AL-255/ventium/docs/FPGA_DOOM_2026-10-17.md

# FPGA Doom timedemo — 2026-10-17

**PASS: original DOS Doom shareware 1.9 completes DEMO3 at 20.50 FPS** on the
physical RK-XCZU15EG-F, measured **39.999830 MHz**, with **U/V + fast-pipe**.
This was a cold FreeDOS boot on the existing `2886d24c` image: no rebuild,
reprogramming, clock change, snapshot, guest patch, STEP or breakpoint.
It supersedes the [old image's startup failure](https://github.com/AL-255/ventium/blob/a4456e81/docs/FPGA_DOOM_2026-10-13.md), not
by substituting a slow/U-only control.

The fresh, closed `DOOM/DEMO3.LOG` reports:

```text
timed 2134 gametics in 3644 realtics
```

The original WAD's embedded DEMO3 independently contains exactly **2,134
single-player tics**. At 35 realtics/second, this is **104.114286 seconds** and
`35 × 2134 / 3644 = 20.496707 FPS`. This is rendered timedemo throughput,
not capture cadence or a higher-clock projection. See id Software's
[timedemo result path](https://github.com/id-Software/DOOM/blob/master/linuxdoom-1.10/g_game.c)
and [35 Hz tick definition](https://github.com/id-Software/DOOM/blob/master/linuxdoom-1.10/doomdef.h).
The normal timedemo result is intentionally emitted through Doom's `I_Error`
exit path; that result line is not a processor failure. The log's missing
external `DEMO3.lmp` notice is followed by playback of the embedded WAD demo.

## Workload and execution evidence

```text
DOOM -CONFIG BENCH.CFG -NOSOUND -TIMEDEMO DEMO3 > DEMO3.LOG
```

- **320×200, high detail**, `screenblocks 10` (full-width view with status bar),
  `usegamma 0`; sound disabled. Original executable/WAD hashes match before
  and after execution. Benchmark configuration and AUTOEXEC are unchanged.
- Passive captures show gameplay at 40, 80 and 120 seconds, followed by
  `DOOM_DEMO3_RETURNED` and the DOS prompt at 180 seconds. No visible error.
  Sixteen CRC-checked screenshots are retained, with original RGB332 colors;
  this run did **not** record a continuous movie.
- Both the owned native daemon and controller exit **0**, naturally, with no
  timeout, forced stop, debugger freeze or cleanup error. The disk is graded
  only after daemon exit; the original input contains **no DEMO3.LOG**.
- All **200 frozen source pins** match. The retained **159 defines** include
  `VEN_SYS_FASTPATH`, `VEN_SYS_FASTPATH_RELOC`, `VEN_SYS_FASTLOAD_FLAT`,
  `VEN_SYS_FASTLOAD_BOUNDED`, `VEN_SYS_FASTSTORE_FLAT` and `VEN_FE_PIPE`;
  the frozen shim connects `.cycle_mode(1'b1)`.
- Fresh run-wide counters prove at least **541,529,155 V retirements**:
  5,119,730,384 total U+V events minus at most 4,578,201,229 primary/U events.
  Each counter is baselined separately because primary/U survives guest reset
  while U+V does not. Both possible V-valid assertions in the pinned source
  reside in `core_fastpath.svh`'s S_PIPE path, proving actual fast pairing.
  These counts include boot and the idle DOS prompt, and count REP elements;
  **they are not a Doom gameplay IPC measurement**.

Current verified **Quake** gameplay IPC remains **0.496499864 total U+V** on
this same image, cycles **625,021,130,428–629,480,208,865**; primary/U alone is
0.383002768. See the [completed Quake run](FPGA_QUAKE_TIMEDEMO_2026-10-17.md).
Doom gameplay IPC is unmeasured, not substituted with that Quake number.

## Identity and retained artifacts

- Board: `riguke@rk-xczu15eg-f.local`; boot ID
  `2861e4e8-cd4c-48cd-9f44-7f7d8a991ebb`.
- Installed firmware: `ventium_programmable_clock_40_oct17_power_r5.bit.bin`;
  SHA256 `2886d24c5f9c84219f54e23a4766cfb7106f2999d28e794a0fd00256fd60cc52`.
  This is the frozen processor plus clock-only repair, not the dirty checkout;
  see [clock image provenance](../fpga/PROGRAMMABLE_CLOCK.md).
- Original DOOM.EXE:
  `b8020523561a5ad9706e009a52d61c578f37faafd85ac471962308406292ce27`.
- Original DOOM1.WAD:
  `1d7d43be501e67d927e415e0b8f3e29c3bf33075e859721816f652a526cac771`.
- Private input VHD:
  `81d08c99c66ad08cf9578811381001c7c156b7b33a17ea34012c77a6018dd576`;
  closed output:
  `aba703b7fea4928a3f08a7c2887c6bdd1dc67c3375909ab710191adc90f03f67`.
- Posted-write-safe daemon:
  `085c629bf84039f0dfd1983b9909026f0e18a811cf43730b68fb9d74357ee4d3`.
  Invocation `6053b418abab4a54a745686a365203c3`, controller/child PIDs
  64122/64127, verified exited before retrieval.

[Gameplay screenshot](/home/yukidama/external/tmp/ventium-doom-pll40-oct17.JU2dgKpE/frames/frame-005-t120.png),
[return to DOS](/home/yukidama/external/tmp/ventium-doom-pll40-oct17.JU2dgKpE/frames/frame-006-t180.png),
[complete guest log](/home/yukidama/external/tmp/ventium-doom-pll40-oct17.JU2dgKpE/DEMO3.LOG).

```text
/home/yukidama/external/tmp/ventium-doom-pll40-oct17.JU2dgKpE/
  package/                 11 pinned controller/helper scripts
  prepared.json            image, board-root and helper pins
  board-closed/            closed VHD, RAM/state/ring, logs, clock and samples
  board-closed.tar.gz       retrieved evidence archive
  frames/                  passive raw captures, metadata and PNG previews
  retrieve_closed.py       native ownership/closure and retrieval checker
  retrieval-verified.json  all 73 board-file hashes verified
  audit_closed.py          independent result/media/mode/source audit
  acceptance.json          PASS_COLD_FPGA_DOOM_DEMO3 and measured values
  DEMO3.LOG
```

Archive SHA256:
`1474a6112c329bd242550c34275ce4ddc682bdb4545fbd4644d35b1ee1d63b13`.
Log SHA256:
`805cecbb50f39d84a7c75161d732ffcd86dd1bf7b2b69662027d5568a6f9217f`.
The board evidence directory `/dev/shm/ventium-doom-pll40.Y2jSMDxl` is sealed
read-only after verified retrieval. Do not relaunch it or reuse its output disk
as pristine input. DDR reservation, PLL readiness and held-reset clock were
checked before guest initialization; all 11 helper hashes were verified.

Final board state: **guest held reset, posted DDR drained (`50440003`),
divide25/40 MHz PLL locked and enabled, no errors, no guest workers**.
This qualifies one cold, silent Doom timedemo. It does not qualify interactive
input, sound, the full standard suite/Win95, higher clocks or 40 MHz STA.
