AL-255/ventium/docs/fpga-synthesis.md

# FPGA synthesis & APR (KV260 / ZU15EG)

Real Vivado out-of-context synth → place → route results for the Ventium `core`,
with device views, the congestion analysis, and the config matrix. Summarized in
the [README](../README.md#fpga-synthesis-kv260); full detail here.

The core + FPU are fully synthesizable. Below is the **real Vivado placement** of
the `core` (out-of-context) on the KV260's **XCK26** (Zynq UltraScale+ ZU5EV,
`xck26-sfvc784-2LV-c`), every placed leaf cell colored by its RTL module — the
physical clusters (I-cache + the folded byte-window decode spine, FP datapath,
branch predictor, the iterative FP engines, the core spine, …):

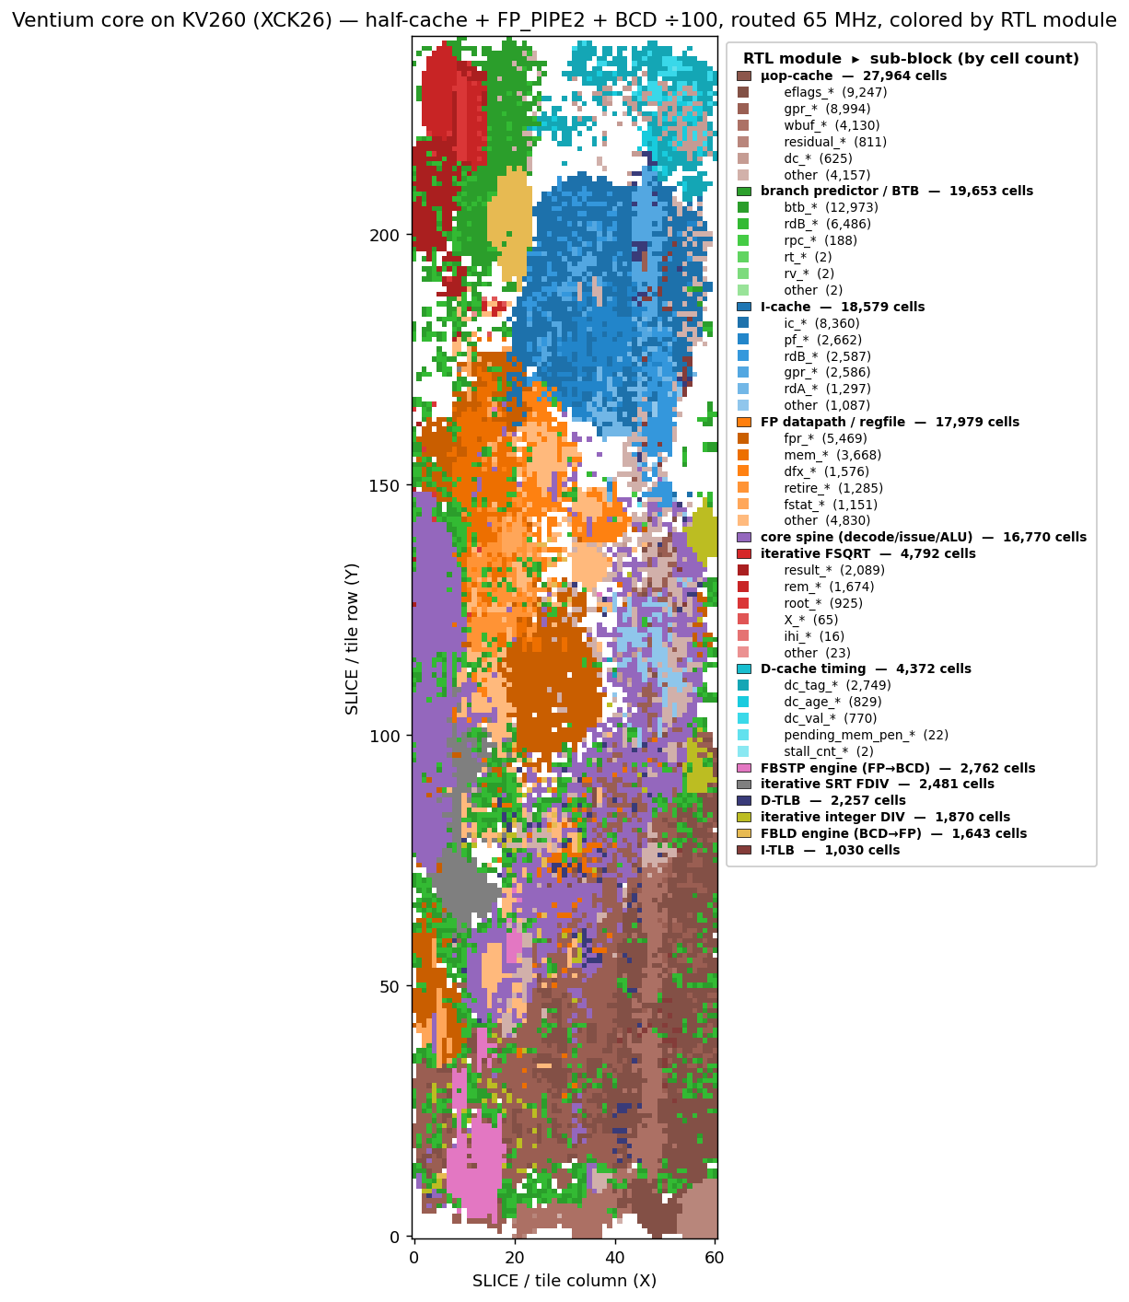
[picture p3: docs/fpga-device-view.png]
Ventium core placed on the KV260, colored by RTL module


The byte-window decode muxes (`u_icache`, the `-flatten_hierarchy rebuilt` instance
that absorbs the spine's 12×32:1 alignment fabric) are the **level-5 routing-congestion
hotspot** — the bright band in the placement-density map (peak ≈ 340 cells / 4×4-tile bin):

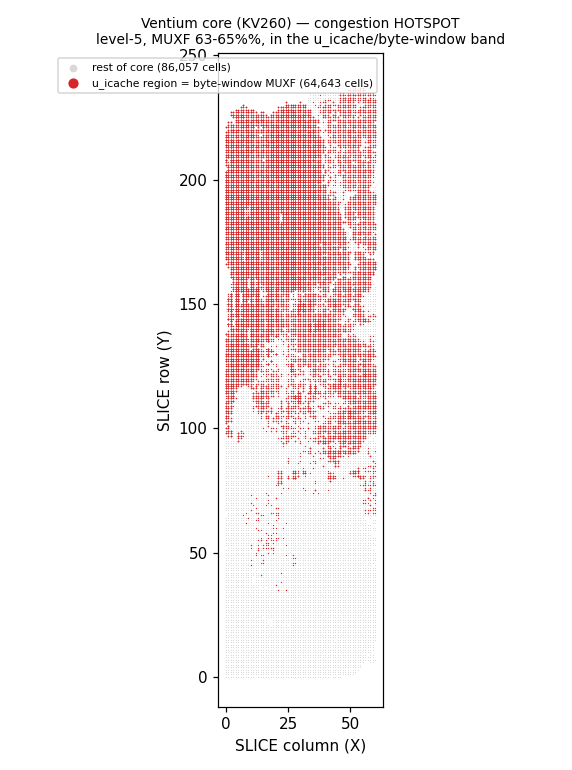
[picture p4: docs/fpga-congestion-hotspot.png]
placement density — the byte-window MUXF congestion band


**Best numbers** — OOC `core`, `+VTM_NO_DPI`, 15 ns target. Two configs: the
**verified production** config (narrowb, **bit-exact vs QEMU 75/75 + cycle bands**)
and the **experimental predecoded µop-cache** (`+VEN_UOPCACHE`, synth/APR-valid;
not yet verify-hardened) which deletes the byte-window decoder for a slot read:

| Resource | narrowb (production) | `+VEN_UOPCACHE` | Available |
|---|---:|---:|---:|
| **CLB LUTs (synth)** | 93,883 (80.2 %) | **79,442 (67.8 %)** | 117,120 |
| MUXF7 / MUXF8 | 14,311 / 6,216 | **11,101 / 4,181** | 58,560 / 29,280 |
| CARRY8 | 2,119 | 1,861 | 14,640 |
| DSP48E2 | 31 | 31 | 1,248 |
| Block RAM | 0 | 40 | 144 |
| **Fmax — logic only** | ~147 MHz (6.8 ns FP cone) | ~145 MHz | — |
| **Fmax — placed** (WNS@15 ns) | 46.0 MHz | 52.4 MHz | — |
| **Full route @ 15 ns** | ✗ does **not** route (42,392 overlaps) | ✅ **0 failed nets** | — |
| **Fmax — routed** (real OOC) | — (congestion wall) | **51.7 MHz** | — |

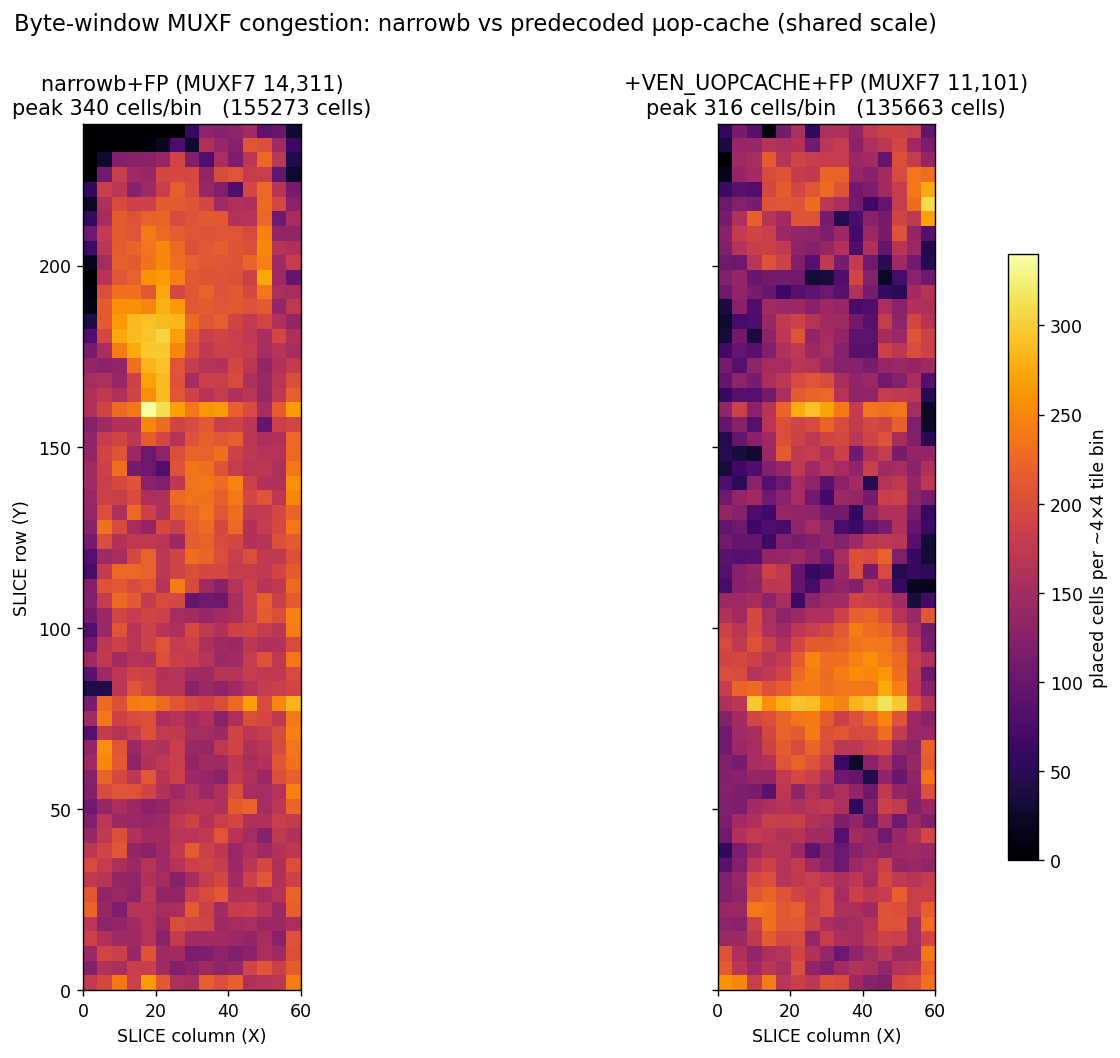
[picture p5: docs/fpga-rebalance-compare.png]
byte-window MUXF density: narrowb vs predecoded µop-cache, shared scale


**The headline APR result:** at a 15 ns target the **predecoded µop-cache routes cleanly to a
real 51.7 MHz** (0 failed nets, routed WNS −4.35 ns) — while the production byte-window config
**cannot route at all** (the router gives up with 42,392 congestion overlaps). The µop-cache is
the **first config to route the design legally at a tight clock**, vs the prior ~35–42 MHz
*estimate*. Caveat: `+VEN_UOPCACHE` is an Fmax/APR demonstrator — it is **synth/route-valid and
its FP/area changes are bit-exact, but the slot-read front-end is not yet functionally
verify-hardened** (the `uop_ready` stall + branch-into-middle re-predecode are unbuilt); the
**narrowb config is the verified-bit-exact 75/75 production build**.

- **Area — the FP datapath shrink ([`TIMING_PROBLEMS.md`](../fpga/TIMING_PROBLEMS.md) P0-13):
  −9,635 LUT (−10.7 %), bit-exact.** `fx_to_int_ex` (the FP→int conversion under FIST +
  FBSTP) carried a 128-bit barrel shifter where only 64 bits are ever non-zero — narrowing
  it bit-exactly (verified `make verify` 75/75) halved it across all five FIST/FBSTP
  instances (−8,636), plus a shared-round `f_eval` split (−999). The mantissa multiply was
  already in DSP (16 of 31 DSP48s), so it was never the LUT cost. Earlier wins: iterative
  FDIV/FSQRT/integer-DIV/FBSTP/FBLD engines + LUTRAM/BRAM caches brought the as-is 518 %
  single-cycle datapath under the device.
- **The predecoded µop-cache (P0-11) is the first lever to *reduce* the byte-window MUXF**
  (−22 % F7 / −33 % F8) instead of relocating it — by running the decoder on the multi-cycle
  fill walk and reading fixed-width µops by slot (the textbook P6/Sandy-Bridge fix; the user's
  "predecode prefixes 1 byte/cycle, pipeline the SIB length" insight). The *placer's* congestion
  level still reads level-5 (its density estimate is diffuse across the coupled front-end —
  BTB 23 %, icache 18 %, slow-path decoder 13 %, …), but that metric is misleading: the **actual
  router converges (0 overlaps) for the µop-cache and not for narrowb (42,392)** — the lower MUXF
  gives the router the channels it lacked. The route is the judge ([P0-14](../fpga/TIMING_PROBLEMS.md)).
- **Fmax: the design is routing-congestion-bound, not logic-bound.** The worst path is the FP
  deferred-commit cone `fpp_reg → fpr` at ~6.8 ns *logic* (≈147 MHz) but **65 % routing** — the
  byte-window/front-end MUXF cluster has no spare channels. Placed: **46.0 MHz (narrowb) /
  52.4 MHz (µop-cache)**. A full Vivado strategy sweep (P0-9: `-muxf_remap`, AltSpreadLogic,
  AlternateRoutability, the congestion strategies) closes **none** of it — an architectural
  property of the single-cycle x86 byte-window decode, not a tooling choice.
- **The honest path to 66 MHz** (P0-12): the OOC placer has no PS8 anchor / floorplan, so it
  smears the whole `eip`-coupled front-end into one clock region. The cure for *diffuse-coupled*
  congestion is **in-context place + floorplan** (spread the cluster across regions near the
  PS8) — the real-chip number we must measure to ship — or a lower-utilization / higher-grade
  device. A **2-stage FP execute pipeline** (`+VEN_FP_PIPE`) and a **BTB-update pipeline**
  (`+VEN_BTB_PIPE`) keep FP + branch-predict off the critical path with **both FP and
  branch-mispredict cycle bands bit-identical**.

### On a larger device (ZU15EG): the verified production config routes

The **same verified `narrowb` production RTL**, OOC on a **Zynq UltraScale+ ZU15EG**
(`xczu15eg-ffvb1156-2LV-e`, same `-2LV` speed grade as the KV260, but ~3× the fabric:
341,280 LUTs), placed by module:

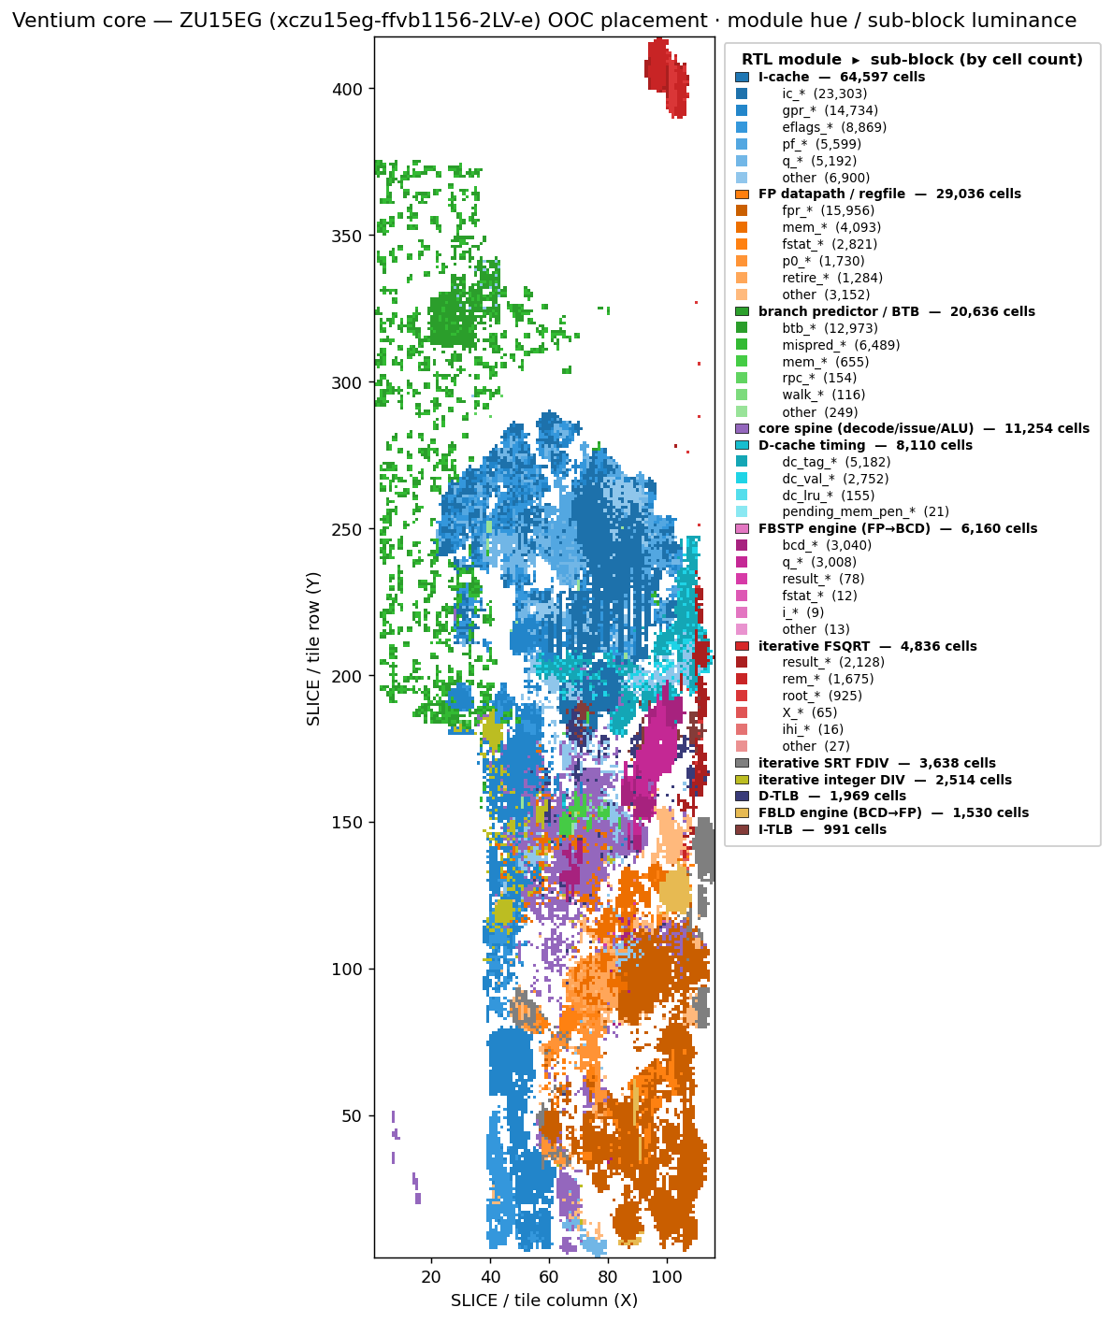
[picture p6: docs/fpga-device-view-zu15eg.png]
Ventium core placed on the ZU15EG, colored by RTL module


**The headline:** at the *same* 15 ns target, the production `narrowb` config — which is
**bit-exact-verified but cannot route on the KV260** (42,392 congestion overlaps, router
gives up) — **routes cleanly on the ZU15EG** (router converges: **0 overlaps, 0 unrouted
nets**). The 3× routing fabric gives the byte-window front-end the escape channels it lacks
on the small part. This is the first clean route of the *verified* build at a tight clock.

| Resource | KV260 `narrowb` (XCK26 / ZU5EV) | **ZU15EG `narrowb`** (`xczu15eg-…-2LV`) |
|---|---:|---:|
| CLB LUTs | 93,883 (**80.2 %** of 117,120) | 93,961 (**27.5 %** of 341,280) |
| CLB Registers | 28,675 | 29,394 (4.3 %) |
| MUXF7 / MUXF8 | 14,311 / 6,216 | 14,312 / 6,216 |
| CARRY8 / DSP48E2 / BRAM | 2,119 / 31 / 0 | 2,119 / 31 / 0 |
| Placer congestion | level 6 (wall) | level 5 (local, `u_icache` byte-window) |
| **Full route @ 15 ns** | ✗ **does not route** (42,392 overlaps) | ✅ **routes — 0 overlaps / 0 unrouted** |
| Fmax — placed (WNS@15 ns) | 46.0 MHz | 51.1 MHz (WNS −4.56 ns) |
| **Fmax — routed (real OOC)** | — (never routed) | **40.6 MHz** (WNS −9.60 ns) |

The routed **40.6 MHz** is the honest critical-path number — lower than the placer's 51 MHz
*estimate* because actually wiring the congested byte-window region costs real routing delay,
and lower than the ~148 MHz logic-only ceiling (the FP cone is **6.74 ns**). The placer still
flags **level-5 congestion local to `u_icache`** even on the big device — confirming the wall
is the **single-cycle x86 byte-window decode itself**, an architectural property, not a device
or tooling limit. The bigger part buys *routability* (and a clean, shippable bitstream path),
not a dramatically higher clock; closing toward 66 MHz still needs the µop-cache front-end
([P0-11](../fpga/TIMING_PROBLEMS.md)) and in-context floorplanning ([P0-12](../fpga/TIMING_PROBLEMS.md)).

Reproduce — KV260: `CONFIG=narrowb MODE=full vivado -mode batch -source fpga/scripts/apr_run.tcl`;
ZU15EG: prepend `PART=xczu15eg-ffvb1156-2LV-e OUTTAG=_zu15eg`. Then
`python3 fpga/scripts/render_device_view.py …` / `render_congestion.py` / `render_compare.py`.
Full timing backlog + methodology in [`fpga/TIMING_PROBLEMS.md`](../fpga/TIMING_PROBLEMS.md).

### Half-cache variant (`+VEN_CACHE_HALF`): congestion relief ≠ higher Fmax

A clean experiment to test whether the `u_icache` congestion is the Fmax wall: halve
both L1s to **4 KB** (64 sets / 21-bit tag instead of 128 / 20), gated behind
`+VEN_CACHE_HALF` so the default build stays byte/cycle-identical (`addr[5 +: 7]` is
literally `addr[11:5]`). The cache is a hit/miss + data store, so smaller just means
more fills, same bytes — **functionally bit-exact**: both the default *and* the
`+VEN_CACHE_HALF` builds pass `make verify` **77/77** vs QEMU (the 64-set geometry is
confirmed in the elaborated netlist). It is **not** a cycle-fidelity config — the
fixed-128-set cycle oracle no longer matches the miss sequence — so the M4/M5 bands are
only claimed for the default build. Run on the **µop-cache** base (`+VEN_UOPCACHE`, the
config that routes), same KV260 part / 15 ns target:

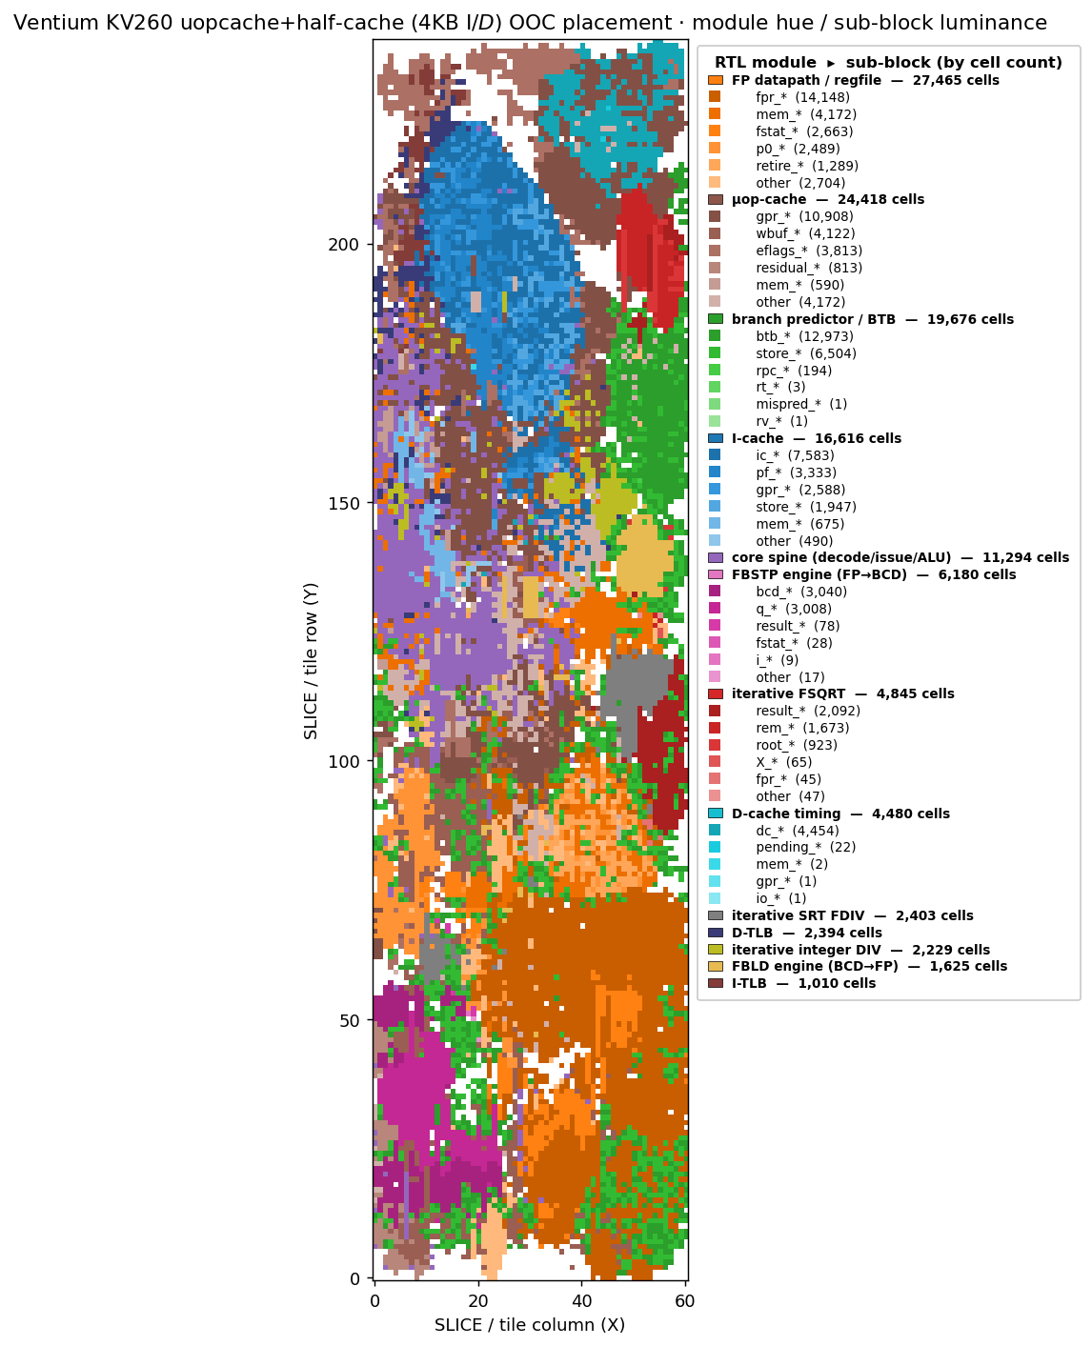
[picture p7: docs/fpga-device-view-kv260-halfcache.png]
Ventium KV260 µop-cache + half-cache, placed by module


| Metric (routed OOC, KV260, 15 ns) | µop-cache **full** (8 KB) | µop-cache **half** (4 KB) | Δ |
|---|---:|---:|---:|
| `u_icache` placed cells | 30,413 | 16,616 | **−45 %** |
| F7 / F8 muxes | 11,101 / 4,181 | 7,906 / 3,192 | **−29 % / −24 %** |
| CLB LUTs | 79,722 | 77,547 | −2.7 % |
| BRAM tiles | 40 | 40 | 0 |
| Placer congestion | **level 6** (`u_icache` 86–96 %) | **level 5** (`u_icache` 87 %, now sharing with FP/BTB) | ↓ one level |
| Failing endpoints / TNS | 21,095 / −51,509 ns | **16,221 / −32,019 ns** | **−23 % / −38 %** |
| **Fmax — routed** | **51.7 MHz** (WNS −4.35 ns) | **50.1 MHz** (WNS −4.94 ns) | ≈ flat |

**The finding is the point:** halving the cache does exactly what it should to *congestion*
— `u_icache` cells −45 %, the F7/F8 read-mux trees −25–29 %, placer level 6 → 5, and the
**bulk** of timing improves sharply (failing endpoints −23 %, TNS −38 %). But routed
**Fmax barely moves** (51.7 → 50.1 MHz, within placement noise), because the **worst path is
not the cache** — it is the FP deferred-commit cone `fpp_b_reg[66] → u_fpu_state/fpr_reg`,
which the smaller cache doesn't touch. So the icache congestion gates *routability and the
endpoint tail*, while the *single critical path* is FP-datapath-bound. Closing toward 66 MHz
needs the FP cone pipelined, not less cache — and shrinking the cache is a real area/tail win
that's free to keep (functionally verified), just not the Fmax lever. Reproduce:
`HALF=1 CONFIG=uopcache MODE=full OUTTAG=_half vivado -mode batch -source fpga/scripts/apr_run.tcl`.

### Half-cache to 60 MHz: the 2-stage FP commit (`+VEN_FP_PIPE2`)

The half-cache section above ends on the diagnosis that the Fmax wall is the FP
deferred-commit cone, not the cache. This closes it. Every leaf cell of the **63 MHz**
build, colored by RTL module (luminance = sub-block):

Ventium core on the KV260, half-cache + FP_PIPE2, routed 63 MHz

**The lever — measured, not guessed.** A timing-driven P&R sweep over the half-cache
checkpoint (one synth, many place/route directives, all over-constrained @ 15 ns) lifts
the routed Fmax from the production congestion directives' **50.1 → 52.6 MHz**
(`ExtraNetDelay_high` place + `Explore` route) — but no directive, Pblock, or retiming
clears the wall, because the binder is **logic depth, not routing**: the deferred FADD
commit runs the *entire* `f_eval` (`f_eval_s1` front → `f_eval_s2` round-pack) in one
clock — a **latency-1, ~80-level / ~43-CARRY8** cone `fpp → fx_round_pack → fpr`. P&R can
only redistribute route delay on it; retiming can't split a latency-1 path (one register
layer, nothing to balance); synthesis itself caps at 59.4 MHz.

`+VEN_FP_PIPE2` splits the cone. It inserts **one register** (the `fx_pipe_t` carrier) at
the `f_eval_s1`/`f_eval_s2` boundary, so the fast-arm commit becomes two clocks — `s1` at
N+1, the round-pack + `fpr` write at N+2. The key enabler is that the **FP scoreboard
already publishes the result at issue+latency (FADD = 3)** independent of when the deferred
commit physically writes `fpr` (`core.sv`): the commit moves N+1 → N+2, still ≤ issue+3, so
every dependent reads the value in time. That makes it **cycle-safe by construction** — not
a cycle-model change:

| Check | Result |
|---|---|
| `make verify` (default build, no `VEN_FP_PIPE2`) | **GREEN** — default byte/cycle-identical |
| A/B cycle trace, `mb_faddchain` (`make verify-fppipe2`) | **byte-identical** to the validated 1-stage |
| A/B `mb_fpindep` | **identical final arch state**; +0.09 % cyc (in M5 band) |
| M5 FP cycle bands (faddchain CPI ~3, fpindep < that) | **held** |
| 1M-vector `f_eval_s2∘f_eval_s1 == f_eval` | **bit-exact** |

The result (same 15 ns target, half-cache µop-cache base):

| Metric (routed OOC, KV260) | half (1-stage `VEN_FP_PIPE`) | half **`+VEN_FP_PIPE2`** | Δ |
|---|---:|---:|---:|
| CLB LUTs (synth) | 77,975 (66.6 %) | 76,700 (65.5 %) | −1.6 % |
| CLB Registers | 25,565 | 25,838 | +273 FF (the pipe reg) |
| CARRY8 / DSP / BRAM | 1,862 / 31 / 40 | 1,866 / 31 / 40 | ≈ 0 |
| **Fmax — synth** (WNS@15 ns) | 59.4 MHz | **78.4 MHz** | **+32 %** |
| **Fmax — routed** | 52.6 MHz (best directive) | **63.0 MHz** | **+20 %** |
| Worst path | `fpp → fx_round_pack → fpr` | `u_bcd` (BCD/FBSTP engine) | cone gone |

So the FADD cone leaves the critical path entirely (synth 59→78 MHz), and the routed build
clears **60 MHz at 63.0** — the worst path is now the rare iterative **BCD engine** (`u_bcd`,
FBLD/FBSTP), with the µop-cache `store_bmap → eip` fill path just below it. Cost: ~**+273
flip-flops** (one `fx_pipe_t` stage register), LUT-neutral. The default build is untouched —
all new logic is under `ifdef VEN_FP_PIPE2`. Reproduce: `STAGE=synth FP_PIPE2=1` then
`STAGE=pnr FP_PIPE2=1 STRAT=fp2_timingopt PLACE_DIR=ExtraTimingOpt ROUTE_DIR=Explore vivado
-mode batch -source fpga/scripts/apr_hc_pnr.tcl`; cycle-safety via `make verify-fppipe2`.

#### Next worst path: the BCD step (÷100, not two ÷10) → 65.3 MHz

With the FADD cone gone, the `u_bcd` engine (FBSTP, FP→packed-BCD) becomes the worst path:
its per-clock step ran **two chained divide-by-10** (`q/10` then `q1/10`), ~54 levels / ~41
CARRY8 in series. Computing **one divide-by-100** instead and taking the two low digits from
`q%100` (a 0..99 value → a 7-bit extract) halves that cone — **bit-exact and cycle-neutral**
(same 2-digits/clock cadence, `make verify-bcd` 40 k vectors). Synth rises **78.4 → 80.6 MHz**
and the binder moves to the FP_PIPE2 stage-1 front (`fpp → fpp2_s1`). Routed, with
`ExtraNetDelay_high` placement (the right placer once the wall is route-bound), the half-cache
build reaches **65.3 MHz** — the worst path now the **µop-cache fill → front-end cluster**
(`store_bmap → eip`/`ic_age`/`store_slots`, 64–73 % routing). That cluster is route-bound and
**placement-variable** (45–65 MHz across directives; `ExtraTimingOpt` and forced fanout
replication both place it worse) — the diffuse front-end congestion that P0-12 (in-context
floorplan) targets, not a single combinational cone. Reproduce: `STAGE=pnr FP_PIPE2=1
STRAT=fp2b_netdelay PLACE_DIR=ExtraNetDelay_high ROUTE_DIR=Explore`; `make verify-bcd`.

> The ÷100 step is now **opt-in (`+VEN_BCD_DIV100`)**: it only helps when `u_bcd` is the worst
> path (this OOC half-cache config), and in the full SoC below the front-end cluster binds long
> before `u_bcd` does — so the default leaves it off (back to two chained ÷10), keeping `u_bcd`
> smaller where it isn't critical. Both forms are bit-exact (`make verify-bcd` either way).

## Full SoC, in-context: the front-end pipeline (`+VEN_FE_PIPE`) → the deployable image

Everything above is **out-of-context** (the `core` alone, virtual I/O). The deployable image is
the **full KV260 block design**: the core + FPU wrapped with the **L1/AXI memory subsystem**
(`ventium_l1_axi`: `ven_l1d` → `ven_axi_master` → AXI4 to PS-DDR), the **`ven_soc_axil`** PS↔PL
control / port-I/O bridge, and the SmartConnect interconnect — all placed *in context* against the
PS8 hard block and routed to a **bitstream + `.xsa`** at a 60 MHz `pl_clk0` target
(`fpga/scripts/impl_kv260_soc.tcl`). The in-context routing demand is much higher than OOC, and a
new module (the front-end translate path) binds.

**The dcache-timing removal (prerequisite).** Under `VEN_L1_AXI` the old `dcache_timing` block
(~4.4 k cells) only fed the cycle-mode D-miss penalty, which `real_bus` suppresses — it never
touches data. Gating it out (`ifndef VEN_L1_AXI`) is inert (default build identical) and drops the
post-place LUT congestion **79 % → 76 %**. Necessary, not sufficient: it does not, by itself,
route.

**The wall, and the cut.** With dcache-timing gone the full SoC still would **not legally route**
at 60 MHz — Vivado abandons routing with *"Design is not legally routed. There are 8766 node
overlaps."* The binder is the `eip` fetch cone: every fetch re-runs the 16-entry I-TLB
carry-chain compare (`itlb hit_of → xlate_miss → eip`) combinationally, and in context that cone's
fanout congests the front-end region past what the router can resolve. **`+VEN_FE_PIPE`** breaks
it with a **page-keyed micro-TLB**: a 1-entry register (`fe_itlb_q`/`fe_dtlb_q`) keyed on
`cur_lin[31:12]` holds the resolved translation for the current 4 KiB page, so steady-state fetch
reads a registered phys page instead of re-walking the TLB compare. A page crossing asserts
`fe_xlate_pend` for exactly **one clock** while the register re-samples (the only added latency;
zero within a page, zero in real mode). It is `ifdef`-gated — default build byte/cycle-identical,
`make verify` GREEN — and an **Fmax-only demonstrator** (cycle bands not claimed with it on, since
the page-crossing stall perturbs cycle counts by < ~1 %; architecturally bit-exact throughout).

The same SoC, same 60 MHz target, the cut on vs off:

| Full-SoC impl (in-context, KV260, `pl_clk0` 60 MHz) | dcache-removal only | **`+VEN_FE_PIPE`** |
|---|---|---|
| Route result | **FAILED** — 8766 node overlaps (illegal) | **Router Completed Successfully** |
| WNS @ 60 MHz | — (never closed) | **−3.195 ns** |
| **Routed Fmax** | — (~41 MHz wall, no legal route) | **~50.4 MHz** |
| CLB LUTs | — | 83,117 (71.0 %) |
| CLB Registers / BRAM / DSP | — | 31,178 (13.3 %) / 40 / 31 |
| Bitstream + `.xsa` | not produced | **produced** (deployable) |

So `+VEN_FE_PIPE` takes the full SoC from *no legal route at all* to a clean **~50 MHz** image —
the `eip`/TLB translate cone leaves the critical path exactly as designed. The **new** worst path
is `u_uopcache/store_bmap → eip_reg[26]` (19.81 ns, **62 % routing** / 38 % logic, 47 levels) — the
*same* µop-cache fill→front-end cluster the OOC 65.3 MHz build hit. The remaining wall is therefore
**route-bound, not logic-bound** — diffuse fill→`eip` routing congestion at ~68–71 % LUT, not a cone
P&R or floorplanning can shorten.

**Decision history: 60 MHz dropped as infeasible; 50 MHz closed; the F3 boot-ISA growth then
moved the deployable to 40 MHz.** The OOC core ceiling is 65.3 MHz, but the full SoC's extra
L1/AXI + BD interconnect spends the margin, and the residual congestion is diffuse (not a single
cone), so no realistic in-context floorplan closes 60 on this small ZU5EV die. The `+VEN_FE_PIPE`
build first closed **50 MHz** (WNS +0.19 ns — razor thin). The F3 real-mode decode work (16-bit
ModR/M EA, FF-group far transfers, SS-defaults, a16 string semantics) then grew the decoder
enough that the same high-fanout `u_uopcache/store_bmap` net routes ~3.5 ns slower and 50 MHz
stopped closing (WNS −3.2 ns). `pl_clk0` is now **40 MHz** (`PL0_MHZ`, `impl_kv260_soc.tcl`),
which routes with margin. A larger part (the ZU15EG, which clears the OOC build comfortably)
would hold 60+; on the K26, **40 MHz is the deployable we keep** — with `sw/ps/ven_soc_app/
venclk.sh` as the PS-side silicon-margin probe (steps the PL0 divider 40→50 MHz with a
gate-proven firmware smoke test per step).

**The current deployable** (`fpga/build/kv260_soc_impl_linux_40/`, the image the SD cards carry —
uop-cache + IC-BRAM + half-cache + FP_PIPE2 + FE_PIPE + L1_AXI + the PS→core IRQ seam, with
`REMAP_BASE=0x4000_0000`): routed at the 40 MHz target with **WNS +0.104 ns / WHS +0.008 ns, 0
failing endpoints** — CLB LUTs **94,712 / 117,120 (80.9 %)**, registers 31,208 (13.3 %), BRAM 40
(27.8 %), DSP 31 (2.5 %), CLB occupancy 98.3 %. The device views below are rendered from this
routed checkpoint.

Every leaf cell of the routed full SoC, colored by RTL module (core blocks + the L1/AXI + PS-bridge
+ BD interconnect that OOC views omit):

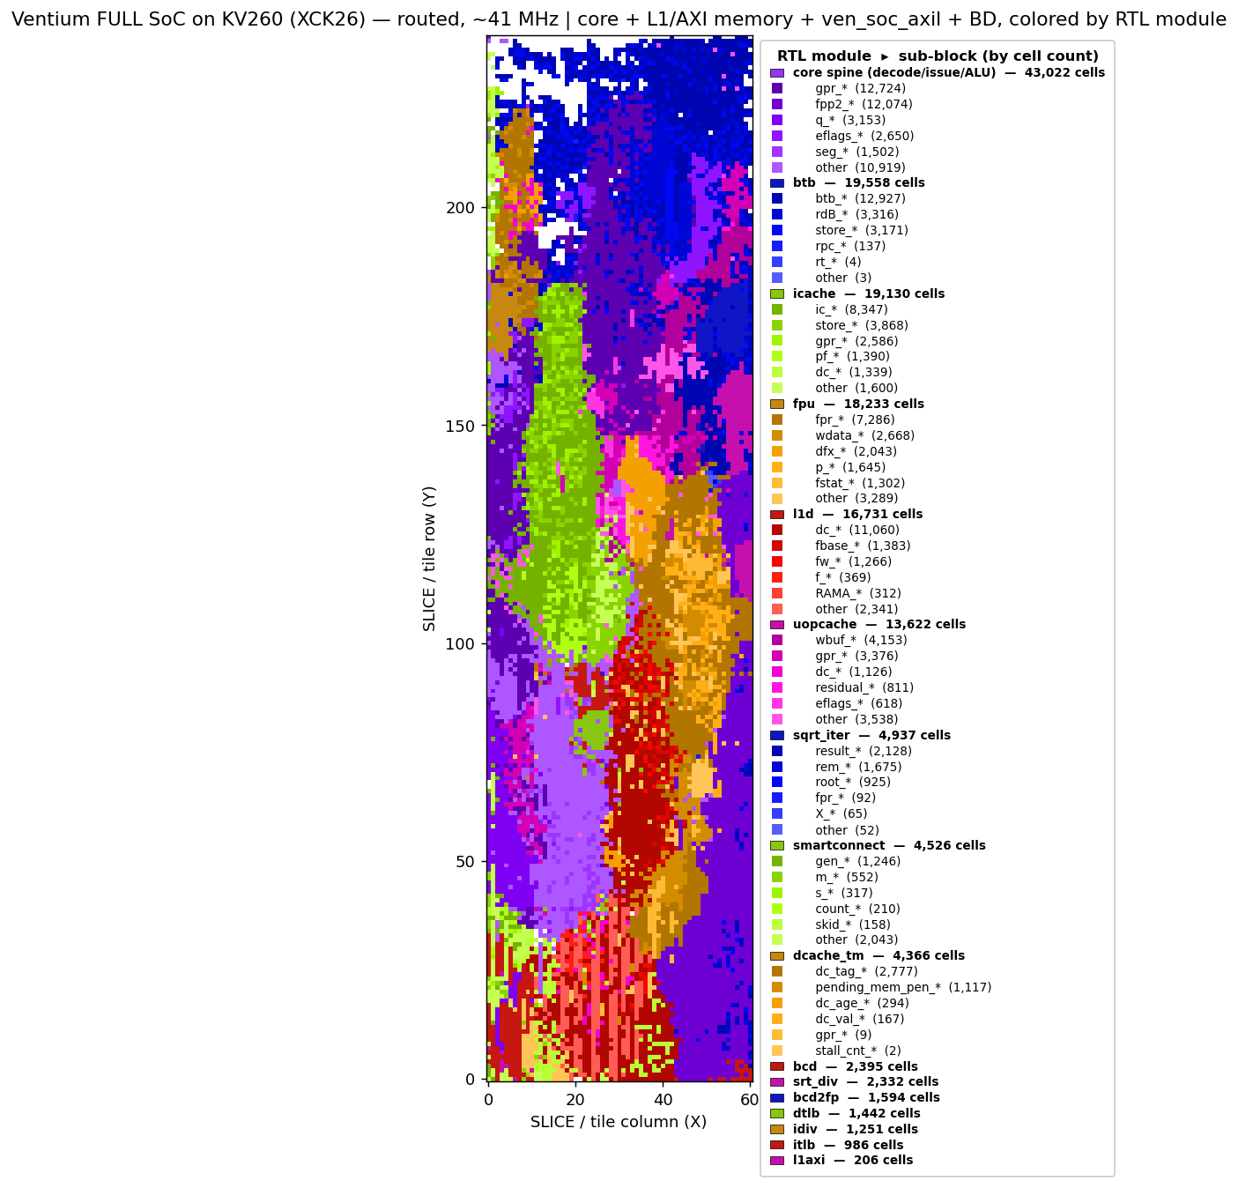
[picture p8: docs/fpga-device-view-soc.png]
Ventium full SoC on the KV260, routed @ 40 MHz, colored by module


The two halves separated — the CPU core + FPU (memory/BD grayed), and the memory/PS/BD outside it
(core grayed):

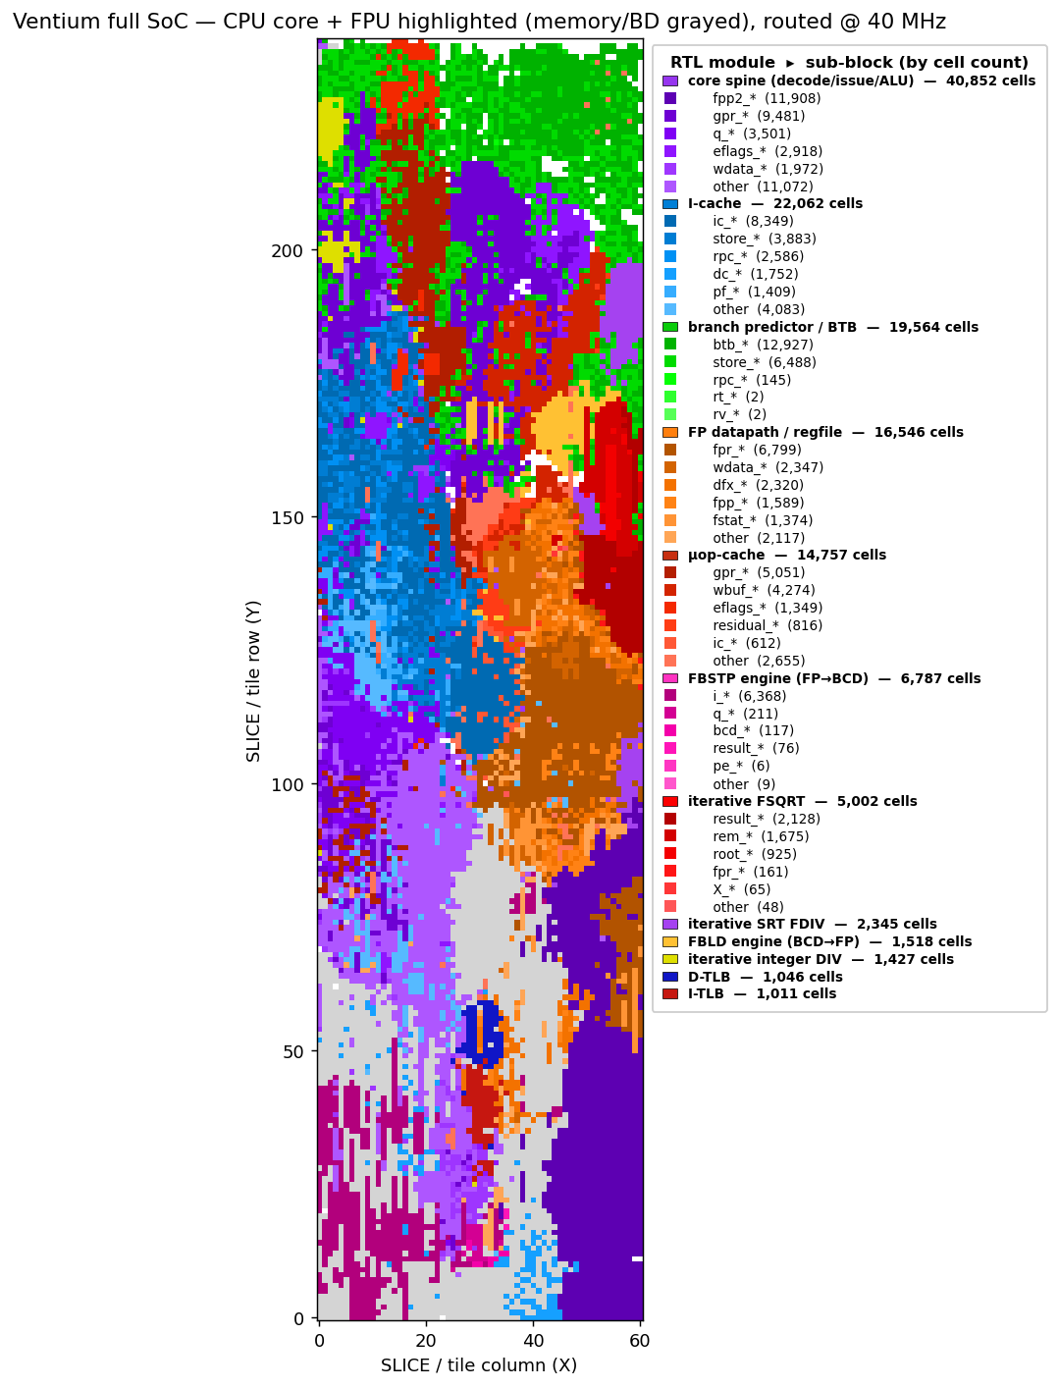
[picture p9: docs/fpga-device-view-soc-core.png]
Full SoC — CPU core + FPU highlighted

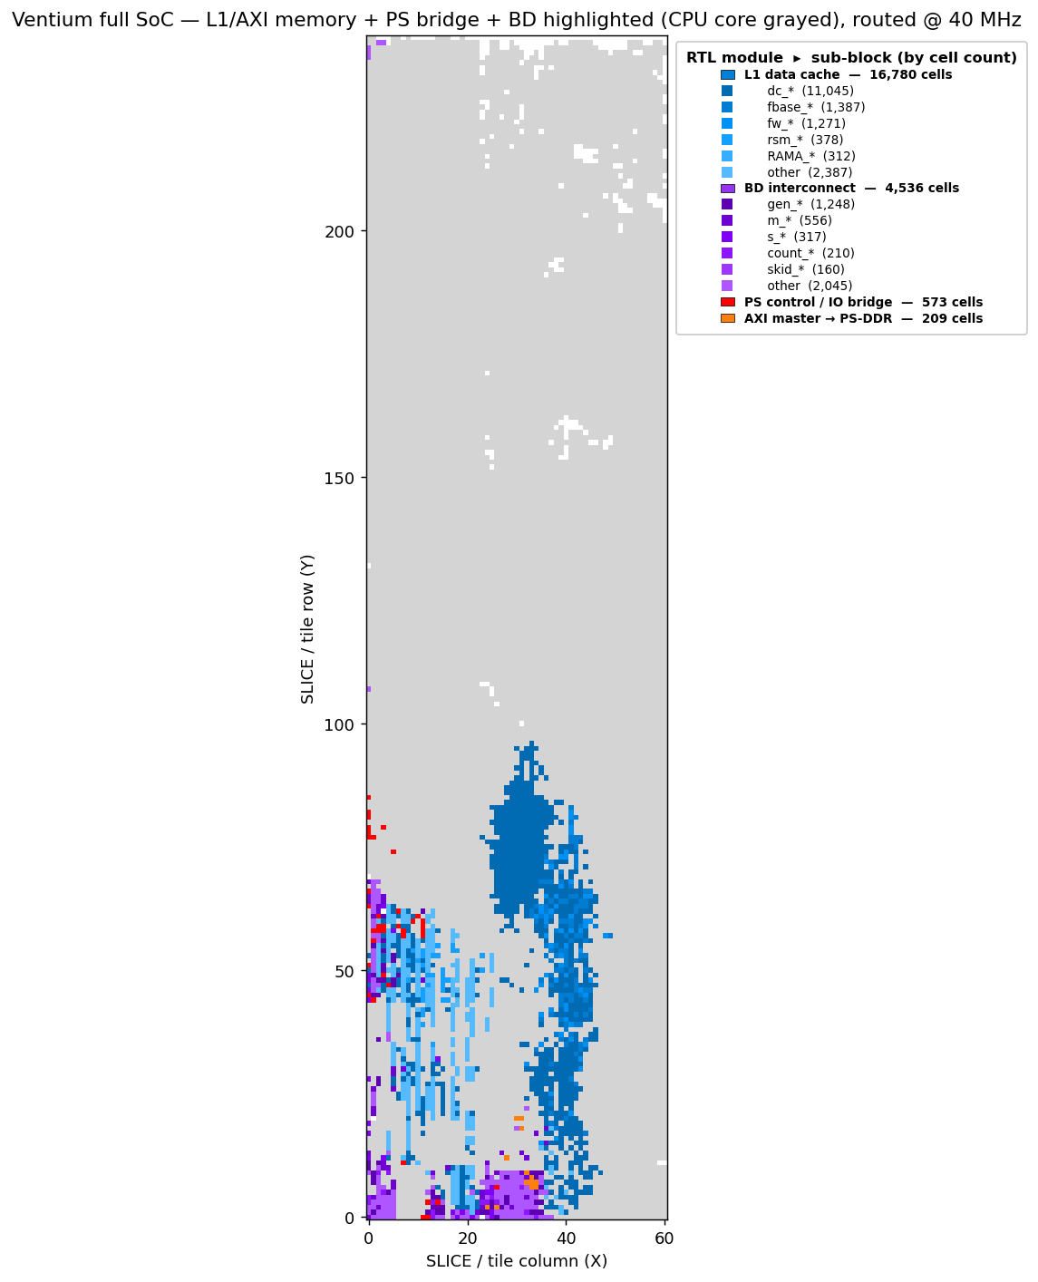
[picture p10: docs/fpga-device-view-soc-outside.png]
Full SoC — L1/AXI memory + PS bridge + BD highlighted


Placement density and router-congestion concentration of the routed image — the bright band is the
µop-cache fill→`eip` front-end cluster that now binds:

Full SoC — placement density
Full SoC — router congestion concentration

Reproduce: `FE_PIPE=1 OUTTAG=_fe /tools/Xilinx/2025.2/Vivado/bin/vivado -mode batch -source
fpga/scripts/impl_kv260_soc.tcl` (bitstream + `.xsa`); device views + congestion from the routed
checkpoint via `DCP=<...>_routed.dcp OUT=<...> vivado -mode batch -source fpga/scripts/soc_views.tcl`
then the `render_device_view.py` / `render_congestion*.py` scripts.
