AL-255/ventium/docs/isa-coverage.md

# Ventium ISA Coverage Matrix

Status of the integer (one-byte + `0F` two-byte) and x87 ISA as actually decoded
in `rtl/core/core.sv`. This replaces the unqualified "full integer ISA" claim
flagged in `REVIEW_Jun5.md` §1 with a machine-checkable family-by-family table.

**Scope line:** Ventium implements a broad IA-32 / P54C integer subset plus a
normal-operand x87 datapath. **Instructions not listed as IMPLEMENTED HALT
loudly (no silent misexecution):** any decode path that does not match an
implemented arm falls to a `default` (or guarded `else`) that sets
`d_unknown=1'b1`, which routes the FSM to `S_HALT` (`core.sv:19`,
`core.sv:2029`, `core.sv:1281`). A HALT is never a wrong retire — it is a hard
stop, so the differential gate cannot mistake an unimplemented opcode for a
clean run.

## How the HALT set is derived

Status is read directly from decode in `rtl/core/core.sv`. An instruction is:

- **IMPLEMENTED** — its opcode has a decode arm that sets a real `d_kind` /
  `d_sysop` / `d_fxop` / branch fields and never reaches `d_unknown` on that
  path.
- **PARTIAL** — implemented for the forms the corpus needs, but specific
  sub-forms (a `mod`/`reg` subcase, a non-default operand class, or a
  mode/feature gate) fall to `d_unknown` and HALT, OR an architectural detail
  (e.g. `#DE` on divide-by-zero) is not raised.
- **HALT (deferred)** — every decode path for that opcode sets `d_unknown=1'b1`
  (or it has no arm and hits the one-byte `default` at `core.sv:2029`). These
  are the real coverage gaps.

The HALT gaps below were confirmed by grepping every `d_unknown=1'b1`
occurrence in `core.sv` and reading the guarding opcode/comment.

---

## Integer — one-byte opcodes

| Family | Opcodes | Status | Evidence (core.sv) |
| --- | --- | --- | --- |
| ALU r/m,r,imm (ADD/OR/ADC/SBB/AND/SUB/XOR/CMP, group-1 `80/81/83`) | 00–3D, 80–83 | IMPLEMENTED | fast path `S_PIPE` + slow `K_ALU`; flags QEMU-matched |
| INC/DEC/PUSH/POP r (single-byte) | 40–5F | IMPLEMENTED | `K_*`/`K_STKMISC` arms |
| PUSHA / POPA | 60 / 61 | IMPLEMENTED (modeled by effect) | `K_STKMISC` SM_PUSHA/SM_POPA, micro-sequenced in `S_USEQ` (`core.sv:1311-1312`; exec `core_exec.svh:479`) |
| PUSH imm / IMUL r,r/m,imm | 68/6A, 69/6B | IMPLEMENTED | `K_IMUL2` 3-op (`core.sv:1322,1336`) |
| INS / OUTS (string port I/O) | 6C/6D | IMPLEMENTED (cosim/co-sim gated) | `K_STR` ST_INS (`core.sv:1586`) |
| Jcc rel8 | 70–7F | IMPLEMENTED | branch decode |
| MOV / TEST / XCHG / LEA r/m | 88–8D, 84–87 | IMPLEMENTED | `K_MOV`/`K_ALU`/`K_LEA` |
| NOP / XCHG eAX,r | 90–97 | IMPLEMENTED | `core.sv:1494` |
| CWDE/CDQ, PUSHF/POPF, SAHF/LAHF | 98/99, 9C/9D, 9E/9F | IMPLEMENTED (PUSHF/POPF modeled by effect via `S_USEQ`) | `K_STKMISC` SM_PUSHF/SM_POPF (`core.sv:1500-1501`) |
| MOV moffs, string MOVS/STOS/LODS/SCAS/CMPS | A0–A3, A4–A7, AA–AF | IMPLEMENTED (string = modeled by effect, REP via `S_USEQ`) | `K_STR` arms (`core.sv:1561-1570`) |
| MOV r,imm | B0–BF | IMPLEMENTED | `core.sv:1285,1290` |
| Shift/rotate group-2 imm8 | C0/C1 | IMPLEMENTED | shift decode |
| RET near (+imm16) | C2 / C3 | IMPLEMENTED (modeled by effect) | `K_CTRL` CT_RETN/CT_RETN_IMM (`core_exec.svh:548-555`) |
| LEAVE / ENTER, MOV r/m,imm | C8/C9, C6/C7 | IMPLEMENTED | `K_*` arms; `t_leave16` |
| INT3 / INT n / INTO / IRET | CC / CD / CE / CF | PARTIAL — IMPLEMENTED in **system mode** (IDT delivery); HALT in user mode (no IDT) | `core.sv:1763,1769,1780,1786` — user path sets `d_unknown` (except `INT 0x80` proxy) |
| Shift/rotate group-2 by 1 / CL | D0–D3 | IMPLEMENTED | `core.sv:1620` |
| **BCD / ASCII adjust: DAA / DAS / AAA / AAS / AAM / AAD** | **27 / 2F / 37 / 3F / D4 / D5** | **IMPLEMENTED (review response, QEMU-exact)** | `K_ALU` `ALU_DAA..ALU_AAD` decode (`core.sv:1509-1520`); exec (`bcd_ax`/`bcd_flags` block) matches QEMU `helper_aaa/aas/daa/das/aam/aad` exactly (`core.sv:2356-2439`). Undefined flags masked via `tracefmt.eflags_undefined_mask`. `AAM` base-0 `#DE` is deferred (quotient/remainder guarded to 0, like native DIV-by-zero — `core.sv:2422-2423`) |
| x87 escapes | D8–DF | PARTIAL (see x87 table) | `core.sv:1853` |
| LOOP/LOOPE/LOOPNE/JCXZ | E0–E3 | IMPLEMENTED | `K_CTRL` CT_LOOP* (`core_exec.svh:556`) |
| IN/OUT imm8 / DX | E4–E7, EC–EF | IMPLEMENTED (out-of-cosim non-`out 0xf4` HALTs) | `core.sv:1824-1842` |
| CALL rel / near JMP rel / far JMP | E8 / E9/EB / EA | IMPLEMENTED (CALL = modeled by effect) | `K_CTRL` CT_CALLREL (`core.sv:1737`); far JMP `SYS_LJMP` (`core.sv:1794`) |
| HLT | F4 | IMPLEMENTED (stops retiring) | `d_halt` (`core.sv:1810`) |
| CLC/STC/CLI/STI/CLD/STD, group-3 (TEST/NOT/NEG/MUL/IMUL/DIV/IDIV), group-4/5 (INC/DEC/CALL/JMP/PUSH) | F5–FF | IMPLEMENTED (MUL/DIV native — see PARTIAL note) | `K_MULDIV` (`core.sv:1684`); CALL-ind `core.sv:1702` |
| **MUL/IMUL/DIV/IDIV (group-3)** | F6/F7 /4–/7 | **PARTIAL — architecturally correct result, but DIV/IDIV do NOT raise `#DE` on divide-by-zero or quotient-overflow** | native `* / %` in single `S_EXEC` arm, no `srcv==0` guard (`core_exec.svh:214-284`) |

### Integer one-byte HALT (deferred) gaps

There are **no whole-opcode one-byte integer HALT gaps** in the current decode.
The BCD/ASCII adjusts (`0x27/0x2F/0x37/0x3F/0xD4/0xD5`) flagged in the review
have been implemented as the review response (see the integer table) — they now
decode to `K_ALU` `ALU_DAA..ALU_AAD` (`core.sv:1509-1520`) and no longer fall to
the one-byte `default` at `core.sv:2029`.

The remaining one-byte boundaries are **mode/feature conditional**, not whole
opcodes (already listed PARTIAL in the integer table):

| Mnemonic | Opcode | Conditional HALT |
| --- | --- | --- |
| INT3 / INT n / INTO / IRET | CC / CD / CE / CF | HALT in **user mode** (no IDT); `INT 0x80` user routes to the proxy (`core.sv:1763,1769,1780,1786`) |
| Other IN/OUT outside co-sim | E4–E7, EC–EF | only `out 0xf4` (isa-debug-exit) is allowed outside co-sim; any other IN/OUT HALTs (`core.sv:1818-1842`) |
| AAM base 0 (`#DE`) | D4 00 | architectural `#DE` is deferred (quotient/remainder guarded to 0; corpus never executes it) (`core.sv:2422-2423`) |

---
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
