AL-255/ventium/docs/review-response-plan.md

# REVIEW_Jun5.md response plan — one-page index

Maps EACH finding in `REVIEW_Jun5.md` to its status (**DONE** this change set /
**SPEC'd-deferred**) and the doc or test that addresses it. "DONE" means an
artifact in the tree now closes or machine-checks the finding; "SPEC'd-deferred"
means a design spec exists and the work is tracked but intentionally not landed
(it perturbs calibrated cycle bands and needs new microbenchmarks).

This index is a doc; it touches no `rtl/` and no Makefile.

---

## Fidelity Limits (REVIEW §"Fidelity Limits")
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
