AL-255/ventium/docs/fpga-physical-2886d24c/clb-hierarchy-compact.png

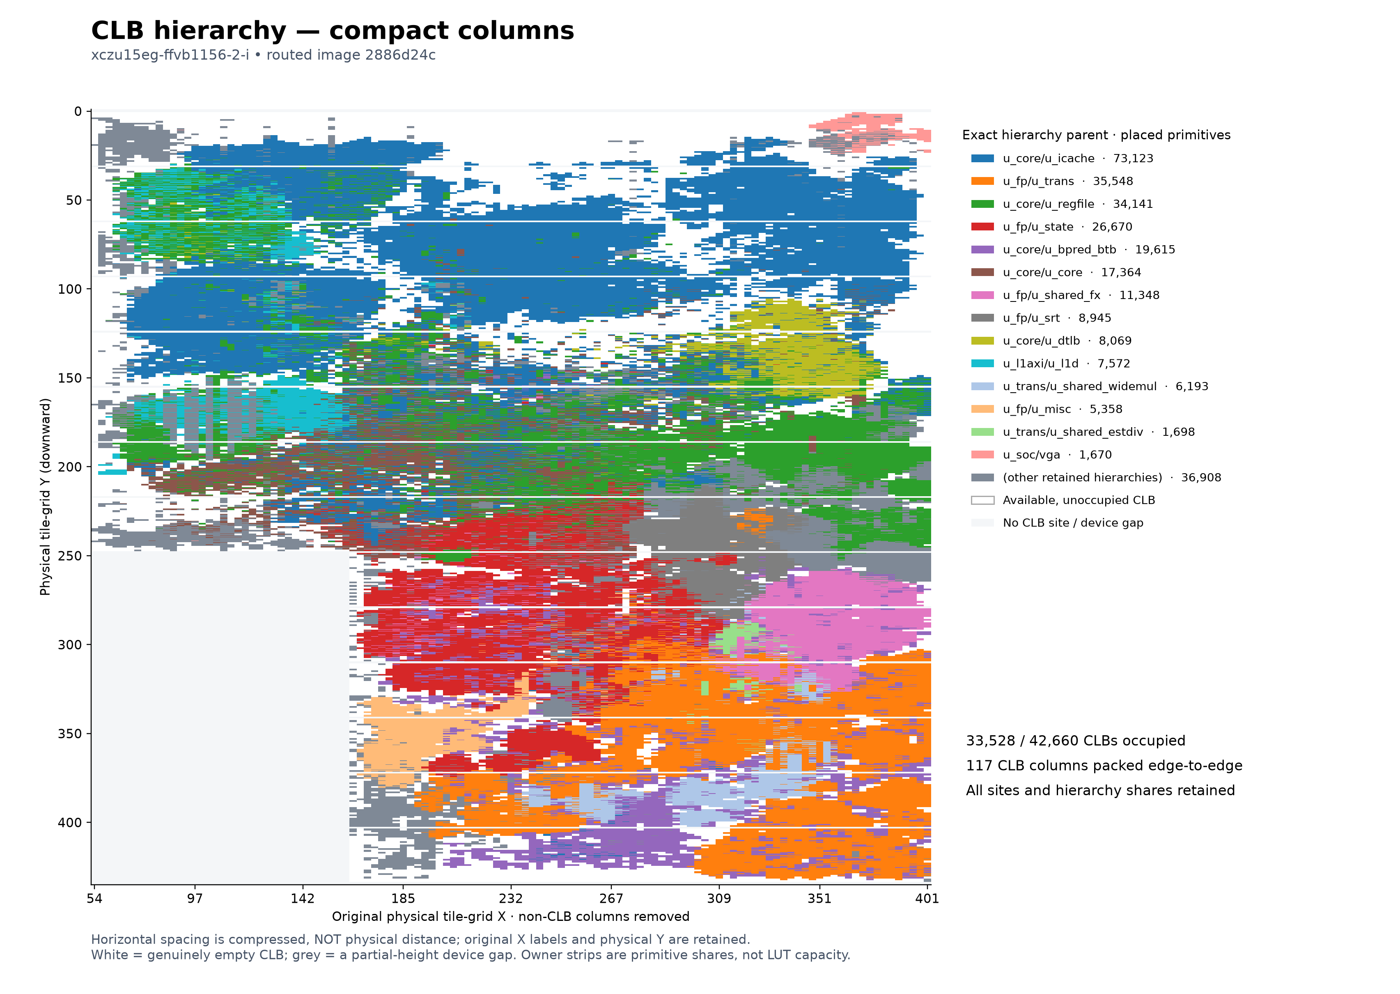
docs/fpga-physical-2886d24c/clb-hierarchy-compact.png
