AL-255/ventium/docs/fpga-physical-2886d24c/clb-lut-density.png

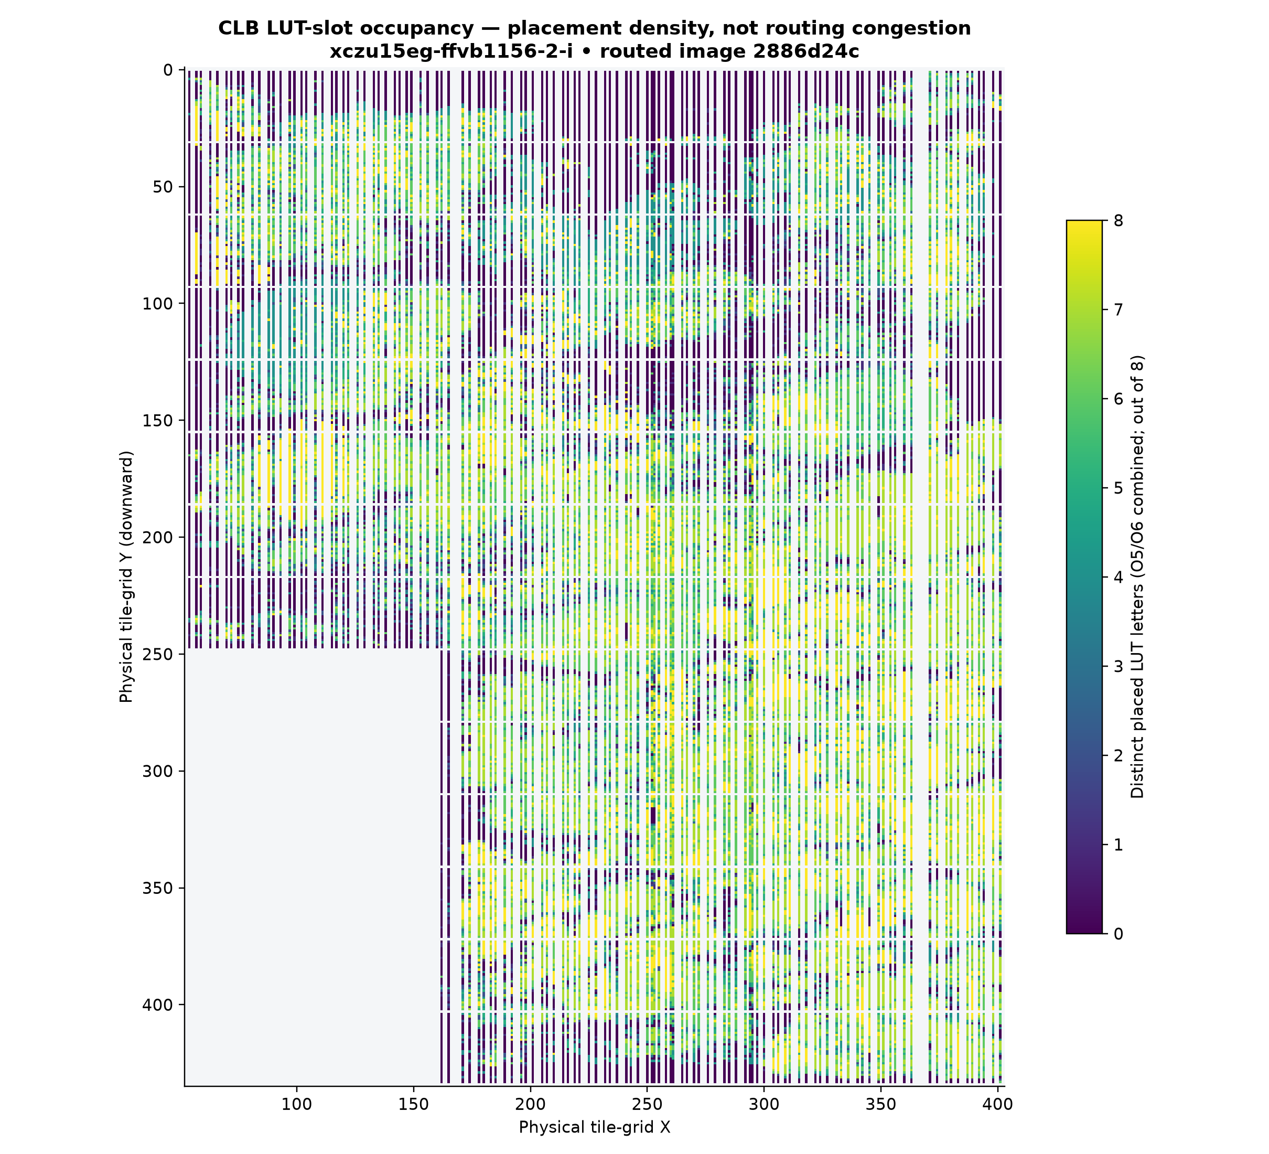
docs/fpga-physical-2886d24c/clb-lut-density.png
