AL-255/ventium/docs/fpga-physical-2886d24c/optimization-focus.png

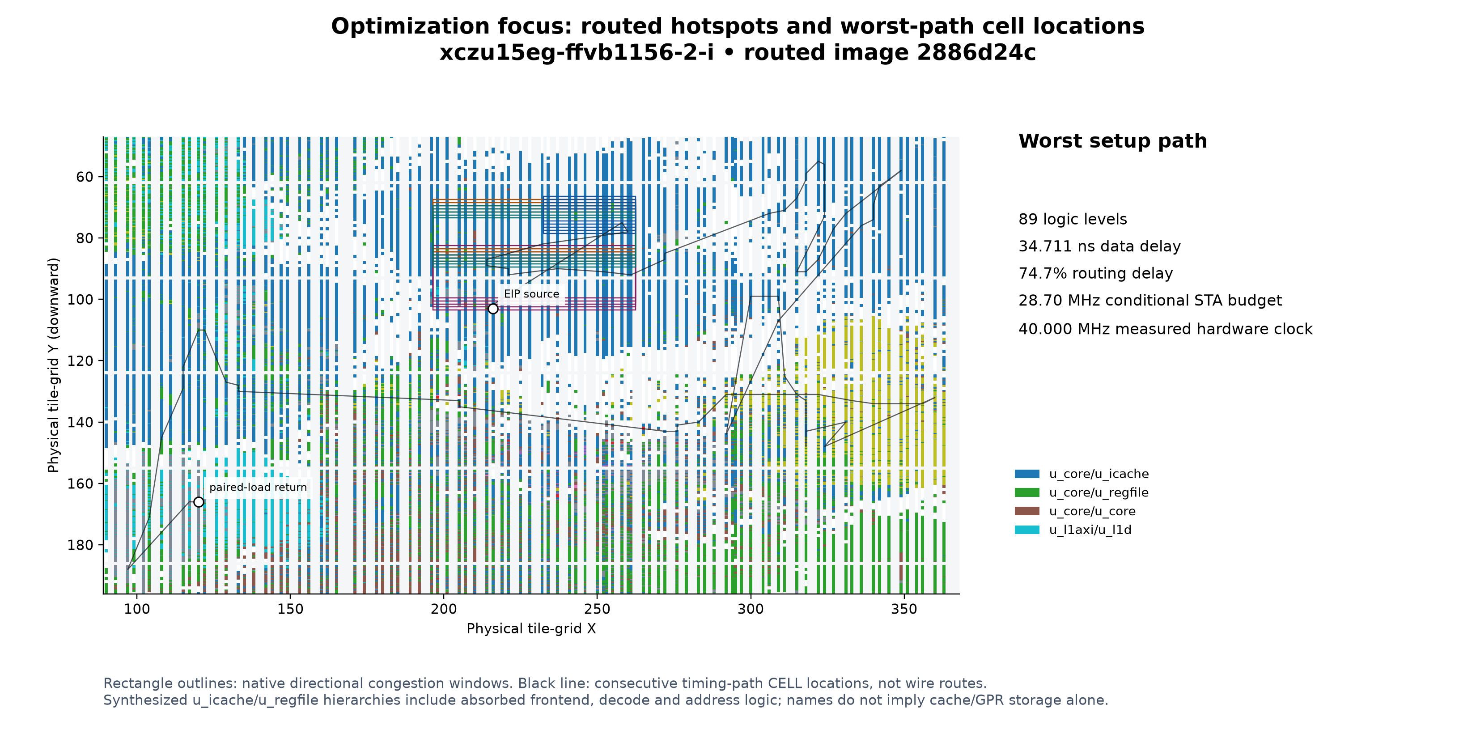
docs/fpga-physical-2886d24c/optimization-focus.png
