AL-255/ventium/docs/fpga-physical-2886d24c/routing-congestion.png

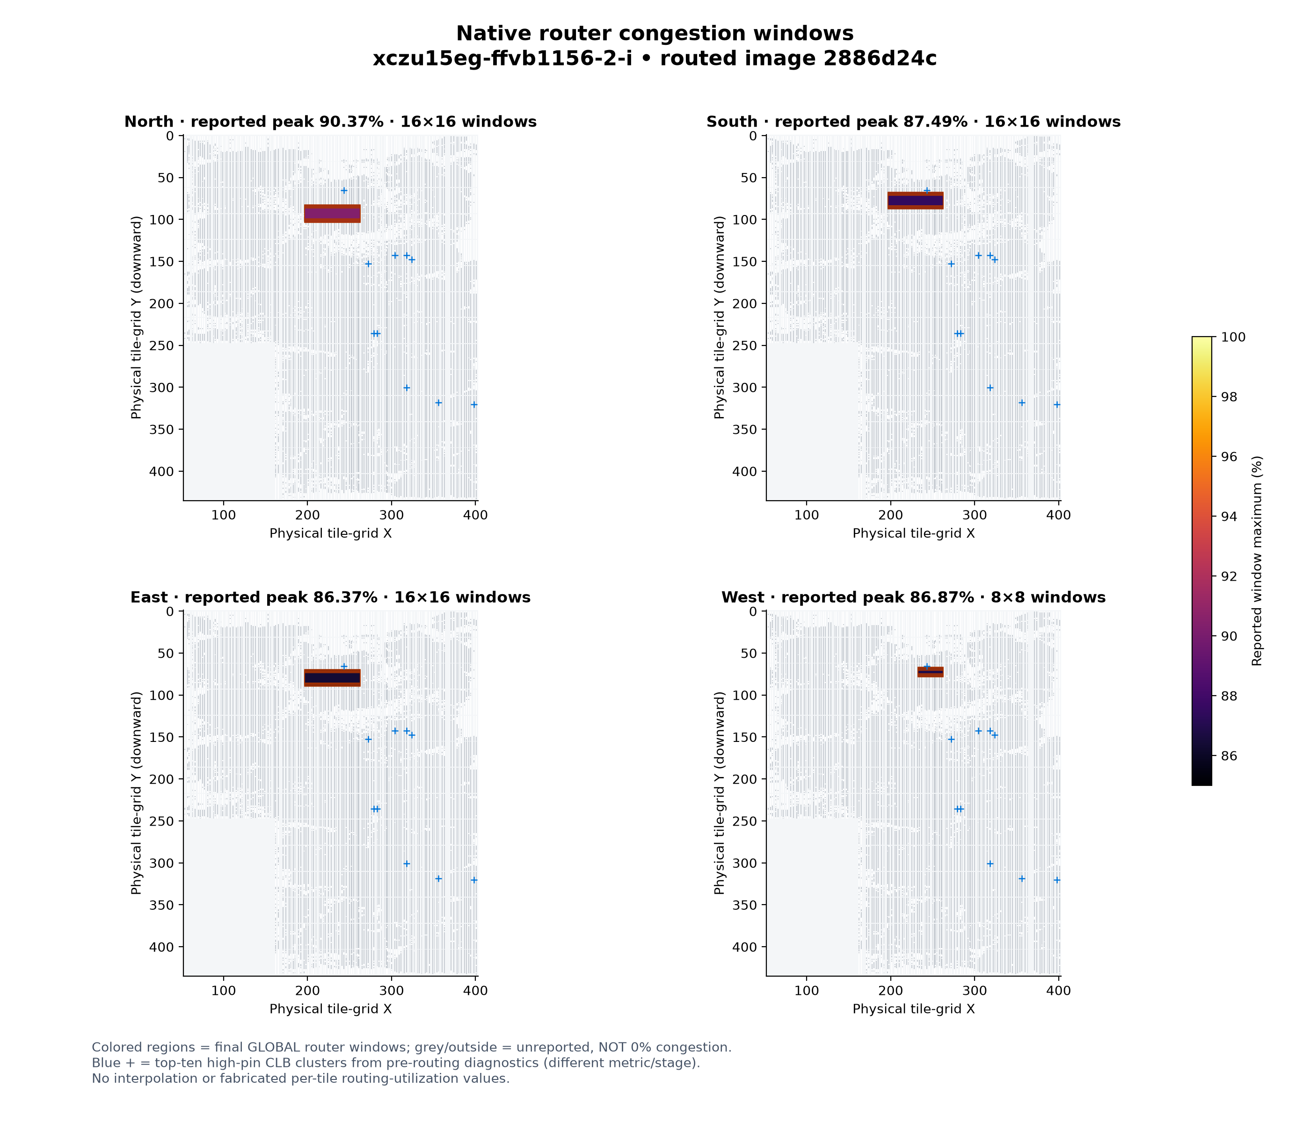
docs/fpga-physical-2886d24c/routing-congestion.png
