AL-255/ventium/rtl/core/intcore.sv

// core/intcore.sv — M2 single-issue, in-order, multi-cycle functional integer
// core (PLAN.md §7, docs/m2-isa-spec.md). Extends the M1 core to user-mode
// integer ISA completeness, diff-clean vs QEMU user-mode.
//
// FSM skeleton (one instruction at a time, multi-cycle):
//   S_RESET  -> latch init_eip/init_esp/reset arch state
//   S_FETCH  -> read a 16-byte window at EIP (4 word reads)
//   S_DECODE -> combinational prefix+length+operand decode
//   S_LOAD   -> read a memory source / RMW dst / [ESI] or [EDI]
//   S_LOAD2  -> CMPS second memory operand ([EDI])
//   S_EXEC   -> compute result + EFLAGS; commit or hand off to a store/micro op
//   S_STORE  -> write a memory destination / push word
//   S_USEQ   -> micro-sequenced ops (PUSHA/POPA/POPF/string REP iterations)
//   S_HALT   -> int $0x80 or out-of-scope opcode: stop retiring
//
// Out-of-scope opcodes raise d_unknown and HALT loudly (no mis-execution).

module intcore
  import ventium_pkg::*;
  import fpu_x87_pkg::*;
#(
    parameter logic [31:0] EFLAGS_RESET = 32'h0000_0202, // bit1 reserved-1 + IF
    parameter logic [15:0] SEG_CS = 16'h0023,
    parameter logic [15:0] SEG_SS = 16'h002b,
    parameter logic [15:0] SEG_DS = 16'h002b,
    parameter logic [15:0] SEG_ES = 16'h002b,
    parameter logic [15:0] SEG_FS = 16'h0000,
    parameter logic [15:0] SEG_GS = 16'h002b
) (
    input  logic        clk,
    input  logic        rst_n,

    input  logic [31:0] init_eip,
    input  logic [31:0] init_esp,

    output logic        mem_req,
    output logic        mem_we,
    output logic [31:0] mem_addr,
    output logic [31:0] mem_wdata,
    output logic [3:0]  mem_wstrb,
    input  logic [31:0] mem_rdata,
    input  logic        mem_ack,

    output logic        retire_valid,
    output logic [31:0] retire_pc,
    output arch_state_t retire_state,

    // x87 post-commit architectural state (M3). Valid in the same cycle as
    // retire_valid. `retire_x87_touched` is 1 iff the retired instruction was an
    // x87 op (so ventium_top calls vtm_retire_x87 only then). st0..st7 are in
    // TOP-relative order (st0 = register at TOP), each canonical floatx80[79:0].
    // fstat already has TOP overlaid in bits[13:11]; ftag follows QEMU's
    // user-mode gdbstub convention (constant 0x0000).
    output logic        retire_x87_touched,
    output logic [15:0] retire_fctrl,
    output logic [15:0] retire_fstat,
    output logic [15:0] retire_ftag,
    output logic [79:0] retire_st0, retire_st1, retire_st2, retire_st3,
    output logic [79:0] retire_st4, retire_st5, retire_st6, retire_st7
);

  // ===========================================================================
  // Architectural state
  // ===========================================================================
  logic [31:0] eip;
  logic [31:0] eflags;
  logic [31:0] gpr [NUM_GPR];   // eax ecx edx ebx esp ebp esi edi

  // ===========================================================================
  // x87 FPU architectural state (M3)
  // ===========================================================================
  // Physical register file (8 x 80-bit) + TOP. st(i) = fpr[(ftop+i)&7]. Push
  // decrements TOP then writes; pop increments TOP (leaving the stale value, so
  // the trace's "empty" st-slots keep their last contents — matches QEMU).
  logic [79:0] fpr [8];
  logic [2:0]  ftop;
  logic [15:0] fctrl;            // control word; reset 0x037f
  // fstat holds the condition codes (C0/C1/C2/C3) + exception flags, with the
  // TOP field (bits[13:11]) kept ZERO internally; it is overlaid from `ftop` on
  // read (mirrors QEMU helper_fnstsw). fstat[15:11] are never written here.
  logic [15:0] fstat;
  // Architectural tag: 1=empty, 0=valid (drives FXAM's empty-detect + the FXAM
  // C1 sign bit). NOT reported in the trace (QEMU's gdbstub abridges ftag to 0).
  logic [7:0]  fptag;           // bit i = tag for fpr[i] (1=empty)
  logic        x87_touched_r;   // retired insn touched the FPU (drives DPI call)

  // ===========================================================================
  // FSM
  // ===========================================================================
  typedef enum logic [3:0] {
    S_RESET, S_FETCH, S_DECODE, S_LOAD, S_LOAD2, S_EXEC, S_STORE, S_USEQ, S_HALT,
    S_FLOAD, S_FEXEC, S_FSTORE
  } state_e;
  state_e state;

  localparam int IWORDS = 4;
  logic [7:0]  ibuf [16];
  logic [2:0]  fetch_word;

  // ALU op encoding (low 3 bits mirror the x86 ALU group order 0..7).
  localparam logic [4:0] ALU_ADD = 5'd0;
  localparam logic [4:0] ALU_OR  = 5'd1;
  localparam logic [4:0] ALU_ADC = 5'd2;
  localparam logic [4:0] ALU_SBB = 5'd3;
  localparam logic [4:0] ALU_AND = 5'd4;
  localparam logic [4:0] ALU_SUB = 5'd5;
  localparam logic [4:0] ALU_XOR = 5'd6;
  localparam logic [4:0] ALU_CMP = 5'd7;
  localparam logic [4:0] ALU_INC = 5'd8;
  localparam logic [4:0] ALU_DEC = 5'd9;
  localparam logic [4:0] ALU_TEST= 5'd10;
  localparam logic [4:0] ALU_MOV = 5'd11;
  localparam logic [4:0] ALU_NEG = 5'd12;
  localparam logic [4:0] ALU_NOT = 5'd13;

  // op classes
  typedef enum logic [4:0] {
    K_ALU, K_SHIFT, K_SHLDRD, K_MULDIV, K_IMUL2, K_EXT, K_SETCC,
    K_BITTEST, K_BITSCAN, K_XCHG, K_BSWAP, K_CONV, K_STKMISC, K_STR, K_CTRL
  } kind_e;

  typedef enum logic [2:0] { SM_PUSHA, SM_POPA, SM_PUSHF, SM_POPF, SM_LAHF, SM_SAHF, SM_LEAVE } smk_e;
  typedef enum logic [2:0] { ST_MOVS, ST_STOS, ST_LODS, ST_SCAS, ST_CMPS } st_e;
  typedef enum logic [3:0] {
    CT_CALLREL, CT_RETN, CT_RETN_IMM, CT_CALLIND, CT_JMPIND,
    CT_LOOP, CT_LOOPE, CT_LOOPNE, CT_JECXZ
  } ctk_e;

  // ===========================================================================
  // Decoder outputs (combinational)
  // ===========================================================================
  logic [3:0]  d_len;
  logic        d_halt;
  logic        d_unknown;
  logic        d_is_branch;
  logic        d_branch_taken;
  logic [31:0] d_rel;
  logic [4:0]  d_alu_op;
  logic        d_writes_reg;
  logic        d_writes_flags;
  logic        d_mem_read;
  logic        d_mem_write;
  logic        d_mem_dst;
  logic [2:0]  d_dst_reg;
  logic [2:0]  d_src_reg;
  logic [31:0] d_imm;
  logic        d_use_imm;
  logic        d_is_push;
  logic        d_is_pop;
  logic        d_is_lea;
  logic        d_is_mov;
  logic        d_is_nop;
  logic [31:0] d_ea;
  logic [2:0]  d_w;
  logic        d_dst_high8;
  logic        d_src_high8;
  kind_e       d_kind;
  logic [2:0]  d_shrot;
  logic        d_shift_cl;
  logic        d_shift_one;
  logic [4:0]  d_shift_imm;
  logic        d_shrd;
  logic [2:0]  d_md;
  logic        d_imul_3op;
  logic [31:0] d_imul_imm;
  logic        d_ext_signed;
  logic [2:0]  d_ext_srcw;
  logic [3:0]  d_cc;
  logic        d_bit_imm;
  logic [2:0]  d_bit_op;
  logic        d_conv_cdq;
  smk_e        d_sm;
  st_e         d_st;
  logic        d_str_loadsi;   // reads [ESI]
  logic        d_str_storedi;  // writes [EDI]
  logic        d_str_scandi;   // reads [EDI] for compare
  ctk_e        d_ct;
  logic [15:0] d_ret_imm;
  logic        d_cld;
  logic        d_std;
  logic        d_clc;          // CLC (F8): CF<-0
  logic        d_stc;          // STC (F9): CF<-1
  logic        d_cmc;          // CMC (F5): CF<-~CF
  logic        d_cnt16;        // 0x67 address-size: LOOP/JCXZ use CX (low 16)

  // ---- x87 decode (M3) ------------------------------------------------------
  // x87 sub-op encoding for the FPU execution path. The decoder classifies each
  // escape (D8..DF + ModR/M) into one of these and supplies the addressing
  // (d_f_mem_read/write + d_f_msize) and operand index (d_f_sti) it needs.
  typedef enum logic [5:0] {
    FX_NONE,
    // loads / pushes
    FX_FLD_M32, FX_FLD_M64, FX_FLD_M80, FX_FLD_STI,
    FX_FILD_M16, FX_FILD_M32, FX_FILD_M64,
    FX_FLDCONST,             // d_f_const selects which ROM constant
    // stores
    FX_FST_M32, FX_FST_M64, FX_FST_M80, FX_FST_STI,    // pop variants via d_f_pop
    FX_FIST_M16, FX_FIST_M32, FX_FIST_M64,
    FX_FNSTCW, FX_FNSTSW_M, FX_FNSTSW_AX, FX_FLDCW,
    // stack management
    FX_FXCH, FX_FFREE, FX_FINCSTP, FX_FDECSTP, FX_FNOP, FX_FNINIT, FX_FNCLEX, FX_FWAIT,
    // sign / abs
    FX_FABS, FX_FCHS,
    // compares / classify
    FX_FCOM_M32, FX_FCOM_M64, FX_FCOM_STI, FX_FUCOM_STI,
    FX_FCOMPP, FX_FUCOMPP, FX_FTST, FX_FXAM,
    FX_FICOM_M16, FX_FICOM_M32,
    // arithmetic (d_f_aluop selects add/sub/subr/mul/div/divr; flavor via fields)
    FX_AR_ST0_STI,           // ST0 op= ST(i)
    FX_AR_STI_ST0,           // ST(i) op= ST0
    FX_AR_M32, FX_AR_M64,    // ST0 op= mem float
    FX_AR_I16, FX_AR_I32,    // ST0 op= mem int (FIADD..)
    FX_FSQRT
  } fxop_e;

  fxop_e       d_fxop;
  logic        d_is_x87;
  logic        d_f_mem_read;     // x87 op reads a memory operand
  logic        d_f_mem_write;    // x87 op writes a memory operand
  logic [2:0]  d_f_msize;        // memory operand bytes: 2/4/8/10 (encoded as 2,4,8,10 won't fit 3b)
  logic [3:0]  d_f_mbytes;       // memory operand size in bytes (2,4,8,10)
  logic        d_f_pop;          // pop the stack after the op (1 pop)
  logic        d_f_pop2;         // pop twice (FCOMPP/FUCOMPP)
  logic [2:0]  d_f_sti;          // st(i) index operand
  logic [2:0]  d_f_aluop;        // 0=add 1=mul 4=sub 5=subr 6=div 7=divr (x87 group)
  logic [2:0]  d_f_const;        // ROM-constant selector for FLDCONST

  // ===========================================================================
  // ModR/M + SIB helpers
  // ===========================================================================
  logic [3:0]  m_idx;
  logic [1:0]  modrm_mod;
  logic [2:0]  modrm_reg;
  logic [2:0]  modrm_rm;
  logic        has_sib;
  logic [1:0]  sib_scale;
  logic [2:0]  sib_index;
  logic [2:0]  sib_base;
  logic [7:0]  mrm, sibb;

  function automatic logic [3:0] mfl(input logic [1:0] mod, input logic [2:0] rm,
                                     input logic sib, input logic [2:0] base);
    logic [3:0] disp;
    begin
      if (mod==2'b01)                          disp=4'd1;
      else if (mod==2'b10)                     disp=4'd4;
      else if (mod==2'b00 && rm==3'b101)       disp=4'd4;
      else if (mod==2'b00 && sib && base==3'b101) disp=4'd4;
      else                                     disp=4'd0;
      return 4'd1 + (sib?4'd1:4'd0) + disp;
    end
  endfunction

  // ===========================================================================
  // Prefix machine
  // ===========================================================================
  logic [3:0] pfx_len;
  logic       pfx_opsize, pfx_addr, pfx_seg, pfx_lock;
  logic [1:0] pfx_rep;          // 0 none, 2 F2, 3 F3
  logic [7:0] op0, op1;
  logic       two_byte;

  function automatic logic is_prefix(input logic [7:0] b);
    is_prefix = (b==8'h66)||(b==8'h67)||(b==8'h2E)||(b==8'h36)||(b==8'h3E)||
                (b==8'h26)||(b==8'h64)||(b==8'h65)||(b==8'hF0)||(b==8'hF2)||(b==8'hF3);
  endfunction

  always_comb begin
    pfx_len=4'd0; pfx_opsize=1'b0; pfx_addr=1'b0; pfx_seg=1'b0; pfx_lock=1'b0; pfx_rep=2'd0;
    for (int i=0;i<4;i++) begin
      if (is_prefix(ibuf[pfx_len])) begin
        unique case (ibuf[pfx_len])
          8'h66: pfx_opsize=1'b1;
          8'h67: pfx_addr=1'b1;
          8'hF3: pfx_rep=2'd3;
          8'hF2: pfx_rep=2'd2;
          8'hF0: pfx_lock=1'b1;
          default: pfx_seg=1'b1;
        endcase
        pfx_len = pfx_len + 4'd1;
      end
    end
    op0=ibuf[pfx_len];
    two_byte=(op0==8'h0F);
    op1=ibuf[pfx_len+4'd1];
  end

  // ===========================================================================
  // Condition codes
  // ===========================================================================
  function automatic logic cond_true(input logic [3:0] tttn, input logic [31:0] fl);
    logic cf,pf,zf,sf,of,res;
    begin
      cf=fl[0]; pf=fl[2]; zf=fl[6]; sf=fl[7]; of=fl[11];
      unique case (tttn[3:1])
        3'b000: res=of; 3'b001: res=cf; 3'b010: res=zf; 3'b011: res=cf|zf;
        3'b100: res=sf; 3'b101: res=pf; 3'b110: res=(sf^of); 3'b111: res=(zf|(sf^of));
        default: res=1'b0;
      endcase
      return tttn[0] ? ~res : res;
    end
  endfunction

  // ===========================================================================
  // Width helpers
  // ===========================================================================
  function automatic logic [31:0] wmask(input logic [31:0] v, input logic [2:0] w);
    if (w==3'd1) return {24'd0, v[7:0]};
    else if (w==3'd2) return {16'd0, v[15:0]};
    else return v;
  endfunction
  function automatic logic sbit(input logic [31:0] v, input logic [2:0] w);
    if (w==3'd1) return v[7]; else if (w==3'd2) return v[15]; else return v[31];
  endfunction
  // second-highest bit (MSB-1) of width w
  function automatic logic sbit2(input logic [31:0] v, input logic [2:0] w);
    if (w==3'd1) return v[6]; else if (w==3'd2) return v[14]; else return v[30];
  endfunction
  function automatic logic parity8(input logic [7:0] v); return ~^v; endfunction

  // ===========================================================================
  // Combinational decoder
  // ===========================================================================
  always_comb begin
    d_len=4'd1; d_halt=1'b0; d_unknown=1'b0; d_is_branch=1'b0; d_branch_taken=1'b0;
    d_rel=32'd0; d_alu_op=ALU_ADD; d_writes_reg=1'b0; d_writes_flags=1'b0;
    d_mem_read=1'b0; d_mem_write=1'b0; d_mem_dst=1'b0; d_dst_reg=3'd0; d_src_reg=3'd0;
    d_imm=32'd0; d_use_imm=1'b0; d_is_push=1'b0; d_is_pop=1'b0; d_is_lea=1'b0;
    d_is_mov=1'b0; d_is_nop=1'b0; d_ea=32'd0; d_w=3'd4; d_dst_high8=1'b0; d_src_high8=1'b0;
    d_kind=K_ALU; d_shrot=3'd0; d_shift_cl=1'b0; d_shift_one=1'b0; d_shift_imm=5'd0;
    d_shrd=1'b0; d_md=3'd0; d_imul_3op=1'b0; d_imul_imm=32'd0; d_ext_signed=1'b0;
    d_ext_srcw=3'd1; d_cc=4'd0; d_bit_imm=1'b0; d_bit_op=3'd4; d_conv_cdq=1'b0;
    d_sm=SM_PUSHA; d_st=ST_MOVS; d_str_loadsi=1'b0; d_str_storedi=1'b0; d_str_scandi=1'b0;
    d_ct=CT_CALLREL; d_ret_imm=16'd0; d_cld=1'b0; d_std=1'b0;
    d_clc=1'b0; d_stc=1'b0; d_cmc=1'b0; d_cnt16=pfx_addr;
    d_fxop=FX_NONE; d_is_x87=1'b0; d_f_mem_read=1'b0; d_f_mem_write=1'b0;
    d_f_msize=3'd0; d_f_mbytes=4'd0; d_f_pop=1'b0; d_f_pop2=1'b0; d_f_sti=3'd0;
    d_f_aluop=3'd0; d_f_const=3'd0;

    m_idx     = pfx_len + (two_byte ? 4'd2 : 4'd1);
    mrm       = ibuf[m_idx];
    sibb      = ibuf[m_idx+4'd1];
    modrm_mod = mrm[7:6];
    modrm_reg = mrm[5:3];
    modrm_rm  = mrm[2:0];
    has_sib   = (modrm_mod!=2'b11) && (modrm_rm==3'b100);
    sib_scale = sibb[7:6];
    sib_index = sibb[5:3];
    sib_base  = sibb[2:0];

    begin
      logic [31:0] base_val, index_val, disp_val;
      logic [3:0]  disp_idx;
      logic        no_base, no_index;
      no_base=1'b0; no_index=1'b0; base_val=32'd0; index_val=32'd0; disp_val=32'd0;
      disp_idx=m_idx+4'd1;
      if (has_sib) begin
        disp_idx=m_idx+4'd2;
        if (sib_base==3'b101 && modrm_mod==2'b00) no_base=1'b1;
        else base_val=gpr[sib_base];
        if (sib_index==3'b100) no_index=1'b1;
        else index_val=gpr[sib_index]<<sib_scale;
      end else begin
        if (modrm_mod==2'b00 && modrm_rm==3'b101) no_base=1'b1;
        else base_val=gpr[modrm_rm];
      end
      if (modrm_mod==2'b01) disp_val={{24{ibuf[disp_idx][7]}}, ibuf[disp_idx]};
      else if (modrm_mod==2'b10 ||
               (modrm_mod==2'b00 && !has_sib && modrm_rm==3'b101) ||
               (modrm_mod==2'b00 && has_sib && sib_base==3'b101))
        disp_val={ibuf[disp_idx+3],ibuf[disp_idx+2],ibuf[disp_idx+1],ibuf[disp_idx]};
      d_ea=(no_base?32'd0:base_val)+(no_index?32'd0:index_val)+disp_val;
    end

    d_w = pfx_opsize ? 3'd2 : 3'd4;
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
