AL-255/ventium/rtl/core/decode.sv

`default_nettype wire  // Vivado project-flow: reset nettype (files compile as one unit; prevents `none` leak)
// Copyright 2026 Anhang Li (AL-255, thelithcore@gmail.com)
// SPDX-License-Identifier: Apache-2.0 WITH SHL-2.1

// core/decode.sv — M4/M5 fast-path variable-length x86 decoder.
//
// Extracted VERBATIM from intcore.sv (R1 modularization phase 3,
// docs/rtl-refactor-plan.md). This is the fast-path decoder the dual-issue
// pipeline uses: it recognises the simple/pairable instruction subset directly
// (MOV/ALU/INC-DEC/LEA/load/shift/Jcc + a cycle-mode x87 reg-form whitelist) and
// emits the decoded-uop struct (fpd_t) consumed by the U/V issue logic. Anything
// it does not recognise leaves d.simple=0 and the core falls back to the slow
// multi-cycle FSM. Pure combinational: bytes (+ EFLAGS, + cycle_mode) -> fpd_t.
//
// IF (docs/rtl-refactor-plan.md §6 decode.sv): instruction bytes in -> decoded
// uop struct + length out. b0..b6 are the fixed fast-path decode bytes; flags_in is
// the current EFLAGS (for the architectural Jcc taken decision); cycle_mode
// gates the x87 reg-form whitelist exactly as the in-line version did (func runs
// keep FP on the slow FSM). The fpd_t carries .len (decoded length).
//
// fp_decode / _onehot below are moved BIT-FOR-BIT from intcore.sv; the only
// change is that they now live in this module's scope (cycle_mode is this
// module's input port, read by the function exactly as it read intcore's port).

module decode
  import ventium_pkg::*;
  import ventium_alu_pkg::*;
  import ventium_decode_pkg::*;
(
    input  logic [7:0]  ib0,
    input  logic [7:0]  ib1,
    input  logic [7:0]  ib2,
    input  logic [7:0]  ib3,
    input  logic [7:0]  ib4,
    input  logic [7:0]  ib5,
    input  logic [7:0]  ib6,
    input  logic [31:0] iflags,
    // task #56 step C: the 16-bit-default flag (core.sv:770, def16 = sys_mode && !cs_d).
    // decode.sv was written for 32-bit flat code and had NO operand-size concept at all,
    // which is precisely what core_fastpath.svh:288's sys_mode bail-out exists to avoid.
    input  logic        def16,
    input  logic        cycle_mode,
    output fpd_t        uop
);

  // ---- fast-path decoder (moved verbatim from intcore.sv) -------------------
  function automatic fpd_t fp_decode(input logic [7:0] b0, input logic [7:0] b1,
                                     input logic [7:0] b2, input logic [7:0] b3,
                                     input logic [7:0] b4, input logic [7:0] b5,
                                     input logic [7:0] b6,
                                     input logic [31:0] flags_in);
    fpd_t d;
    logic [1:0] mod; logic [2:0] reg_f, rm;
    logic checked_add_opcode;
    logic fp_mem_load, fp_mem_integer, fp_mem_wide;
    begin
      d = '{default:'0};
      d.alu_op = ALU_ADD; d.len = 4'd1;
      // task #56 step F: for UNPREFIXED instructions eff_opsize == def16, so w16 follows it
      // directly. decode.sv still does not recognise prefixes (an unrecognised prefix byte lands
      // as b0 and yields d.simple=0), so every instruction that reaches an arm below is
      // unprefixed by construction -- which makes this exact, not an approximation.
      d.w16 = def16;
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
