AL-255/ventium/rtl/fpu/fpu_x87_pkg.sv

// Copyright 2026 Anhang Li (AL-255, thelithcore@gmail.com)
// SPDX-License-Identifier: Apache-2.0 WITH SHL-2.1

// fpu/fpu_x87_pkg.sv — x87 floatx80 datapath helpers (M3).
//
// A self-contained, bit-exact-vs-QEMU floatx80 engine for the x87 FPU, covering
// NORMAL finite values, signed zero, infinities, NaNs, AND (as of the denormal
// work) DENORMAL operands + gradual UNDERFLOW / OVERFLOW results, at the default
// control word 0x037f (RNE, PC=11) with all four rounding modes honored.
//
// Reference: QEMU softfloat floatx80 (fpu/softfloat.c) + the i386 fpu_helper.c
// semantics (compare ccval table, FXAM classify, FCHS/FABS, conversions). The
// algorithms here were validated bit-exact against QEMU goldens for every
// add/sub/mul/div/sqrt and float32/64<->floatx80, int<->floatx80 case in the
// tx_* corpus (incl. tx_fp_special, tx_fp_denorm) before being transcribed to RTL.
//
// floatx80 canonical layout (matches gen_trace.py / the trace hex strings):
//   bit79     = sign
//   bits78:64 = biased exponent (bias 16383)
//   bits63:0  = mantissa (explicit integer bit at 63 for normals; 0 for denormals)
// A packed 80-bit logic vector [79:0] carries this directly.
//
// SPECIAL-VALUE SUPPORT:
//   * Inf / NaN arithmetic + propagation: ventium_x87_pkg::f_special / f_eval.
//   * DENORMAL operands: fx_uexp_eff gives the IEEE-emin (1-bias) bit63 weight, so
//     fx_add/fx_mul/fx_div/fx_sqrt handle denormals via the normal datapath; the
//     SRT engine (which assumes a normalized 1.f) is bypassed for them (fx_div ->
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
