AL-255/ventium/(commit log)

2026-06-03 Bootstrap Ventium P5 replica: M0 skeleton + M1 integer core
    Initial commit of Ventium — a high-fidelity SystemVerilog reconstruction of the
    Intel Pentium (P5/P54C) microarchitecture, verified differentially against QEMU
    with Verilator. M0 and M1 both predate the first commit, so they land together;
    from M2 onward each milestone is its own commit+push.
    M0 (infrastructure): trace-format + RTL<->TB DPI contracts + shared tracefmt.py;
    Producer A (QEMU gdbstub golden arch-state trace), Producer B (TCG cycle-trace
    plugin), Producer C (Verilator TB + sparse memory BFM); comparator; smoke corpus
    + ELF->flat loader; RTL skeleton (ventium_top + PLAN §6 block stubs). 'make m0-smoke'.
    M1 (single-is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
2026-06-03 M2: user-mode integer ISA completeness (func-equiv vs QEMU)
    Extend the single-issue integer core (rtl/core/intcore.sv, 979->1690 lines) to
    the complete user-visible integer ISA per docs/m2-isa-spec.md. All 28 corpus
    programs are func-diff-clean vs QEMU user-mode (compare.py --mode func exit 0).
    Gate: 'make m2'. 'make m1' and 'make m0-smoke' still green; RTL lint-clean.
    Added: prefix machine (66/67/seg/LOCK/F2/F3, stacked) + 8/16/32-bit operand sizes
    with correct partial-register semantics; shifts/rotates (count&0x1f, count==0 no-op)
    + SHLD/SHRD; MUL/IMUL/DIV/IDIV + 2/3-op IMUL; MOVZX/MOVSX; NEG/NOT/INC/DEC r-m;
    XCHG; SETcc; BT/BTS/BTR/BTC; BSF/BSR; CDQ/CWDE/CBW; BSWAP; PUSH/POP/PUSHA/POPA/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
2026-06-03 M3: x87 FPU functional core (bit-exact vs QEMU)
    Add the x87 FPU to the single-issue core: 8x80-bit register stack with TOP,
    status/control/tag words, and a self-contained floatx80 datapath
    (rtl/fpu/fpu_x87_pkg.sv) — add/sub/mul/div/sqrt + float32/64<->80 and int<->80
    conversions, rounding-control honored. Data movement + normal-operand arithmetic
    are bit-exact vs QEMU's softfloat floatx80. All 42 corpus programs (28 integer +
    14 x87) are func-diff-clean vs QEMU; gate 'make m3' exit 0. make m2/m1/m0-smoke
    still green; lint clean.
    Trace infra: the vtm_retire_x87 DPI hook (ventium_pkg.sv + dpi_retire.cpp/
    tb_main.cpp --x87) emits the post-commit x87 state (st0..st7 canonical floatx80,
    fctrl/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
2026-06-03 M4: dual-issue U/V pipeline + branch prediction (first cycle milestone)
    Reorganize the integer core into a real in-order 5-stage (PF/D1/D2/EX/WB) dual-issue
    U/V pipeline whose EMERGENT cycle behavior matches the p5model oracle on the canonical
    integer microbenchmarks, while the M1/M2/M3 functional gates stay green (hard safety
    rule). The M1-M3 execute/flag/FPU datapath is reused unchanged; only the control is
    pipelined. Fast path: simple/pairable insns issue up to 2/clk via a combinational
    pairing checker (classes per AP-500 / docs/ap500-pairing-table.md: UV, PU=U-only,
    V-only), full bypass, 1-cycle AGI interlock, 64x4 BTB + 2-bit predictor (mispredict
    3/4). Complex/microcoded insns serializ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
2026-06-03 M5B: standalone pin-level 64-bit P5 bus interface unit (SVA-verified)
    Built in parallel with M5, fully isolated under verif/bus/ (self-contained biu_p5
    module, no ventium_pkg import, own standalone Verilator harness — never touches the
    rtl/ tree M5 is editing). The P5 external bus FSM: single read/write, 4-beat burst
    line fill (Table 6-12 order), locked RMW (SCYC on split only), NA#-pipelined (T12/T2P,
    2 outstanding), inquire/snoop (AHOLD+EADS#/INV -> HIT#/HITM#), hit-modified writeback,
    BOFF# backoff/restart, HOLD/HLDA. Verified by 19 mutation-validated SVA protocol
    invariants + a directed self-consistency testbench: 76/76 checks PASS, lint clean
    (verif/bus/run.sh exit 0).
    Adversarial re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
2026-06-04 verif: add parallel golden-trace generator (gate speedup infra)
    verif/lib/gen_goldens.sh fans the gate's dominant cost — QEMU gdbstub golden
    regeneration — across cores (xargs -P, unique gdbstub port per job, p5trace for
    cycle goldens), replacing the sequential per-program loop in run-mN.sh. On this
    32-core box that turns a ~3h gate (sequential + redundant make m1/m2/m3) into
    minutes. Tested: 4 programs (3 func + 1 cycle) generated in parallel in ~10s,
    all valid (smoke 21 / t_branch 42 / t_loop 77 / mb_depadd 3252 records).
    To be wired into the M6 gate from the start and retrofitted into run-m1..m5 in the
    R1 refactor (together with: drop the redundant 3x func regression — m3 is the
    su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
2026-06-04 M5: L1 cache-miss timing + x87/FP cycle accuracy (cycle gate tightened)
    Extend the M4 dual-issue cycle model with the two pieces the p5model oracle can
    differentially verify: (1) L1 I$/D$ miss-cycle timing (8KB/2-way/32B/128-set/LRU,
    imiss=dmiss=8, misalign +3 — same geometry/penalty as the oracle) and (2) x87/FP
    latency+throughput+occupancy (replacing M4's FP serialize-stall with a result-ready
    scoreboard). Both EMERGENT from real RTL state machines, not formulas copied from
    p5model. Pin-level 64-bit bus stays deferred to M5B (no oracle).
    Verified independently after killing the workflow (its close-out had converged —
    logged M5 GATE: PASS — but then thrashed for hours retrying the sl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
2026-06-04 R1a: fast parallel+cached differential gate (make verify)
    verif/verify.sh = the full m1-m5 func+cycle verification, parallelized (gen_goldens.sh
    across 30 workers), golden-CACHED (key = sha1 of the test .s + mode/x87/max_insn; a program's
    golden depends only on its source, not the RTL), and de-duplicated (no redundant 3x make
    m1/m2/m3 — m3 is the superset). Cold run ~17 min (one-time parallel golden gen); WARM /
    refactor-time run (goldens cached, RTL re-traced + re-compared in parallel) ~seconds.
    Adversarially validated as a refactor safety net: verdict-EQUIVALENT to the slow gate
    (every program func-diffed incl. x87; all 5 M4 + 4 M5 cycle bands at the same thresholds;
    no check weakened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
2026-06-04 R1b: modularize intcore.sv into packages + decode/issue_uv modules (behavior-preserving)
    Gate-protected refactor (make verify GREEN after every extraction; goldens unchanged so the
    fast gate is fully authoritative — func+cycle bit-exact vs the pre-refactor monolith). Carved the
    3648-line rtl/core/intcore.sv into: ventium_alu_pkg.sv (ALU/flags/shift/width pure functions),
    ventium_decode_pkg.sv (op/uop/micro/x87 enums + fpd_t struct + mfl/is_prefix/cond_true), decode.sv
    (variable-length decoder, instantiated x2), issue_uv.sv (AP-500 U/V pairing checker), and the
    spine intcore.sv -> core.sv (3146 lines: wiring + pipeline FSM). Added rtl/ventium.f filelist
    (packages before modules); verif/tb b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
2026-06-04 M6: reproduce 4 documented P5 errata behind a stepping flag (default-off clean)
    Layer-5 stretch. Errata are gated by errata_en (default 0 = clean core); with errata OFF
    make verify stays fully GREEN (56/56 func + all M4/M5 cycle bands, RTL bit-identical to pre-M6).
    With a buggy-P54C stepping ON, make m6 self-checks (11/11) assert the documented defects. There is
    NO differential oracle (QEMU computes correctly) — each erratum is verified against the spec-update
    DOCUMENTED behavior, and every self-check is mutation-proven non-vacuous.
    Reproduced: (23) FDIV/SRT flaw — canonical 4195835/3145727 -> documented flawed 1.3337390689
    (floatx80 0x3fffaab7f6392a768800), OFF -> correct (QEMU-exact);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
2026-06-04 docs: M2S system-mode scoping plan (de-risk survey; not started)
    Bounded survey of the one substantial remaining REF.md §9 piece — system mode
    (protected-mode segmentation, paging/TLB/MMU, interrupts/exceptions, TSS, SMM,
    debug regs). Findings: the differential oracle is FEASIBLE (build qemu-system-i386
    from the present source via --target-list=i386-softmmu; system-state golden trace
    through the gdbstub — the i386-32bit.xml target already advertises CRx/seg-bases and
    gen_trace's tail-anchor layout handles them; bare-metal harness via -device
    isa-debug-exit). But the RTL effort is LARGE — comparable to M1–M5 combined, since
    the core is currently user-mode/flat with no system layer. S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
2026-06-04 M2S.0: system-mode differential oracle + bare-metal harness (no RTL)
    Bounded de-risk step before the M2S RTL stages — proves the system-mode differential loop.
    Built qemu-system-i386 (out-of-tree build-sys/, --target-list=i386-softmmu; the user-mode qemu-i386
    all M0-M6 gates use is UNTOUCHED; build-qemu-system.sh makes it reproducible). gen_trace.py gains a
    --system mode: single-steps qemu-system-i386 -S -gdb, capturing per-instruction system state
    (cr0/cr2/cr3/cr4 + selectors + fault vector) via the existing RSP client. trace-format.md +
    tracefmt.py gain a sys:true header flag + the CRx/segment-hidden fields. A bare-metal pmode test
    (verif/sys/tests/pmode: GDT + real->protected far-jump +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
2026-06-04 M2S.1: real-mode cold boot + real->protected + protected-mode segmentation (dual boot_mode)
    First system-mode RTL stage. Adds a dual boot_mode: boot_mode=user (default) keeps the exact
    flat linux-user entry so make verify (M0-M6) stays bit-identical GREEN (56/56); boot_mode=system
    cold-resets at CS:EIP=F000:FFF0 real mode (cr0=0x60000010, EDX=0x00000663, eflags=0x2) matching
    qemu-system-i386. Implements 16-bit real mode (linear=(seg<<4)+offset), LGDT/LIDT, MOV CR0, the
    66 ljmp ptr16:32 real->PM transition (two single-step-atomic retires), and protected-mode
    segmentation: GDT descriptor loads, hidden base/limit/attr, PM linear=base+offset, descriptor
    present/type/DPL + limit + CPL=CS.RPL prot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
2026-06-04 M2S.3: IDT-delivered interrupts/exceptions + IRET (fault decisions now vector)
    Turns the M2S.1 segment-fault (#GP/#NP/#SS) and M2S.2 #PF (+CR2/errcode) DECISIONS, plus software
    INT n/INT3/INTO and #UD, into real IDT delivery: read the IDT gate (idt_base+v*8) + the gate CS
    descriptor, push the exception frame (EFLAGS/CS/EIP[/errcode]) on SS:ESP, clear IF/TF/NT/RF/VM per
    gate type (IA-32 6.12.1), load CS:EIP -> handler; IRET pops EIP/CS/EFLAGS + reloads CS. FAULT pushes
    faulting EIP (restartable, e.g. #PF retry after the handler maps the page); TRAP (INT/INT3/INTO)
    pushes next EIP. Error code only for #DF/#TS/#NP/#SS/#GP/#PF/#AC. All gated behind sys_mode (user
    int 0x80 still halts).
    Verified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
2026-06-04 M2S.4: TSS + cross-privilege delivery + inter-privilege IRET
    Adds the privilege machinery on top of M2S.3's same-priv IDT delivery: TR/TSS (LTR/STR); cross-
    privilege interrupt/fault delivery loads SS:ESP from TSS.ssN:espN (N=target DPL) and pushes the
    5-word inter-priv frame (old SS, old ESP, EFLAGS, CS, EIP[,errcode]) on the new stack; gate
    Present/DPL + target-CS present/type/DPL protection checks (deferred from M2S.3) now live with
    correct #NP/#GP error codes; inter-priv IRET pops EIP/CS/EFLAGS + (returning to higher CPL) ESP/SS,
    nulling data segs not accessible at the new CPL. All gated behind sys_mode.
    Verified (real RTL --system diff vs qemu-system-i386): pcpl 304 records EQUIVALENT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
2026-06-04 M2S.5: SMM / RSM (structural — differential golden honestly infeasible)
    Implements SMM: SMI# (recognized at the instruction boundary, qemu APIC_DM_SMI-style) saves the
    CPU state to the SMRAM P5 save-map @ SMBASE+0xFE00 (offsets cross-checked vs Dev-Manual Table 20-1),
    enters SMM (CR0 PE/PG/EM/TS cleared, CS sel=SMBASE>>4 base=SMBASE 4GiB, EIP=0x8000, CPL0, 16-bit);
    RSM (0F AA) restores the whole map in one clock honoring a writeable SMBASE/resume-EIP. SMM_REV_ID
    0x00020000 (P5-correct per Dev Manual Vol.3 + qemu). Gated behind sys_mode (user 0F AA still #UD).
    PARTIAL-ORACLE, verification_mode=STRUCTURAL (honest): the per-instruction differential golden is
    INFEASIBLE — qemu's gdbstub sin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
2026-06-05 M2S.6: debug registers (DR0-DR7) + #DB delivery (last system-mode stage)
    DR0-DR7 register file + MOV r32,DRn (0F 21) / MOV DRn,r32 (0F 23) +
    #DB (vector 1) delivery through the M2S.3 IDT path, all gated behind
    sys_mode so boot_mode=user is byte-identical. PARTIAL-oracle but mostly
    DIFFERENTIAL: #DB is a SYNCHRONOUS exception (raise_exception(EXCP01_DB),
    not interrupt_request), so SSTEP_NOIRQ does NOT mask it -- qemu's gdbstub
    single-step delivers it through the guest IDT, making it diffable (unlike
    SMI in psmm).
    New corpus pdebug (real->protected, NO paging, #DB TRAP gate at vec 1):
    MOV DRn<->GPR round-trips (DR values observed THROUGH GPRs -- the M2S.1
    hidden-base trick, since DR is HMP-on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
2026-06-05 docs: Sphinx instruction catalog + GitHub Pages deploy (Actions)
    A Sphinx reference doc (docs/sphinx/) whose first page is the full Ventium
    instruction catalog: 176 instructions across 9 categories (integer ALU,
    data-mov, stack, shift/bit, mul/div/BCD, control-flow, string, system, x87),
    each with its encoding, U/V pairing class (UV/PU/PV/NP) + the datapath WHY,
    a description, how it drives the 5-stage dual-issue datapath (fast path vs
    slow microsequenced FSM, AGU/ALU/shifter/FPU usage, AGI/forwarding), and an
    honest implementation status. Grounded in the actual RTL (decode.sv,
    ventium_decode_pkg, ventium_alu_pkg, issue_uv.sv = the AP-500 pairing checker)
    + the m4 pipeline spec, not generic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
2026-06-05 docs: R2 leaf-extraction record + M7 macro-workload lock-step plan
    PROGRESS_Jun04.md (dated progress record, per request): the roadmap-complete
    snapshot, the R2 outcome (4 single-write-port leaves extracted bit-exact:
    dcache_timing/bpred_btb/tlb x2/icache; regfile + fpu-state proven spine-bound
    and left inline — honest), and the opening of M7. PROGRESS.md R2 row updated
    to point at the extraction.
    docs/m7-lockstep-spec.md: the M7 macro-workload lock-step architecture
    (Quake + Win95) -- input-replay lock-step: QEMU is the golden + environment,
    the RTL is the checked CPU, the trace carries arch state + the environment
    inputs each instruction consumed (syscall effects for Quake; device-read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
2026-06-05 M7.0: lock-step oracle de-risk + TCP_NODELAY enabler (~300-600x faster gdbstub)
    De-risked the input-replay lock-step oracle for both macro-workloads (full
    findings in PROGRESS_Jun04.md):
    - Quake: GO. int 0x80 runs in QEMU's host cpu_loop, so one RSP single-step
    over a syscall site applies the whole kernel effect -- post-step g-packet
    carries eax=ret + every kernel memory write. Capturable over pure RSP (no
    qemu hook): 38 syscalls proven in -strace order, all 3 write classes
    (zero-fill mmap2 / struct-fill clock_gettime64 / read-buffer readv->PACK).
    Deterministic via -seed + static no-PIE EXEC.
    - Win95: PARTIAL-GO. Device-read values + interrupt vectors/boundaries
    capturable over t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
2026-06-05 M7.1: Quake user-mode lock-step — bit-exact over a 30k-insn prefix
    Input-replay lock-step (docs/m7-lockstep-spec.md): qemu-i386 linux-user is the
    golden + environment, the Ventium RTL is the checked CPU, the int-0x80 proxy
    replays the kernel syscall effects (eax + kernel memory writes + the %gs TLS
    base) so the RTL never executes the kernel, and compare.py grades ONLY the CPU
    architectural delta. A divergence = a real CPU bug.
    Producer (gen_trace.py --syscall-proxy + tracefmt.py sys_call field): single-
    steps tyr-quake-p5 under -seed 1234, detects cd80 at EIP (catches the musl/vDSO
    __kernel_vsyscall stub), captures nr+args pre-step, steps (QEMU runs the whole
    kernel in its host cpu_loop),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
2026-06-05 M7.1 longest-run: Quake bit-exact to 1.1M insns + streaming comparator
    verif/diff/compare_stream.py: an O(1)-memory streaming functional comparator
    for large lock-step traces (compare.py loads both fully -> a multi-M-record
    trace exceeds RAM). Reuses compare.py's exact grading (tracefmt.func_compare_keys
    + _eflags_equal with EFLAGS_DEFAULT_MASK + per-insn undefined-flag masking);
    24 MB RSS for 9.6M records. Sanity: agrees with compare.py on the 1M traces
    (EQUIVALENT) and flags a corrupted record DIVERGENT.
    Ran the RTL lock-step against a ~9.6M-record background golden. Result:
    1,106,162 instructions EQUIVALENT (the RTL matches QEMU bit-for-bit over 1.1M
    instructions of real Quake code), the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
2026-06-05 M7.3a: Win95 record/replay producer — a deterministic 300k boot-prefix golden
    The producer half of the Win95 system co-sim (docs/m7-lockstep-spec.md M7.3).
    QEMU is the golden + environment; the trace carries arch state + the
    environment inputs the RTL can't compute (device reads, DMA writes, interrupts).
    Record artifact (verif/m7/win95/record.sh + replay-verify.sh): rr=record over
    a COW OVERLAY of the read-only win95.qcow2 (base untouched), -rtc base=utc,
    -net none, bounded -> replay.bin (deterministic event log). rr=replay is
    bit-reproducible: two replays byte-identical (23 IRQ0 / 126,573 device reads /
    40,186 writes, per-class identical). Landmines fixed: -boot order=c is
    non-replayable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
2026-06-05 M7.3b: Win95 co-sim consumer — boots bit-exact on the RTL to 213,859 insns
    The consumer half of the Win95 system co-sim (docs/m7-lockstep-spec.md M7.3).
    The RTL is the checked CPU; qemu's recorded environment (device-read values)
    is replayed via a new co-sim bus; compare_stream grades ONLY CPU arch state.
    RTL (all gated on the new cosim_en / 32-bit-inert, so every prior gate is
    byte-identical):
    - IN/OUT decode (E4-E7, EC-EF: imm8 + DX, b/w/d) as a new S_IO bus-handshake
    state -- IN takes its value from the co-sim io_* bus (the recorded dev_in),
    OUT drives io_wdata (the existing out 0xf4 isa-debug-exit preserved).
    - CPUID (0F A2, deterministic -cpu pentium leaf table) + INS/rep insb (6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
2026-06-05 M2S.4b: full hardware task switch (far JMP to TSS) — closes the M2S.4 deferral
    Implements the IA-32 SDM Vol.3 §7.3 hardware task switch, gated sys_mode. On a
    far JMP to a 32-bit available/busy TSS descriptor (type 9/B), the S_LJMP
    system-descriptor halt now dispatches a 4-state micro-sequence:
    - S_TSW_SAVE: write the OUTGOING task state into the current TSS (tr_base):
    EIP@0x20 (next_eip), EFLAGS@0x24, 8 GPRs@0x28..0x44, 6 selectors
    ES/CS/SS/DS/FS/GS@0x48..0x5C, LDTR@0x60.
    - S_TSW_READ: load the INCOMING state from the new TSS into holding regs
    (CR3@0x1C, EIP, EFLAGS, GPRs, selectors, LDTR).
    - S_TSW_SEG: reload each of the 6 incoming segment descriptors' hidden
    base/limit/attr from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
2026-06-05 M6B: reproduce Erratum 79 (V86 POPF/IRET erroneous debug exception)
    Now that system mode + V86 (M7.2) + debug registers/#DB (M2S.6) + the IDT
    delivery path (M2S.3) all exist, the deferred-at-M6 debug erratum becomes
    reachable. Reproduces Intel Erratum 79 (242480-041 printed p.50, NoFix)
    behind a new errata_en[4] bit (mask 0x10), DEFAULT OFF.
    Documented behavior (verbatim, no fabrication): in virtual-8086 mode at
    IOPL<3, POPF/IRET are IOPL-sensitive and #GP(0)-trap to the monitor WITHOUT
    accessing the stack. If a data breakpoint is armed on the SS:ESP linear
    address it must NOT fire (the stack was never touched), but the P5 erroneously
    delivers a #DB (vector 1, DR6.Bn set, saved CS:EIP == th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
2026-06-05 deps: add opl3_fpga submodule (OPL3/YMF262 FM synth) for a SoundBlaster card
    3rd-party/opl3_fpga = gtaylormb/opl3_fpga, a synthesizable Verilog Yamaha
    OPL3 (YMF262) FM-synthesis core — the FM engine of an AdLib / SoundBlaster
    Pro/16 card. Slated for an M8 SoC peripheral stage: wrap the OPL3 core with
    the SB I/O front end (FM ports 0x388/0x389 + the SB base 0x220-0x22F: mixer,
    DSP command/data, the reset port), plus the SB DSP digital-audio path (8-bit
    PCM/ADPCM via the 8237 DMA channel 1 + IRQ5). FM register behavior is
    differentially checkable (write OPL regs, the core's CPU-observable state);
    the synthesized audio output is structural/behavioral (no bit-exact oracle).
    Submodule only here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
2026-06-05 M5B-int: wire biu_p5 into rtl/ behind a default-off bus_mode (honest scope)
    Integrates the standalone pin-level 64-bit P5 bus (biu_p5) into the core's
    memory path, GATED behind a new bus_mode input (default 0). Closes the M5B-int
    deferral honestly, within the constraint that deferred it (no pin-level cycle
    oracle + the icache line-fill assumes a same-cycle combinational ack, so a
    genuinely multi-cycle bus ack corrupts the fill with nothing to re-verify
    the new timing against).
    biu_p5.sv moved to rtl/bus/biu_p5.sv (+ ventium.f); rtl/bus/biu.sv (was the M0
    stub) is the bus subsystem = a 32b FRONT adapter + the biu_p5 instance (real
    ADS#/A/BE#/W-R#/D63-0/BRDY# pins) + a loopback pin-level resp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
2026-06-05 rtl: remove the ucode_rom stub — the P5 has no P6-style uop ROM
    The P5/P54C executes x86 instructions directly; its complex / serializing
    ops (mul, div, string, far transfers, task switch, IRET, RSM, ...) are
    microcode-SEQUENCED by the slow FSM in core.sv, NOT decoded into P6-style
    micro-ops fetched from a uop ROM. The ucode_rom.sv block was an inaccurate
    M0-skeleton placeholder (an empty stub wired in as a no-op). Removed:
    rtl/ucode/ucode_rom.sv (deleted), its instantiation in ventium_top.sv, and
    its rtl/ventium.f entry; updated the block-map comment to record why there is
    no microcode-ROM block. make verify 57/57 GREEN (bit-identical — it was inert);
    lint clean.
2026-06-05 M8: PC peripheral device modules (PIC/PIT/RTC/port92/i8042/ACPI-timer/VGA-regs)
    Standalone, synthesizable SystemVerilog models of the PC platform devices, the
    first step toward a self-contained Ventium SoC. Each is a self-contained
    rtl/soc/ven_*.sv (NOT yet in ventium.f / wired into a top — integration is M8.1)
    with a directed unit self-check (verif/soc/) bit-matched to the QEMU 8.2.2
    device semantics:
    - ven_pic (576L) 8259A master+slave+ELCR: ICW/OCW, IRR/ISR/IMR, get_priority,
    pic_read_irq INTA-vector + cascade(IR2)/spurious(IR7)/poll/auto-EOI,
    edge+level(ELCR). 42/42 checks. Common iface + irq_in[15:0]/int_out/
    inta/inta_vector[7:0].
    - ven_pit (3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
2026-06-05 docs: refresh README to the current state (M7 lock-step + M8 SoC)
    The README was M0-era (it still said 'current milestone M0', referenced the
    removed ucode/ block, and a 'M0 skeleton smoke test'). Rewrote it to reflect
    reality: the implemented integer core / x87 / memory + paging / full system
    mode (segmentation, paging, IDT, TSS + HW task switch, SMM, debug regs, V86) /
    the pin-level bus / errata; the M7 macro-workload lock-step (Quake bit-exact
    ~1.1M insns, Win95 boot 213,859 insns, 6 ISA gaps found+fixed); the in-progress
    M8 self-contained SoC (PC peripheral device models); the live instruction-
    catalog site; the actual rtl/ + verif/ layout; and the real build/verify
    commands (make verify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
2026-06-05 fpu_top: extract the x87 architectural state file (bit-exact) — R2's 5th leaf
    Re-attacks the leaf R1/R2 deemed spine-bound (the FPU). fpu_top.sv (was an
    empty M0 stub) is now the real x87 STATE FILE, instantiated as u_fpu_state
    INSIDE core.sv: the architectural regs fpr[8]/ftop/fctrl/fstat/fptag, the
    synchronous FNINIT power-on reset, the TOP-relative st(i) read addressing
    (st0..st7 + raw ftop_o/fstat_o/fctrl_o/fptag_o + indexed read), and a
    write-port set covering every observed pattern — push (ftop--/fpr[ftop-1]/
    tag-clear), top-write+fstat, write-sti (FST_STI clears the tag, AR_STI_ST0
    does not), the FXCH 2-slot swap (the 2-write-port case), pop, pop2
    (FCOMPP/FUCOMPP), ffree, incstp/d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
2026-06-05 M8.1: core INTR/NMI/INTA pin + ventium_soc + 8259 PIC + 8254 PIT
    Closes the M7.3a external-interrupt gap and stands up the first SoC integration.
    Core delta (rtl/core/core.sv), minimal + additive, gated behind a new default-0
    soc_en: new ports intr (level, 8259 master INT) / nmi (edge) / inta (1-clk ack
    strobe) / inta_vector[7:0] / inta_valid; latches intr_pending / nmi_pending /
    irq_shadow (STI one-instruction inhibit) / nmi_in_progress. The S_DECODE
    priority chain gains two else-if arms RIGHT AFTER the smi block (SMI > NMI >
    INTR): NMI -> start_fault(2,...)+set nmi_in_progress; a maskable INTR (when
    soc_en && intr && IF && !irq_shadow && no higher pending) pulses inta, latches
    the PIC-sup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
2026-06-05 rtl: remove the 4 dead M0-skeleton stub modules (spine-bound leaves)
    Cleanup of the remaining empty no-op placeholder modules whose real logic lives
    in the core spine (like the ucode_rom removal). Deleted + de-instantiated from
    ventium_top + removed from ventium.f / ventium_soc.f:
    - core/fetch.sv — the fetch FSM (S_FETCH/S_PF/S_PIPE) IS the pipeline; its
    one separable piece, the I-cache, is already icache.sv.
    - core/exec_int.sv — the execute FSM (S_EXEC) IS the pipeline; its datapath,
    the ALU, is already the ventium_alu_pkg package.
    - sys/sys_state.sv — CRx / seg-hidden / GDTR/IDTR/TR/DR: many-write-port state
    writ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
2026-06-05 refactor(core): decompose core.sv 7509->4267 lines (-43%), bit-exact
    Navigability pass (R2). The core.sv spine is split with ZERO behavior change
    via two mechanisms, both verbatim text relocation (netlist no-op by construction):
    1. Pure-function extraction to 2 NEW packages (31 helpers moved verbatim):
    - core/ventium_sys_pkg.sv (15 seg/descriptor/fault/TSS-offset fns; imports
    ventium_decode_pkg for mfl)
    - core/ventium_x87_pkg.sv (16 x87 instruction-level fns; imports fpu_x87_pkg)
    reg_read/fp_bop/fri/fst/sreg_idx LEFT inline (impure - read module state).
    2. FSM include-split: the single always_ff 'unique case (state)' arms relocated as
    RAW case-arm text into 14 core_*.svh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
2026-06-05 M8.2: wire RTC + 8042 + port-92 + A20 mask into ventium_soc (per-record differential)
    Adds the three M8 PC-peripheral device models — MC146818 RTC (0x70/0x71),
    8042 keyboard controller (0x60/0x64), port-92 fast-A20 (0x92) — into the
    ventium_soc top alongside the M8.1 PIC+PIT, plus a combined A20 address mask.
    Wiring (rtl/soc/ventium_soc.sv, additive on the M8.1 top):
    - PMIO decode cs_rtc/cs_i8042/cs_port92 (non-overlapping) + read-mux extension.
    - IRQ routing: rtc_irq8->irq_in[8], kbd_irq1->irq_in[1], mouse_irq12->irq_in[12]
    (cascaded PIC; quiescent in this minimal SoC — connectivity for a future
    key/RTC workload).
    - A20 mask: eff_a20 = i8042.a20 | port92.a20; masked => phys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
2026-06-05 div: P5 DIV/IDIV occupancy (cycle fidelity) + gated mb_div bands
    First microarchitecture-fidelity closure from REVIEW_Jun5.md Limit #5 (Actions
    3/4/7/8). DIV/IDIV were native /,% in one execute clock (1 cycle) where the P5
    charges occ 17/25/41 (DIV r/m8/16/32) and 22/30/46 (IDIV); no band caught it
    (none used DIV).
    - Measured the gap: p5model charges a divl +41 cyc, the RTL charged +7 (the
    slow-FSM cost of one reg-form divide), so the modeled occupancy = occ-7.
    - rtl/core/core_exec.svh (K_MULDIV DIV/IDIV): the native helper still produces
    the bit-exact quotient/remainder (architectural vs timing separated); the
    occupancy is charged as a DEFERRED penalty via the existing pending_m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
2026-06-05 mul: P5 MUL/IMUL occupancy (cycle fidelity) + gated mb_mul/mb_imul2 bands
    The multiply analogue of the divider occupancy (REVIEW_Jun5.md Limit #5 / Action
    5). MUL/IMUL were native * in one execute clock (~7 cyc) where the P5 charges
    occ=10 (NP, U-pipe, all widths). Measured mull at p5model +10 vs RTL +7, so the
    modeled occupancy = occ-7 = 3, charged as a DEFERRED penalty (pending_mem_pen)
    -- the SAME mechanism + measured base as the divider -- for all three forms:
    1-op MUL (K_MULDIV q_md 4), 1-op IMUL (q_md 5), and 2/3-op IMUL (K_IMUL2). The
    native * still produces the bit-exact result (architectural vs timing separated).
    NEW gated bands mb_mul + mb_imul2 (verif/tests/ + the 'mul' band in
    v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
2026-06-05 fastpath: AP-500 batch 1 — accumulator-imm32 ALU now pairs (cycle fidelity)
    REVIEW_Jun5.md Limit #5 / Action 6 (expand AP-500 fast-path coverage). The
    dual-issue fast path only whitelisted a few forms; AP-500-pairable forms it did
    not recognise fell to the slow FSM and SERIALIZED. Batch 1 (lowest risk: pure
    register/immediate) adds the accumulator-immediate ALU forms 05/0D/15/1D/25/2D/
    35/3D (ALU eAX,imm32: ADD/OR/ADC/SBB/AND/SUB/XOR/CMP) in rtl/core/decode.sv (the
    8'b00??_?101 arm, mirroring the A9 TEST + 83 reg-imm arms; ADC/SBB=PU, CMP no reg).
    - Func BYTE-IDENTICAL: the fast path now executes these forms, so they must
    match QEMU -- make verify reports 65/65 goldens unchanged (0 re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
2026-06-05 test386: extend verified differential depth to 60,000 instructions
    Autonomous frontier probe: ventium_soc remains EQUIVALENT to qemu-system-i386
    byte-for-byte through 60k instructions of the test386.asm prefix (2x the prior
    30k; verified at 1.5k/30k/60k, no divergence). Doc/comment accuracy bump only —
    no RTL/gate change. ventium-refs untouched.
2026-06-05 fastpath: AP-500 batch 2 — reg-form r/m32,imm32 (81/C7) now pairs
    REVIEW_Jun5.md Action 6, batch 2 (the general-register sibling of batch 1's
    accumulator forms). Fast-paths the reg-form (mod11, no memory) immediate ops in
    rtl/core/decode.sv: 81 /r (ALU r/m32,imm32 -- the imm32 version of the existing
    83 imm8 arm) and C7 /0 (MOV r/m32,imm32 -- the ModRM sibling of B8+r). ADC/SBB=PU,
    CMP writes no reg, C7 only /0; 66-prefixed 16-bit forms stay on the slow FSM.
    - Func BYTE-IDENTICAL: make verify 66/66 goldens unchanged (mirrors the proven
    83/B8 fast-path arms).
    - They now PAIR: NEW gated band mb_rmimm (PAIR class, generalising the accimm
    branch) -- a general-reg 81/C7 op (U) + indepe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
2026-06-05 fastpath: AP-500 batch 3 — shift-by-1 (D1) now pairs
    REVIEW_Jun5.md Action 6, batch 3 (the lowest-risk remaining batch). Fast-paths
    SHL/SHR/SAL/SAR r/m32,1 (D1 /4..7, the x+x/halve idiom) in rtl/core/decode.sv --
    the implicit-count-1 sibling of the existing C1 (shift-by-imm8) arm: same shift
    datapath with shimm=1, no imm byte (len 2), reg form only (rotates /0..3 stay on
    the slow path), PU.
    - Func BYTE-IDENTICAL: make verify 67/67 goldens unchanged.
    - They now PAIR: NEW gated band mb_sh1 (PAIR class) -- a D1 shift (U, PU) leads
    a pair with an independent mov (V) -> RTL pairing 50% (matching p5model),
    abs-cyc +0.35% (vs ~0% before). PASS.
    - No regression: every M4/M5 band held; ma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
2026-06-05 fastpath: AP-500 batch 4 — near branches (E9/0F 8x) + TEST-reg (85)
    REVIEW_Jun5.md Action 6: the remaining DECODE-ONLY forms, batched (all reuse the
    existing branch/ALU execution -> zero functional risk). In rtl/core/decode.sv:
    - E9 : JMP rel32 (mirrors EB; rel=b4..b1, len 5; PV).
    - 0F 8x : Jcc rel32 (a new two-byte 0F sub-decode that fast-paths only the 8x
    sub-range, mirroring the 7x Jcc rel8 arm; every other 0F op stays on
    the slow FSM; cc=b1[3:0], rel=b5..b2, len 6; PV).
    - 85 /r : TEST r/m32,r32 reg form (reuses ALU_TEST like A9; UV).
    - Func BYTE-IDENTICAL: make verify 68/68 goldens unchanged.
    - They now PAIR: NEW gated band mb_nearbr (cmp/test->jcc idiom,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
2026-06-05 M8.3: wire VGA register file + ACPI PM timer into ventium_soc
    Wire the last two built-but-unwired device models (ven_vgaregs,
    ven_acpipm) into ventium_soc, completing the 7-device set
    (PIC/PIT/RTC/i8042/port-92/VGA/ACPI-PM).
    VGA register file (0x3B0..0x3DF): FULL per-record differential vs
    qemu-system-i386 8.2.2 (the `pvga` gate, EQUIVALENT 292/292). Matched to
    hw/display/vga.c: SEQ/GFX per-index write masks, DAC 3-byte palette
    write+read auto-increment, ATTR index/data flip-flop + masks, the
    color/mono port aliasing (vga_ioport_invalid), CRTC index/data in both
    banks + the CR0-7 write-lock (CR11 bit7, incl. CR7-bit4-always-writable),
    and the IS1 dumb-retrace toggle (verified deterministic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
2026-06-06 M8.3b: add `make verify-soc` SoC regression aggregate
    Four ventium_soc differential gates now exist (pirqsoc/psocdev/pvga/
    test386) with no single command to run them — a SoC regression could slip
    through by running only one. Add verif/soc/run-all-soc-gates.sh + a
    `make verify-soc` target (the SoC analogue of `make verify`/`verify-sys`):
    runs every SoC gate sequentially (they share the tb_soc obj_dir +
    build/soc + a gdbstub port), prints a pass/fail summary, exits 0 only if
    all pass.
    Codifies the no-regression check M8.3 ran by hand, so future SoC work
    (IDE/PCI/DMA) re-checks the whole track with one command.
    Verified: make verify-soc -> 4/4 PASS (pirqsoc EQUIVALENT, psocdev
    122/122, pvg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
2026-06-06 M8.4a: IDE/ATA controller (primary master, PIO) into ventium_soc
    First net-new SoC device build beyond the device-integration track: a
    synthesizable IDE/ATA controller (rtl/soc/ven_ide.sv), PIO mode, primary
    channel, MASTER drive — the most-impactful remaining device (Win95-boot
    histogram: IDE dominant). Preceded by a multi-agent understand-phase
    workflow (ground the ATA device in qemu 8.2.2, pin the differentiable
    surface + oracle boundaries + the disk-backend strategy) and an
    adversarial design critique; implemented oracle-first so the gate was
    EQUIVALENT on the first RTL run.
    ven_ide.sv: ATA task-file registers (0x1F0-0x1F7) + control block (0x3F6);
    a command FSM for IDENTIFY DEVICE (0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
2026-06-06 M8.4b: IDE WRITE SECTORS (PIO, single + multi-sector)
    Complete the symmetric write data-path for ven_ide (M8.4a did READ): WRITE
    SECTORS (0x30/0x31), single + multi-sector. Preceded by a research/design
    workflow (ground the WRITE handshake + the snapshot strategy) and an
    adversarial review; implemented oracle-first -> EQUIVALENT first RTL run.
    ven_ide.sv: widen wdata to 16-bit (the data port carries a full word;
    task-file regs use [7:0]); add in_write; the 0x30/0x31 dispatch arm (DRQ
    set immediately, no BSY); the data-port write arm (guarded r_status[3] &&
    in_write, mirroring qemu's ide_data_writew DRQ/pio-out guard) stores each
    outw word into disk[] at the same disk_byte the READ uses (lit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
2026-06-06 M8.4c: IDE PIO fidelity hardening (OOR-abort, CHS, reg-advance, guards, misc)
    Convert the six divergences the M8.4a/b reviews mapped from documented
    boundaries into modeled, gate-proven behavior. Research/design workflow
    grounded the qemu semantics (esp. the OOR multi-sector partial-abort
    timing); adversarial review confirmed SOUND.
    ven_ide.sv (all in the existing FSM, lint 0):
    - OOR-LBA clean abort (the one real correctness gap, was silent mod-128
    aliasing): READ aborts upfront 0x41/0x04 no-DRQ; WRITE / multi-sector
    crossing commits the in-range sectors then aborts on the OOR sector's
    last word (disk[] gated on xfer_lba<DISK_SECTORS) -- matches qemu's
    ide_sect_range_ok deferre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
2026-06-06 M8.4d: IDE ATA command-set — SET MULTIPLE / SET FEATURES / SRST
    The bounded, first-try-passable subset of the deferred IDE command set
    (the research/design workflow's Tier 1 — localized, no data-path/FSM
    touch, fully synchronous). pide gate -> EQUIVALENT 21875/21875.
    ven_ide.sv (lint 0):
    - SET MULTIPLE (0xC6): accept pow2<=16 (or 0) -> 0x50, else abort 0x41 —
    status-only; faithfully does NOT patch the cached IDENTIFY w59 (qemu
    cmd_set_multiple_mode updates only runtime mult_sectors; ide_identify
    is cached after the first call).
    - SET FEATURES (0xEF): subcmd in the FEATURE reg — 0x03 set-transfer-mode
    patches the cached IDENTIFY w62/63/88 (put_le16 into identify_data, s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
2026-06-06 M8.5: genuine radix-4 SRT divider — the Pentium FDIV bug from first principles (optional)
    Implement the *real* Pentium division datapath the famous die-photo article
    describes (Ken Shirriff, righto.com Dec 2024; Coe-Tang / Edelman SIAM Rev. 1997):
    base-4 SRT with the reverse-engineered quotient-selection PLA, added as an
    OPTIONAL compile-time feature in fpu_x87_pkg (fx_srt_pla + fx_srt_div; fx_div is
    now a +define dispatcher, default = the existing fast fx_div_exact).
    Datapath is faithful: ones-complement carry-save partial remainder (sum+carry),
    the delayed +1 correction injected into the carry LSB after a positive-digit
    (complemented) subtract, a 4-integer-bit truncated index (Edelman "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
2026-06-06 docs(sphinx): add the radix-4 SRT divider / FDIV-bug deep dive
    New reference page docs/sphinx/microarch/srt-divider.rst documenting the genuine
    radix-4 SRT division engine (M8.5): the base-4 recurrence and redundant digit
    set, the ones-complement carry-save datapath and 4-integer-bit truncated index,
    the quotient-selection PLA, the five missing +2 cells that are the FDIV bug, the
    compile-time feature flags (VEN_SRT_DIV / VEN_SRT_FDIV_BUG), the canonical
    flawed/clean results, the make verify-srt gate, and its relationship to the M6
    runtime Erratum-23 anchor.
    Wire it into a new "Microarchitecture deep dives" toctree in index.rst, note the
    genuine SRT reproduction in the intro, and cross-refer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
2026-06-06 M8.4e/e2: secondary IDE channel + empty ATAPI CD-ROM + review fold-back
    M8.4e parameterizes ven_ide (IS_ATAPI/HAS_DISK) and wires the SoC secondary
    channel (0x170-0x177/0x376) as the empty ATAPI CD-ROM master qemu auto-creates
    (ide1-cd0): 0xEB14 signature, DIAGNOSTIC status 0x00, absent-slave independent
    lcyl/hcyl=0xFF shadow.
    M8.4e2 folds back a 4-dimension adversarial review (30 findings confirmed / 4
    rejected), oracle-first (probe -> golden -> RTL), making the ATAPI dispatch
    command-specific and byte-identical to qemu:
    - DEVICE RESET (0x08): ide_reset+signature, status 0x00/error 0x00, no IRQ
    - SET FEATURES (0xEF): completes 0x50 (the empty CD has a BlockBackend)
    - FLUSH CACHE (0xE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
2026-06-06 docs(sphinx): add "Reference library — sources behind Ventium" page
    Catalog every reference class the project is built from: the ventium-refs
    archive (REF.md / MANIFEST.md / 00-index page-referenced index) organized by its
    numbered sections — §1 canonical Intel manuals/datasheets/spec-updates/SDMs/MP
    spec, §2 pipeline-internals (Alpert-Avnon, MPR), §3 optimization & timing
    (AP-500, AP-526, MMX manual, Agner Fog, GMP), §4 perf-counter methodology, §5
    die-photo reverse engineering (Shirriff, CPU Museum, patents), §6 emulator/
    decoder oracles (QEMU, Bochs, XED, ...), §7 test suites (test386.asm, the P5
    emulation harness), §8 the RTL/verification stack — plus the differential-
    veri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
2026-06-06 M8.4f-pre: minimal PCI config shim (maps the bus-master IDE BAR4)
    First of the two M8.4f (bus-master DMA) increments. A research workflow
    empirically probed the gate's own qemu-system-i386 8.2.2 and found a fixed-port
    BMIDE decode is NOT differentiable: the PIIX3 IDE at PCI 00:01.1 has its
    bus-master BAR4 unmapped at reset, reading 0xFF until the guest programs BAR4 via
    0xCF8/0xCFC and sets PCI_COMMAND.IO. A minimal PCI config shim is a hard
    prerequisite.
    ventium_soc.sv: a single-function (bus0/dev1/fn1) config shim decoding
    CONFIG_ADDRESS (0xCF8) + the CONFIG_DATA window (0xCFC), modeling exactly the
    registers a driver touches, pinned to the live golden:
    vendor/device 0x70108086 (RO), cl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
2026-06-06 docs(sphinx): add a "System architecture" overview page with Graphviz diagrams
    New top-level page docs/sphinx/architecture.rst describing the two layers of the
    design, each with a rendered block diagram:
    * the core microarchitecture — the P5/P54C five-stage, in-order, dual-issue
    pipeline (PF front end + BTB, D1 decode/pairing, D2 operands/AGU, EX with the
    U/V pipes and the x87 FPU incl. the radix-4 SRT divider, WB + bypass) plus the
    L1 I/D caches, TLB and the 64-bit BIU;
    * the SoC integration — the core (soc_en=1) on the memory + PMIO buses with the
    ven_* peripheral models (8259A PIC, 8254 PIT, MC146818 RTC, 8042, port-92,
    VGA, ACPI PM, IDE primary + secondary ATAPI) and the I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
2026-06-06 M8.4f: IDE bus-master DMA engine (single-PRD READ DMA) + review fold-back
    The Win95-boot DMA path, on the M8.4f-pre PCI/BAR4 seam. pide gate: EQUIVALENT
    24040/24040 (oracle-first; all DMA values pinned to the live golden first).
    ven_ide.sv (HAS_DMA=1 on the primary): the BMIDE register file (BMIC cmd&0x09 /
    BMIS DMAING+W1C / BMIDTP dword), a READ DMA (0xC8) arm, and a PRD-walk +
    single-sector copy FSM driving a NEW single-beat memory-master port. On the BMIC
    START 0->1 edge with a DMA armed, it reads one 8-byte EOT PRD from RAM, copies
    512 B disk[]->RAM (little-endian, byte-identical to a PIO read), then clears
    DMAING + status 0x50 + advances the LBA regs. Under nIEN the completion IRQ is
    g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
2026-06-06 docs(sphinx): redraw architecture diagrams in Pentium-manual style + RTL file labels
    Redraw both block diagrams to match the Pentium Processor manual's Fig. 1 style:
    top-down flow, square boxes, nested colored units (the gray integer datapath with
    Address-Generate / Integer Register File / ALU U+V / Barrel Shifter, and the red
    FPU with Control / FP Register File / Add / Divide / Multiply), orthogonal
    connectors, off-chip Data/Address/Control bus stubs on the left rail, and
    bus-width labels (256/64/32/80). The SoC diagram gets the same square-box TB
    treatment.
    Every block is annotated with the RTL file that implements it. Corrected to use
    only files that actually exist: prefetch, the slow-pa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
2026-06-06 docs(rtl): rewrite the block map to match what is actually in rtl/
    The block map listed six files that do not exist (fetch.sv, exec_int.sv,
    regfile.sv, mem/dcache.sv, ucode/ucode_rom.sv, sys/sys_state.sv) and marked real
    R2-extracted modules as 'stub'. Rewrite it to reflect the tree: the R1/R2
    modularization (packages + decode/issue_uv, then bpred_btb / icache /
    dcache_timing / tlb / fpu_top + the sys/x87 helper packages, all carrying live
    logic), the standalone pin-level biu_p5.sv and its default-OFF biu.sv wrapper,
    and what genuinely still lives in the core.sv spine (prefetch, microsequencer,
    integer exec + regfile + bypass, FPU scoreboard, page-walk). Add the SoC layer
    table (ventium_soc.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
2026-06-06 M8.4d2: READ/WRITE MULTIPLE (0xC4/0xC5) block-mode PIO + review fold-back
    Pivot from DMA hardening (oracle-blocked: gen_trace single-step can't differentiate
    qemu's async DMA beyond a single-PRD single-sector READ — documented). A research
    workflow picked READ/WRITE MULTIPLE as the highest-Win95-value differentiable PIO
    item. pide gate: EQUIVALENT 38656/38656.
    ven_ide.sv (additive — the only qemu difference vs 0x20/0x30 is req_nb_sectors):
    - mult_sectors reg (reset 16 = MAX_MULT_SECTORS); 0xC6 SET MULTIPLE now STORES it
    (w59 stays the cached 0x0110 — qemu freezes IDENTIFY on the first 0xEC).
    - r_blk_size (1 for SECTORS, mult for MULTIPLE) + blk_left per-window counter.
    - 0xC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
2026-06-06 M8.5: full PCI host bridge - bus-0 enumeration + BAR sizing + review fold-back
    Generalizes the M8.4f-pre single-function shim into a bus-0 config-space the way a
    real BIOS/OS enumerates. A research workflow empirically probed the live gate qemu
    (-machine pc) to capture every bus-0 function's config. pide gate: EQUIVALENT
    38788/38788 (first RTL run, oracle-first). (SoC-track M8.5; distinct from the FPU
    SRT-divider M8.5 - a numbering coincidence.)
    ventium_soc.sv (additive, no new module): pci_sel (bus 0 + enable), pci_devfn,
    pci_reg; a per-devfn config-read table for the 5 chipset-core functions -machine pc
    creates, all values pinned to the live golden:
    00:00.0 i440FX host 0x12378086 / cla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
2026-06-06 M9: first real boot - firmware chain-loads a boot sector from the IDE disk
    The smallest thing that is genuinely BOOTING, and what the whole M8 SoC build was
    for. A research workflow empirically proved (and PoC'd) that ventium_soc can do
    this with ZERO new RTL. New pboot gate: EQUIVALENT 1084/1084 (per-record vs the
    qemu-system single-step golden).
    The boot flow (all synchronous -> single-step-differentiable; verif/sys/tests/pboot/):
    pboot_stub.bin (-bios) boots at F000:FFF0 -> real->protected (flat GDT) -> sets
    nIEN FIRST (no IRQ14) -> READ SECTORS disk LBA0 via PIO into RAM 0x8000 -> far-jmps
    into it. The boot sector (pboot_mbr.bin, disk LBA0, ending 0x55 0xAA) then EXECUTES
    FROM R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
2026-06-06 M9b: DMA chain-load boot — BIOS→MBR handoff via bus-master DMA
    A second -bios firmware (pboot_dma_stub.S) that boots real→protected, sets
    nIEN FIRST, then chain-loads the boot sector (disk LBA0, the SAME pboot_mbr.bin
    the M9 PIO gate uses) with bus-master DMA into RAM at 0x8000 and far-jmps into
    it. Combines two already-gate-proven pieces — the M8.4f single-PRD READ DMA and
    the M9 boot/handoff — into one boot with ZERO new RTL.
    Recipe (byte-for-byte the proven M8.4f single-PRD READ DMA, the only DMA shape
    single-step-differentiable under gen_trace's no-AIO-pump oracle): enable
    PCI_COMMAND.IO|bus-master + map BMIDE BAR4=0xC000 (0xCF8/0xCFC devfn 0x09),
    build one EOT PRD @0x5000 →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
2026-06-06 Gate hygiene: add verify-all umbrella target + clear the ppci orphan
    verify-all: one command that runs EVERY routinely-runnable gate (verify +
    verify-sys + verify-soc + verify-srt + m6 + bus + bus-sva) with a single
    pass/fail summary, so a regression in the bus-protocol SVA, the errata flag, or
    the SRT divider can no longer slip through by only running the differential
    aggregates. The m7 macro co-sims (Quake/Win95) are EXCLUDED-and-logged (not
    silently dropped): they need gitignored producer artifacts that cannot be
    regenerated from a clean checkout — the driver prints how to run them manually.
    Validated green: VERIFY-ALL-OK, all 7 gates PASS.
    Also removed the untracked verif/sys/tests/p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
2026-06-06 M9-rm: canonical real-mode boot — chain-load to 0000:7C00
    The boot the way a PC BIOS actually does it: a -bios firmware (pboot_rm_stub.S)
    that STAYS in 16-bit real mode the whole time (no GDT, no CR0.PE, no PM far-jmp),
    sets nIEN FIRST, reads boot sector LBA0 via 16-bit IDE PIO (inw/stosw into
    es:di=0000:7C00), and far-jmps 0x0000:0x7C00 into a 16-bit real-mode boot sector
    (pboot_rm_mbr.S) that writes a distinct signature (0x7C00B007/0x600DF00D @0x9000)
    and isa-debug-exits. Third boot variant after M9 (PIO->0x8000) and M9b
    (DMA->0x8000); the only one that never leaves real mode. ZERO new RTL.
    EQUIVALENT 1065/1065 on the first RTL run; cr0 stays the reset 0x60000010 on
    every record (never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
2026-06-06 M12 x87: special-operand Inf/NaN masked arithmetic + IE/ZE flags
    Closes a silently-wrong hole: fx_add/fx_mul/fx_div did mantissa math on Inf/NaN
    operands and returned garbage. M12 adds QEMU-faithful masked-default handling,
    EQUIVALENT vs qemu-i386 over the new tx_fp_special directed test.
    Minimal-blast-radius design (vs the heavier tuple-widening alternative): a new
    f_special(sub,a,b) classifier in ventium_x87_pkg, PREPENDED in f_eval (which
    already intercepted 0/0 and x/0 before the datapath). On an Inf/NaN operand it
    returns the masked result + IE and the fx_* datapath is bypassed -- so ZERO
    tuple/bus width changes (f_eval/f_arith_fstat/s_arf/the FX_AR_* arms untouched,
    normal-operand ops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
2026-06-06 Add SPDX license headers to all source files
    // Copyright 2026 Anhang Li (AL-255, thelithcore@gmail.com)
    // SPDX-License-Identifier: Apache-2.0 WITH SHL-2.1
    Applied to all 260 owned source files with per-type comment syntax:
    // -> .sv .svh .cpp .h .c (64 files)
    # -> .s .sh .py Makefile (157 files, after any shebang)
    /* */ -> .S .ld (39 files, cpp- and ld-safe)
    Skipped (no comment support / data / docs / config / binary / submodules):
    .json manifests, *.golden traces, .md/.rst docs, .dot/.txt/.png/.bin, .f/.yml/
    .gitignore/.gitmodules, and the ventium-refs + 3rd-party/opl3_fpga submodules
    (never modified). Idempotent: re-running ski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
2026-06-06 M11a x87: env-pointer state + FIP/FCS/FDP/FDS tracking + FTW classifier (inert)
    The foundation for M11 (FNSTENV/FLDENV/FNSAVE/FSAVE/FRSTOR), staged separately to
    PROVE it is inert to grading before the M11b sequencer wires it up. Oracle-pinned
    via 6 parallel qemu probes (the field rules are in memory: m11-x87-env-spec).
    New architectural state in u_fpu_state (rtl/fpu/fpu_top.sv): fip/fcs (32b/16b FPU
    instruction pointer) + fdp/fds (data pointer). New latch ports + read ports;
    cleared on reset and FNINIT.
    Latch driver (core.sv, the slow-arm FP commit): FIP=q_pc + FCS=SEG_CS latch on
    every NON-control FP op (incl FNSTSW %ax); FDP=dbase+q_ea + FDS=SEG_DS only on
    memory-operand FP ops; control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
2026-06-06 M11b-1 x87: FNSTENV — the variable-length env-image sequencer
    The first env/state op and the hardest part of M11: it proves the entire new
    mechanism end-to-end. FNSTENV (D9 /6) writes the 28-byte protected-mode env image
    EQUIVALENT vs qemu-i386, including the REAL FIP/FCS/FDP/FDS (from the M11a
    tracking) and the content-derived FTW.
    New RTL:
    - fpu_top.sv: fpr_flat_o (the 8 physical regs flattened) for the FTW + ST slots.
    - core.sv: new states S_FENV_ST/S_FENV_LD + a wide beat counter f_seq_step[4:0]
    (the existing load/store FSM caps at 10 bytes); the env_tmp[] load holding regs;
    the flat fenv_image[863:0] MUX (dword j = image[j*32+:32]; dwords 0..6 = the env,
    7..26 = the 8 ST slots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
2026-06-06 tools/pipeviz: PySide6 pipeline visualizer over the verilated RTL
    Interactive GUI that runs Vventium_top (verilated --public-flat-rw) as its
    backend and reads live internal core/cache/TLB/FPU state via the generated
    ___024root struct (cross-module reference), driving the same clk/reset/mem_*
    loop as verif/tb. Panels: U/V/FP pipeline stage board + cycle timeline, the
    code/data caches, split TLB and prefetch buffer tables, the retired-instruction
    trace with bytes + capstone disassembly, and the architectural registers.
    Self-contained under tools/pipeviz/ (libventium_viz.so C ABI + ctypes); does not
    touch rtl/ or the verification build.
2026-06-06 M11b-2 x87: complete FLDENV/FNSAVE/FRSTOR + 2 review-caught fidelity fixes
    Completes the M11 env/state family (FNSTENV landed in 23861ab). EQUIVALENT vs
    qemu-i386: tx_fenv (FNSTENV + a FLDENV round-trip) and tx_fsave (FNSAVE + FRSTOR)
    both pass; the FSIN loud-HALT boundary still PASSES.
    - FLDENV (D9/4): S_FENV_LD latches the 7 env dwords, commits CW/SW/TOP verbatim +
    re-derives the per-reg empty bits from the loaded FTW (new fpu_top we_envld port).
    - FNSAVE (DD/6): reuses S_FENV_ST at 27 beats (env + 8 ST slots) + FNINIT-reinit on
    the last store beat (image captured pre-reinit).
    - FRSTOR (DD/4): S_FENV_LD at 27 beats + reloads the 8 ST regs (we_envregs); dword 26
    is read live from mem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
2026-06-06 pipeviz: waterfall timeline, SoC backend (test386), x86 byte colouring
    - Pipeline waterfall: Y=time (cycles down), X=stages grouped U|V|FP; slow
    multi-cycle instructions streak diagonally PF->D1->D2->EX->WB, fast path
    lights EX+WB, FP streaks X1/X2/ER.
    - Full-SoC backend (libventium_viz_soc.so, -DVV_SOC): wraps ventium_soc so
    bare-metal images needing the SoC's internal port-I/O/PIC/PIT run — e.g. the
    test386.asm CPU test from ventium-refs (8.5k+ instructions vs 4 on bare top).
    - x86 byte-field colouring in the trace: prefix/opcode/ModRM/SIB/disp/imm.
    - CS.D-driven 16/32-bit disasm + CS.base linear byte fetch (real-mode correct).
    - Cache-occupancy heatmaps for I$/D$; live stats bar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
2026-06-06 pipeviz loop iter1: legibility, density & cross-panel linking
    Adversarial 5-critic visual review (45 findings) -> shipped: fixed stage-board
    header collision + de-emphasised empty cells + idle-FP dim; waterfall stall/
    mispredict legend+colours, per-row cycle labels, U|V|FP group tints/separators;
    trace Δcyc stall column + U/V pipe colours + zebra + reclaimed space + neutral
    mnemonics; 2D set×way cache heatmap with axes+legend, no byte truncation;
    register change-highlighting; grouped toolbar/status; click trace row -> link to
    waterfall cycle. Adds gen_review_shots.py + docs/improvement-log.md.
2026-06-06 pipeviz: gem5/Konata per-instruction pipeline view
    Replace the per-stage waterfall with a true gem5/Konata superscalar timing
    diagram: Y=instructions (one row each, retire order), X=cycles. Each insn's
    lifecycle is reconstructed from the per-cycle FSM trace and drawn as a run of
    stage cells (F fetch/fill, D decode, X exec, M mem, W wb, = stall, ! flush) so
    consecutive instructions cascade diagonally. Integer exec green, x87 FP purple;
    D-cache-miss stalls stretch as amber = runs before the X. Frozen instruction-
    label gutter + synced cycle axis; click-to-link + hover preserved.
2026-06-06 pipeviz loop iter3: anti-staleness review + trace filter + branch-byte colour
    Root-caused the 'critics review old UI' problem: the review workflow's critic
    prompts still described the OLD waterfall/heatmap, priming hallucinations.
    - Review harness: gen_review_shots watermarks every screenshot (build sha+time,
    +dirty when ahead of HEAD); the workflow now regenerates shots itself and
    critics must report the watermark + a 'what I see' inventory; synthesis drops
    findings whose watermark != current build. Updated the log's UI section to HEAD.
    - Real fix: relative branch rel8/16/32 targets (jmp/jcc/call/loop) were coloured
    red (immediate); now yellow (displacement). Real immediates stay re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
2026-06-06 M14 free-run: cycle-based synthetic clock + coremark score-line mask
    - syscall_emu: drive the time syscalls off the RTL cycle count (60 MHz: 1 cyc =
    16.667 ns) with a +1ms/call floor, so a long compute shows a realistic elapsed
    time. coremark 4000 then sees >10s and prints "Correct operation validated"
    (matching qemu) instead of the <10s ERROR; the exact seconds still differ from
    qemu (masked at grade time), only that time elapses matters.
    - tb_main: declare `cycles` before service_proxy so the emulate clock can read it.
    - run-freerun.sh: mask the final "CoreMark 1.0 : <score>" throughput line too.
2026-06-06 pipeviz loop iter4: IPC sparkline + Konata polish (watermarked review)
    First review with the anti-staleness harness: critics reported the correct build
    watermark and described the real UI; synthesis source-verified and dropped two
    'branch byte is red' findings as perception errors (rel8/disp already yellow).
    Shipped:
    - New feature: IPC/stall sparkline strip (windowed IPC + per-cycle event pixels).
    - Stage board: fix clipped top header; collapse idle FP group -> wider U/V stages.
    - Konata: bigger cells, wider gutter, amber 'Nc' stall badge per instruction
    (its cycle span), enlarged legend (FP no longer clipped).
    - Cache heatmap: stop last set-tick/way-label edge clipping.
    - Trace: narrow by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
2026-06-06 M14 checkpoints: periodic complete-state save (the 2nd replay mechanism)
    - MemModel::snapshot/restore — dump/load the sparse page set (working-set sized).
    - dpi_retire: stash the latest retired arch state (regs+segs) in g_last_arch
    every vtm_retire (works even with the trace at /dev/null in free-run).
    - tb --checkpoint-every N --checkpoint-dir D (free-run): every N retired insns,
    dump {g_last_arch + MemModel snapshot} to a 2-deep ring at a retirement
    boundary (this in-order core is quiescent between retirements). The newest
    checkpoint before a divergence is the restart/inspect point.
    - Verified: matmul_int free-run writes ckpt.{0,1}.bin every 100k insns and still
    exits with corre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
2026-06-06 pipeviz loop iter5: distinct stage palette + branch byte colour + two-way select
    - New feature: two-way Konata<->trace selection (click a Konata cell/label ->
    selects + centres its trace row; trace->Konata already worked).
    - Konata: distinct per-stage palette (fetch blue / fill amber / decode teal /
    mem orange / exec green / wb magenta / stall grey) fixing the dec==wb==blue,
    fill==stall==amber ambiguity; legend moved to its own line (no clip); wider
    stall badge.
    - Trace: dedicated orange 'branch' colour for rel8/16/32 targets (distinct from
    yellow memory offset); bytes column clips with ... so long encodings don't
    collide with the disasm.
    - Registers: EFLAGS as a full named-bit g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
2026-06-06 Quake free-run + framebuffer capture: endbr NOP, host file I/O, video stream
    The headline finding (a real RTL gap): the core HALTed on CET endbr32/endbr64
    (F3 0F 1E FB/FA) and the multi-byte NOP (0F 1F /r) — qemu (our oracle, any -cpu)
    and every non-CET CPU retire these as hint-NOPs. musl/libgcc emit endbr32 at
    function entries (e.g. __divmoddi4), so Quake hung at its first 64-bit divide.
    core.sv now decodes the whole 0F 1E/1F space as NOP (consuming the modrm via
    mfl_e). Provably inert to the corpus (no directed test or benchmark uses these
    opcodes; was d_unknown->HALT). make verify rebuild pending (obj_dir busy with the
    running sweep); built+validated in obj_dir_emu.
    M14 emulator — fi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
2026-06-06 pipeviz loop iter6: Hotspots profile + reclaim Konata height + glyph/legend fixes
    - New feature: per-PC Hotspots tab (perf/VTune-style) — hits + total cycles per
    PC with amber cost bars, sorted by cost (stalls inflate it); surfaces the
    stalled dec ecx as 72% of cycles on mb_dmiss.
    - Reclaimed Konata height (recurring 'only ~6 rows' finding): compact stage board
    + rebalanced splitter -> ~29 instruction rows visible.
    - Stage-board stall cell was exec-green; now grey.
    - Konata: I-cache line-fill uses 'L' (amber), distinct from 'F' fetch (blue).
    - Legend pairing fix (recurring 'legend colours rotated' perception): each swatch
    tightly coupled to its label with a clear inter-entry gap, i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
2026-06-06 pipeviz loop iter7: Memory inspector + stall-run collapse + cycle gridlines
    - New feature: Memory hex/ASCII inspector tab (type addr / follow EIP/ESP / page;
    EIP bytes cyan, ESP amber).
    - Konata: contiguous stall runs collapse into one =N block (D-miss reads as =7
    not 7 grey cells); per-cycle vertical gridlines every 10 cycles; widened the
    instruction gutter so full mnemonics show (no more ...-truncation).
    - Real bug: page-walk colour == flush colour (#f85149); walk now pink.
    - Trace: widened bytes column so 9-10-byte encodings show fully before the ...
    clip (balances iter5 anti-collision).
2026-06-06 M14 fb: periodic video-stream flush (see Quake frames mid-run)
    Write the captured P5Q1 stream to --video-out every ~4M retired insns so a long
    render run can be converted to PNG without waiting for exit_group (the first
    VID_Update is hundreds of M insns deep).
2026-06-06 pipeviz loop iter8: Branches/BTB panel + synthesised F->D->X pipeline cascade
    - New feature: Branches/BTB inspector tab (per-branch-PC type/target/hits/taken/
    taken%/bias bar; taken inferred from next retired PC vs parsed target).
    - Konata fast-path now synthesises P5 Fetch+Decode stages before commit, so
    instructions cascade diagonally F->D->X like a real superscalar diagram
    (fixes the recurring 'all single X' finding).
    - wb recoloured slate-blue (was in the wb/FP/walk purple-pink cluster).
    - Stage board: label sits in one stage cell (no EX/WB straddle); fixed the
    clipped 'FP idle' corner label.
    - Trace: narrowed bytes column; delta shows +N only on a stall gap.
2026-06-07 pipeviz: register pinning + cycle playhead, split-colour insn labels, stage gridlines
    Iteration 9 of the self-improving visual loop.
    New feature: pin the register panel AS-OF a retired instruction + a cyan
    cycle playhead. Clicking a trace row or Konata cell/label pins the regs to
    that instruction's post-commit architectural state (banner PINNED n/cyc) and
    drops a playhead at its commit cycle; stepping unpins.
    Review-synthesis fixes:
    - Split-colour instruction labels (Konata gutter + trace insn column): dimmed
    mnemonic, operand/branch-target in the full class accent so the target pops.
    - Stage-board per-stage column gridlines anchoring each lit cell to its
    PF/D1/D2/EX/WB column; stage c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
2026-06-07 pipeviz: fix Konata auto-follow regression + add cycle-Δ measurement cursor
    Iteration 10 of the self-improving visual loop. The new adversarial Verify
    phase refuted 5 of 6 synthesis picks (perception errors / already-shipped /
    low-value); ground-truthing the unpicked HIGH findings caught a regression I
    shipped in iteration 9.
    - FIX (regression, HIGH): iter-9's row-aligned bottom-snap left the scroll
    value below max, so the next tick's value>=max-4 follow check failed and
    Konata auto-follow died -- any workload overflowing the viewport (fp, brloop)
    rendered a BLANK grid (rows listed, zero cells). Auto-follow is now explicit
    stick-state toggled only by a user scroll (guarded vs our o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
2026-06-07 pipeviz: fix Konata horizontal framing + sparkline navigation overview
    Iteration 11 of the self-improving visual loop. Verify refuted 5 of 6 picks;
    ground-truthing the unpicked HIGH findings surfaced two more real ones.
    - FIX (confirmed, HIGH): Konata horizontal framing. The horizontal follow
    pinned to the raw FSM max_cyc while vertical follow tracked the bottom rows;
    for a long non-retiring tail (test386 ends in S_DECODE, max_cyc ~50 cyc past
    the last retirement) the visible rows' cells scrolled off the left edge,
    rendering a blank timeline (horizontal twin of iter-10's vertical regression).
    The horizontal stick now anchors the left edge to the topmost visible row's
    first cell,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
2026-06-07 pipeviz: cycle-attribution tab + crop-accuracy fix + readable stage grid
    Iteration 12 of the self-improving visual loop. Verify confirmed 0 of 6 picks
    (all perception/low-value); ground-truthing the unpicked HIGH findings myself
    separated real from noise and surfaced two root causes.
    - Review-harness ROOT CAUSE: screenshot crop boxes were hardcoded (right column
    at x=1010) but the outer splitter is 3:2 so the right column starts at x=922 --
    the crops sliced ~88px off the left of the tables/regs panels every round.
    THAT is why critics kept 'seeing' clipped register names (a perception error
    driven by a real harness bug). Crops now computed from live widget.mapTo()
    geometry, so they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
2026-06-07 pipeviz: PC-group highlight + sparkline headroom + system-op colour
    Iteration 13 of the self-improving visual loop. Verify confirmed 2 of 7 picks;
    ground-truthing the rest settled the recurring 'lgdt looks like a branch' as a
    real colour-proximity problem (not a classification bug).
    - NEW: PC-group highlight. Clicking an instruction tints every other row with
    the same PC (loop iterations) plus a blue left-edge marker, so a stalled
    iteration stands out among its repeats. mb_brloop: clicking 'dec ecx' lights
    all 105 iterations.
    - FIX (confirmed): IPC sparkline top headroom. A sustained IPC=2.0 filled the
    band to the top edge and painted over its own 2.0 rule line. Capped bar height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
2026-06-07 pipeviz: event-jump navigation + review-harness wrong-panel fix
    Iteration 14 of the self-improving visual loop. A trace critic caught a real
    harness bug (which I'd have dismissed as a perception error): dmiss_trace.png
    showed the PIPELINE panel, not the trace. Ground-truthing the on-disk crops
    confirmed it -- dmiss_trace was 2000x400, dmiss_regs 1280x1190, fp_pipeline
    2000x410: all bigger than the 1640x980 window.
    - Harness fix: settle layout before cropping. The geometry-accurate crops read
    widget.rect(), but a QSplitter can take an extra event-loop pass to constrain
    a panel after a content change; cropping while a panel still held its
    unconstrained size-hint framed the WRONG region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
2026-06-07 pipeviz: trace effect column + register-gap fix + branch-colour consistency
    Iteration 15 of the self-improving visual loop. Verify confirmed 0 of 6 picks;
    value came from ground-truthing unpicked HIGH findings + a recurring request.
    - NEW: trace 'effect (writes)' column. Shows what each retired instruction
    architecturally WROTE -- destination GPR(s) with committed value + changed
    flags (eax=60000011 ZF0; xor ax,ax -> eax=00000000 PF1 ZF1). Subtlety found by
    inspecting raw records: the commit GPR snapshot is PER-CYCLE, so naively
    diffing consecutive retirements smears a dual-issue U/V pair's writes onto the
    U row (mov eax,[esi] wrongly showed esi=...). Fixed by attributing writes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
2026-06-07 proxy: recvfrom 517->371 (i386) + socketcall recv-capture; doc netlink boundary
    Triaging the Quake lockstep divergence at __netlink_enumerate (n~1.83M):
    - recvfrom was 517 (=recvmmsg_time64); i386 recvfrom is 371. Fixed. Also added
    socketcall(102) RECV/RECVFROM buffer capture (musl -ENOSYS fallback path).
    Both are correct proxy-fidelity improvements.
    - ROOT CAUSE of the divergence is NOT a CPU bug and NOT a capture gap: musl s
    netlink interface enumeration depends on the host PID (getpid/set_tid_address
    return the host pid/tid, which vary per qemu launch — the documented m7
    nondeterminism), and here that PID STEERS CONTROL FLOW (the netlink seq/request
    -> response -> parse). Tw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
2026-06-07 pipeviz: sparkline fills width, playhead cycle callout, palette/layout polish
    Iteration 16 of the self-improving visual loop. Verify confirmed 3 of 7 picks;
    ground-truthing caught two self-inflicted issues.
    - NEW: playhead cycle callout. The cyan Konata playhead now carries a 'cyc N'
    chip pinned to the top of the visible region.
    - FIX (confirmed): sparkline fills the panel width. Bars were 1px/cycle from the
    left, filling only ~20% for a ~160-cycle run. Each cycle's bar/event pixel now
    scales to plotw/shown px (contiguous); _cyc_at/hover updated to match so
    click-to-seek still lands right (mid-strip click -> middle cycle, verified).
    - FIX (recurring root cause): system-op colour,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
2026-06-07 fpga: KV260 synth-fit rework — iterative FDIV/FSQRT/IDIV/FBSTP + icache LUTRAM (518%→111% LUT, 3.6→37.5 MHz)
    Make the Ventium core synthesizable and (nearly) fit the KV260 XCK26 PL by
    replacing the rare-but-deep COMBINATIONAL arithmetic monsters with multi-cycle
    iterative FSM engines, all gated behind +defines and verified bit-exact vs the
    combinational golden + QEMU lockstep. New fpga/ folder holds the durable plan
    (PLAN.md), target list (TARGETS.md), the timing backlog with per-rework synth
    numbers (TIMING_PROBLEMS.md), and the Vivado OOC synth-probe tcl + xdc.
    Engines (one step/clock; busy-state mirrors S_FP_BUSY; result commits via the
    existing fp_we_*/we_top driver on the engine'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
2026-06-07 pipeviz: Instr-mix tab + Konata gridlines + x87 value-column separation
    Iteration 17 of the self-improving visual loop. Verify confirmed 3 of 7 picks;
    all three real and clean.
    - NEW: 'Instr mix' tab. Retired-instruction-class histogram (branch/fp/mem/alu/
    sys) with %-bars, plus the U/V issue-port split as a realised-dual-issue proxy.
    brloop reads '50% via the V-port' (perfect dec/jne pairing); fp shows the fp
    class; dmiss shows alu+branch+mem.
    - FIX (confirmed, HIGH): Konata cycle gridlines legible. Per-cycle gridlines were
    #171c24 (near-black, invisible against the dark plot) so you couldn't tie an
    F/D/X cell or =8 stall to a cycle number. Raised to #2b3340 (~2x contrast),
    ke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
2026-06-07 fpga: P0-4 consolidate redundant f_eval — CORE NOW FITS KV260 (111%→91.7% LUT)
    The four S_FEXEC x87 arithmetic commit arms (FX_AR_ST0_STI / STI_ST0 / M32M64 /
    I16I32) each called f_eval with their own operands, so synth built FOUR full
    add/mul/round cones and muxed the OUTPUTS (compute-then-mux). Mux the OPERANDS per
    q_fxop instead (reusing the s_fa/s_fb the SRT divide-eligibility block already
    computed) and call f_eval ONCE — the arms just route the shared s_arf to their
    write port. Behaviour-identical: each arm's (a,b) is reproduced exactly; s_arf is
    consumed only by those arms (harmlessly computed for non-arith ops). The fast-arm
    fp_arf (decode-time operands) stays a separate eval.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
2026-06-07 pipeviz: neutral mnemonics, wider Konata cells, x87 exceptions, playhead column
    Iteration 18 of the self-improving visual loop. Verify confirmed 1 pick;
    ground-truthing caught a colour regression from my iter-15 change.
    - FIX (HIGH, self-inflicted): branch 'orange blob'. Iter 15 unified CC_BRANCH to
    rel-orange; with the split-colour delegate dimming the mnemonic by hue, a
    branch's jne went dim-orange, inconsistent with the grey mnemonics elsewhere.
    Mnemonic is now a single neutral grey #939ba6 for ALL ops (trace + Konata
    gutter); only the operand/target carries the class accent (jne grey, target
    orange).
    - FIX (recurring): wider Konata cells. CELL_W 16->20 so F/D/X glyphs are leg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
2026-06-07 pipeviz: compact register rows, redder branch-orange, per-cell Konata tooltip
    Iteration 19 of the self-improving visual loop. Verify confirmed 0 picks; value
    came from ground-truthing the unpicked HIGH findings by MEASURING the layout.
    - FIX (HIGH): register rows wasted ~half their height on gaps. Measured a 32px
    row pitch for ~14px text (group boxes stretched to fill the tall panel). Added
    a trailing stretch to each register column so the boxes size to content
    (compact rows); rebalanced the right splitter to [600,300] so the compact
    register panel isn't over-tall and the cache table gets the height. (Confirmed
    the 'GPR name-value gap' finding is stale -- ~4px, fixed in iter 15.)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
2026-06-07 fpga(fp-pipe 1/N): bit-exact 2-stage split of fx_add/fx_mul/f_eval (foundation)
    First layer of the +VEN_FP_PIPE 3-stage FP execute pipeline (the ~14ns fx_add
    logic floor means single-cycle FP can't clear 66 MHz; the scoreboard already
    models fadd latency=3, so a 3-stage pipe fits the modeled window and keeps both
    FP cycle bands). This commit adds ONLY the datapath split — dead code in the core
    until the FSM is wired, so zero behaviour change.
    Split at the shared fx_round_pack boundary:
    * fpu_x87_pkg: fx_pipe_t (carries the round_pack args or an early/special
    result between the two cycles) + fx_add_s1 / fx_mul_s1 (the FRONT: unpack/
    align/add or multiply -> significand; specials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
2026-06-07 pipeviz: playhead-behind-cells, stall-bar inset, amber Δ-band, off-screen chevron
    Iteration 20 of the self-improving visual loop. Verify confirmed 0 picks;
    ground-truthing (2x-zoomed Konata crops) caught two HIGH regressions from my own
    recent features.
    - FIX (HIGH, self-inflicted): playhead washed out the cells it crossed. Iter 18's
    playhead cycle-column tint was alpha-blended OVER the cells, so a green X / teal
    D under the marker desaturated to a faint glyph. Moved the column tint (and the
    Δ-band fill) to draw BEHIND the cells -- opaque cells paint on top, tint shows
    only through inter-cell gaps. Confirmed at 2x zoom the cells are fully opaque.
    - FIX (HIGH): stall bar overran t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
2026-06-07 fpga(fp-pipe 2/N): FAST-arm 2-stage FP execute pipeline (+VEN_FP_PIPE)
    Splits the fast-arm (cycle-mode S_PIPE) FK_ARITH critical cone
    eip->icache->decode->f_eval->fpr across two clocks, behind +VEN_FP_PIPE (default
    build byte-identical — all logic define-guarded; the new fpu_top ports are tied 0
    and optimise away).
    Mechanism (in-flight depth 1):
    * ISSUE (clock N): the FK_ARITH fast arm captures its operands (ST0, ST(i)),
    aluop, rc, errata and the ABSOLUTE target index (ftop) into fpp_*, and retires
    normally (eip advances, scoreboard fp_ready_cyc = issue+lat unchanged). The
    live-operand f_eval is REMOVED from the issue cone (fp_arf tied 0) — that cone
    is the whole point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
2026-06-07 pipeviz: x87 hex split, FP-lane cleanup, keyboard shortcuts
    Iteration 21 of the self-improving visual loop. Verify confirmed 1 pick. Also
    pixel-sampled the trace to CONCLUSIVELY close the perennial 'rel byte is yellow'
    finding: f8 renders red-orange (166,52,34 R/G=3.2 B=34, vs salmon immediate at
    B~107), 271 red-orange pixels in the bytes column -- a definitive perception
    error; the colour stands.
    - FIX (confirmed): split the x87 80-bit hex + dim empty slots. The 20-hex blob is
    now '4005 ae00000000000000' (sign/exp word + 64-bit mantissa) so the floatx80
    fields are readable; an empty slot's all-zero hex is dimmed to #4b535d (live +
    pinned) so it reads as empty.
    - FIX (HIGH, recurring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
2026-06-07 fpga(fp-pipe 3/N): SLOW-arm FP execute pipeline via S_FEXEC_EX (+VEN_FP_PIPE)
    Completes the FP execute pipeline. After the fast-arm split, the post-place worst
    path was the SLOW arm (S_FEXEC memory-operand arith: f_mem80->f_eval->fpr, ~30ns).
    This splits it across two clocks behind +VEN_FP_PIPE.
    KEY INSIGHT: the differential harness in FUNCTIONAL mode (what `make m3` uses)
    checks architectural state AT EACH RETIRE — and functional mode routes ALL FP
    ops through the SLOW FSM (the cycle-mode fast path is off). So the slow arm CANNOT
    use the fast arm's retire-before-commit defer (the deferred fpr write lands one
    clock after retire, so the per-retire check sees stale st0). The slow arm must
    C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
2026-06-07 pipeviz: reclaim Konata height, stall contrast, narrower bytes, drill-down
    Iteration 22 of the self-improving visual loop. Verify confirmed 0 picks;
    ground-truthing (measuring the panel) drove the layout fixes several HIGH
    findings kept circling.
    - FIX (HIGH x2): Konata starved of height. Measured the StageBoard at 122px +
    sparkline 58px leaving the headline Konata only an 188px viewport (11 rows).
    Tightened the sparse stage board to 100px (18px lanes) -> Konata viewport 210px
    / 13 rows, no clipping.
    - FIX (HIGH, recurring): stall bars near-invisible. The collapsed =N stall bar's
    border was near-black #1b1f26 that vanished on the dark/amber-Δ-band rows. Gave
    it a light #aab4c0 b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
2026-06-07 fpga: iterative FBLD (ven_bcd_to_fp) — split the BCD->FP load cone (+VEN_BCD_ITER)
    Once the FP arith was pipelined (+VEN_FP_PIPE), the worst LOGIC path became FBLD:
    the slow-arm push fp_we_push = fx_bcd_to_fx(f_mem80), an 18-chained-*10 BCD->int
    accumulation (~189-deep CARRY8, ~19.5ns standalone) feeding the fpr push — the
    load-side twin of FBSTP. Replace it with a multi-cycle engine, like ven_bcd did
    for FBSTP.
    * rtl/fpu/ven_bcd_to_fp.sv: accumulates the 18 BCD digits MSD-first, TWO *10
    steps per clock (~9 clk), then int64->floatx80 (fx_from_int, exact: 18 digits
    < 1e18 < 2^63) in FIN. Bit-exact to fx_bcd_to_fx. Gate `make verify-fbld`
    (verif/fbld): FBLD-GATE-OK over 40k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
2026-06-07 pipeviz: 'stuck' livelock banner, wider gutter, crisp stage gridlines
    Iteration 23 of the self-improving visual loop. Verify confirmed 1 pick (the
    stuck banner). Ground-truthing the rest: the stage-board EX|WB 'no break' was
    mostly perception (the fast-path correctly lights EX+WB with a gridline between),
    but the gutter-mnemonic + gridline-crispness findings were real.
    - NEW: 'stuck' livelock diagnostic. When the sparkline's trailing run of
    zero-retire cycles exceeds 64 AND the core is wedged in a front-end/halt state
    (S_DECODE/S_FETCH/S_HALT/S_F00F_HANG), it overlays a red 'stuck in S_DECODE --
    86c, 0 retired' banner over the IPC band. Correctly stays off for a normal slow
    decode (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
2026-06-07 fpga: pipeline the BTB update (+VEN_BTB_PIPE) — shave the BTB tail off the worst path
    After the FP pipeline + iterative FBLD removed all FP cones from the critical
    path, the #1 path became eip -> u_bpred_btb/btb_ctr_reg (63 levels). A 3-agent
    investigation (workflow) found BRAM is the wrong fix: the BTB is 64-deep (shallow,
    won't infer BRAM — same as icache) AND the BTB array read is NOT on the path —
    only 13 of the 63 levels (21%) are the BTB counter update; the other 50 (79%) are
    the upstream eip->icache->decode->issue_arm front-end gate, which can't be
    deferred (single-cycle dual-issue).
    The cycle-SAFE, achievable lever: register the BTB resolve inputs one clock so the
    btb_ctr UPDA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
2026-06-07 pipeviz: per-instruction cycle breakdown, wider bytes, brighter operand split
    Iteration 24 of the self-improving visual loop. Verify confirmed 0 picks;
    ground-truthing (zoomed crops) drove four real fixes.
    - NEW: per-instruction cycle breakdown in the Konata tooltip. Hovering an
    instruction shows where its cycles went -- 'breakdown: 7xStall 2xMispredict
    flush 1xFetch 1xDecode' for an 11-cyc dec ecx -- so you can read WHY an
    instruction was slow.
    - FIX (HIGH, recurring): bytes column truncation. Widened bytes 140->176px (the
    stretching instruction column still gets ~273px); more of each encoding shows
    before the ellipsis, tooltip covers the longest.
    - FIX (med): operand-accent sp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
2026-06-07 pipeviz: colour-coded effect column, latency grading, legible cells
    Iteration 25 of the self-improving visual loop. Verify confirmed 1 pick
    (effect-column colour split); ground-truthing settled the recurring
    stage-board/trace findings and the 'U/V is dim grey' claim (already blue/amber).
    - FIX (confirmed): colour-code the effect column. 'eax=60000011 ZF0 FP:ZE' was one
    flat blue blob. A new EffectDelegate paints register writes (eax=) blue, integer
    flag changes (ZF1 SF0) teal, and x87 exception groups (FP:ZE) amber.
    - NEW: latency badges colour-graded by magnitude. The Konata gutter's per-row Nc
    latency badge is dim grey for a normal fast op, amber for a moderate stall, red
    for a h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
2026-06-07 pipeviz iter26: operand field-colouring everywhere, playhead lines behind cells, chip-backed overflow chevron, 9-tab review sweep
    - disasm.operand_segments: tokenise operands into field-coloured runs
    (immediate=salmon, displacement=gold, branch-target=red-orange, regs neutral)
    - wire field-colouring into the trace instruction column, the Konata gutter,
    and the Hotspots instruction column (new reusable InsnCellDelegate)
    - Konata: cyan playhead + amber Δ-anchor LINES now draw BEHIND the cells (were
    still on top after iter20 moved only the tint), so no vertical stripe punches
    through an F/D/X glyph; only the cyc/Δ labels stay on top
    - Konata: overflow '>' continuation chevron paints o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
2026-06-07 pipeviz iter27: x87 ST(0) writes in trace, pinned-x87 column fix, prefetch idle guard, empty-table hints
    Adversarial review confirmed 3 of 6 picks (refuted 3: redundant empty-slot dot,
    intentional Hotspots-occupancy-vs-wallclock totals, Run-button-green sampling error).
    - trace effect column: surface the x87 ST(0) result of an FP op as 'st0=<value>'
    (purple #c89bff, decoded via floatx80_to_float, diffed vs the previous retirement)
    so a non-faulting fadd/fld/fmul is no longer a blank no-op [CONFIRMED MEDIUM]
    - prefetch tab: when the slow-path ibuf is all-zero (idle, fast-path fetch) show an
    'ibuf idle' note instead of decoding the zeros into a bogus 'add [eax],al @ eip'
    that contradi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
2026-06-07 pipeviz iter28: producer->consumer dependency edges, right-aligned profiler columns, 'S sys' legend
    Adversarial review confirmed 2 of 6 picks (refuted 4: filter-placeholder contrast
    = sampling error; x87 live/pinned tag 2-vs-4-hex = different data sources; Instr-mix
    uniform-gold bars = deliberate table convention; TLB 'D' header = conventional MMU
    bit like V).
    - NEW FEATURE: producer->consumer dependency edges on the Konata view. disasm.read_regs()
    (mirror of written_regs, keeps capstone's read-set) feeds per-insn read/write reg-sets;
    selecting an instruction walks insns[] backward to the most-recent writer of each source
    register and draws a labelled edge from that producer's commit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
2026-06-07 pipeviz iter29: flag-dependency edges, left-aligned bar-column headers
    Adversarial review confirmed 1 of 6 picks (refuted 5: trace top-row sliver = settled
    scroll-overflow at the top edge; pinned Segments 'baselimit' = false, 11px gap measured;
    ppage 'eax' label = the settled dep-edge label, not clipped; Data$ line-addr stretch =
    the uniform last-column convention like TLB 'D'; effect-column st0-decimal-vs-eax-hex =
    disambiguated by colour+width+register-name).
    - NEW FEATURE: dependency edges now cover EFLAGS. disasm.read_regs also reports
    flags-read (symmetric with written_regs); the Konata model carries reads-flags/
    writes-flags per insn; selecting a conditional branch draws a 'flags'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
2026-06-07 pipeviz iter30: resolved memory-access address in the trace, singular/plural subtitle
    Adversarial review confirmed 1 of 2 picks. The features-critic's top pick (per-stall
    CAUSE attribution on the '=N' bubble) was REFUTED -- and ground-truthing had already
    shown pending_mem_pen reads 0 on every dmiss stall (all are stall_cnt 'issue' stalls),
    so its 'D$-miss' tint would never fire; it would also duplicate the StageBoard split +
    dep-edge gating + lat grading. Picked a genuinely-new reliable feature instead.
    - NEW FEATURE: resolved memory-access address in the trace. disasm.mem_operand extracts
    a load/store's addressing (base/index/scale/disp; skips lea/nop which carry a
    non-accessing mem o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
2026-06-07 pipeviz iter31: Memory '→access' follow mode (watch the program's memory frontier)
    Adversarial review confirmed 0 of 4 picks -- the UI is mature; every pick was refuted
    as already-surfaced (per-PC latency dispersion = the Konata 'lat' column; register
    value timeline = the trace effect column; Hotspots cost-bar floor = the intentional
    ASCII-bar convention). No fixes this round; picked a genuinely-new feature instead.
    - NEW FEATURE: Memory tab '→access' follow + gold access highlight. Building on iter30's
    resolved @<ea>, the Memory inspector gains a 4th follow button (→EIP/→ESP/→access):
    →access tracks the most-recent retired load/store address and gold-outlines its EXACT
    ac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
2026-06-07 pipeviz iter32: Mem-map access-pattern scatter (address vs sequence)
    Adversarial review confirmed 0 of 0 picks (2nd straight saturated round); the features
    critic returned 'None worth shipping' and -- reading my in-progress AccessMap source
    mid-run -- independently concluded the access-pattern scatter was the remaining gap.
    - NEW FEATURE: Mem map tab -- an address-vs-sequence SCATTER of the memory-access
    stream the trace already resolves. One point per retired load/store (X = retire
    order n, Y = effective address low-at-bottom), loads blue / stores gold, auto-scaled
    axes + empty-state hint. The access PATTERN reads as a SHAPE the per-row trace @<ea>
    list can't show: dmiss's strided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
2026-06-07 pipeviz iter33: interactive Mem map (click a point -> readout + trace jump)
    Adversarial review confirmed 0 of 0 picks (THIRD straight saturated round); the features
    critic returned 'None remains'. So this iteration is the anticipated honest outcome: a
    modest refinement of the just-shipped Mem map, not a brand-new surface.
    - REFINEMENT: make the Mem-map access scatter interactive. Clicking a point rings the
    nearest one with a white crosshair, reads out its n/cyc/@address/load|store in the
    header (in the point's load-blue/store-gold), and emits pointSelected(n) -> the trace
    jumps to that retire-n row + pins regs (mirroring the Konata/Hotspots drill-downs), so
    an outlier or stripe in t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
2026-06-07 pipeviz iter34: Mem-map dominant-stride annotation
    Adversarial review confirmed 0 of 0 picks (FOURTH straight saturated round; features
    critic: 'None'). Per the converged-loop discipline, a small ground-truthed enhancement
    to a recent feature, not a forced new surface.
    - REFINEMENT: dominant-stride annotation on the Mem map header. The scatter's slope
    shows a strided walk as a shape; the header now also states the NUMERIC stride -- the
    mode of the consecutive-access address deltas with its share, e.g. dmiss reads
    'stride +0x20 (100%)'. 0x20 is exactly the 32-byte cache line, so a 0x20 stride means
    every load lands on a fresh line and misses -- the whole dmiss story in three tokens.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
2026-06-07 pipeviz iter35: Mem-map -> Memory click link + '@' filter discoverability
    Adversarial review confirmed 0 of 0 picks (FIFTH straight saturated round; 'None').
    Maintenance mode: two small ground-truthed additions. First ruled out two dead
    candidates by probe -- a trace 'mem' filter token is redundant (typing '@' already
    isolates exactly the memory rows, since the filter substring-matches the effect text's
    @<ea>), and store->load edges stay at one pair.
    - REFINEMENT: a Mem-map point click now ALSO pins the Memory tab to that access. It
    already ringed the point + jumped the trace; it now navigates the Memory inspector to
    that access's address and gold-outlines its EXACT byte span (size carr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
2026-06-07 pipeviz iter36: Mem-map selection robustness (track stable retire-n, not a volatile index)
    Adversarial review confirmed 0 of 0 picks (SIXTH straight saturated round; 'None
    remains'). A genuine small CORRECTNESS fix found by my own code review, not a cosmetic
    tweak. (First verified the cross-panel drill-downs already pin regs symmetrically:
    select_n/select_pc -> setCurrentCell -> currentCellChanged -> _on_row emits rowSelected
    + instSelected, so Hotspots/Branches/Konata/Mem-map clicks are all consistent.)
    - CORRECTNESS: the Mem-map clicked selection now survives the access-stream rolling
    cap. It was stored as a list INDEX, but the trace caps accesses at 4000 and drops
    older ones off the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
2026-06-07 pipeviz iter37: D-cache replay miss-rate (Data$ header) + Memory-pin reset-on-load fix
    After SIX straight 0-pick rounds the review surfaced a genuinely-new CONFIRMED pick
    (MEDIUM): no panel reported a D-cache hit/miss OUTCOME though the access stream + cache
    geometry are both already on hand. Ground-truthed first (LRU replay: dmiss 100% miss,
    test386 9%, ppage 30% -- distinct + meaningful) before building.
    - NEW FEATURE (CONFIRMED): replayed D-cache miss-rate in the Data$ header. _dcache_replay
    runs trace.accesses through a client-side DC_SETS x WAYS x LINE (128x2x32B) LRU model
    (the same geometry as the hardware dcache_timing), tagging each access hit/cold-miss/
    conflict-evict, and a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
2026-06-07 pipeviz iter38: per-PC D-cache miss column in Hotspots
    Adversarial review confirmed 0 of 0 picks (the iter37 D-cache feature was a one-off).
    Shipped the complementary surface the iter37 verifier itself named -- ground-truthed
    feasible + meaningful before building.
    - NEW FEATURE: per-PC D-cache MISS column in Hotspots. Where iter37's Data$ header gives
    the AGGREGATE miss-rate, this attributes each replayed miss to the load/store PC that
    made it. _dcache_per_pc runs the access stream through the same 128x2x32B LRU model
    and tallies (accesses, misses) per PC via the access tuple's retire-n -> the Konata
    insns' PC map. A new 'D$ miss' column shows misses/accesses for memory PCs (blank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
2026-06-07 fpga: consolidate the 6 FP-compare cones (apply_cmp/fcom_codes) — area for routability
    Lower-util area reduction toward routability (the routing wall): the six x87
    compare arms (FCOM/FUCOM/FCOMPP/FUCOMPP/FTST/FICOM) each called fcom_codes +
    fcom_ie + apply_cmp with their own operand, so synth built SIX compare cones then
    muxed the outputs. Mux the operand + signaling per q_fxop, compute fcom_codes/
    fcom_ie/apply_cmp ONCE; each arm just routes the shared s_cmp_fstat to its write
    port + does its own pop/pop2 (same mux-then-eval trick as the f_eval win 705d1ff).
    Behaviour-preserving (default path, no define). Verified: default `make verify`
    75/75 incl. tx_cmp / tx_fcomnan / tx_fxam. Lint cle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
2026-06-07 pipeviz iter39: robust per-PC D$ miss attribution (carry PC in access tuple)
    The iter38 per-PC D-cache miss column attributed each replayed miss to a PC by
    mapping the access retire-n through the Konata insns' {n: pc} table. The insns
    list rolls at 9000 while the access stream can reference a retire-n that has
    already scrolled out of that window (long, sparse-memory runs), so an in-table
    memory PC's older accesses were silently under-counted.
    Fix at the source: trace.accesses now carries the PC directly
    (n, cyc, addr, is_store, size) -> (n, cyc, addr, is_store, size, pc), and
    _dcache_per_pc attributes each miss to the access's own a[5] PC, independent of
    the insns window. Simplified the hel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
2026-06-07 pipeviz iter40: honest instruction-column elision + dep-label off the cells
    Adversarial visual review (6 critics, all confirming the live 959d9d4
    watermark) surfaced 3 confirmed defects after a long 0-pick convergence; a
    4th (pinned-Segments header collision) was refuted on verify and a
    "wasted-whitespace" finding dropped as a normal column gutter. Each fix was
    re-zoomed before and independently re-verified after (3/3 resolved, no
    regression).
    1. Trace instruction column (InsnDelegate) elides with a gray "…" instead of
    hard-clipping a glyph mid-immediate. A long imm in a long memory operand
    (ppage's `mov dword ptr [ebx+0x14], 0xcf90000`) truncated to `0xcf9` with NO
    ellipsis, sil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
2026-06-07 pipeviz iter42: GUI clean; fix review-harness watermark tofu box (U+2192 -> ASCII)
    Adversarial visual review (6 critics, all confirming the live f00a448
    watermark) confirmed 0 GUI defects after iter40/41's run of real picks — a
    healthy converged outcome. Two raw findings were source-refuted (FP-exec 'X'
    is a deliberate glyph=phase x colour=pipe encoding; the pinned Segments header
    is a Qt QGridLayout with no string-spacing to collide — thrice-refuted).
    The lone real defect lives in the screenshot harness, not the GUI:
    gen_review_shots.py draws the amber anti-staleness watermark band with
    ImageDraw.text() and no font= arg, so PIL's default bitmap font (no U+2192
    glyph) rendered the 'Memo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
2026-06-07 readme: FPGA synthesis section — KV260 device view (colored by module) + best numbers
    Add a device view of the real Vivado `core` placement on the KV260 XCK26, every
    placed leaf cell colored by its RTL module (153,101 cells, 12 modules) so the
    physical clusters are visible: I-cache, FP datapath, branch predictor, the
    iterative FP engines, the core spine, ... Plus the best-numbers table.
    Best so far (OOC core, all bit-exact vs QEMU 75/75 + cycle bands):
    CLB LUTs 89,661 / 117,120 = 76.6% (FITS) — from 518% baseline, ~6.8x reduction
    FF 12.6%, CARRY8 14.1%, DSP 7.6%, BRAM 0
    Fmax: synth ~59.5 MHz (worst-path logic 6ns), placed ~47 MHz. 66 MHz not met OOC
    — the gap is routing/conges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
2026-06-07 pipeviz iter43: clean 0-pick review (converged) — log entry only
    Adversarial visual review (6 critics, all confirming the live ed1be59
    watermark) produced 0 actionable picks: both raw findings were the same
    pinned-mode Segments base/limit "crowding" claim, dropped by synthesis against
    the REFUTED list (refuted a 4th time). Re-examined at 4x zoom: the base/limit
    headers are clearly space-separated (Qt QGridLayout, can't overlap) and the
    per-row n/a is dimmed italic to read as "not captured" — the pin snapshot
    carries selectors, not descriptor base/limit, so n/a is honest. No change
    manufactured.
    Source review of regs_view.py found no firing bug: floatx80_to_float decodes
    inf/NaN/denormal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
2026-06-08 pipeviz iter45: clean 0-pick review (3rd straight) — log entry only
    Adversarial review (6 critics, all confirming the live 6b332e4 watermark)
    produced 0 actionable picks again. The new dmiss_statbar.png crop (iter44)
    reviewed cleanly — full status row, complete eip, no fabricated truncation,
    validating that fix. All 4 raw findings refuted: 3 were the recurring
    pinned-Segments compact-n/a claim (re-confirmed clear gaps at 5x zoom), and 1
    a NEW perception error — a trace "scrolled-off row sliver" — disproved two
    ways: the verify's row-brightness profiling found spread=0 (uniform empty
    gutter, not glyph tails), and a 3x zoom shows the column header seated against
    the first FULL row (the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
2026-06-08 pipeviz iter46: clean 0-pick review (4th straight) — log entry only
    Adversarial review (6 critics, all confirming the live ad92fbb watermark)
    produced 0 actionable picks again. Syncing the review's SETTLED/REFUTED list
    with the recently-settled items cut raw findings from 4 to 1, and that one was
    the perennial pinned-Segments base/limit "collision" — demolished this round at
    the SOURCE level: regs_view.py proves live+pinned share one QGridLayout
    (alignment is layout-driven, not font-metric-driven) and the pinned path just
    setText("n/a") on the same base/limit cells, so the "header tuned for full-hex
    metrics" premise describes code that doesn't exist. (The verify also claimed
    the pinned c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
2026-06-08 fpga: narrow icache rd_lineB to 128b (+VEN_IC_NARROWB) — cut the MUXF congestion root
    The OOC route won't converge because of LEVEL-5/6 routing congestion that the
    congestion analysis pinned to u_icache's F7/F8 read-mux trees (the 2-port 256-bit
    256-deep distributed-RAM line read). AltSpreadLogic placement couldn't dissolve it
    (the MUXF is architecturally bound to its LUTs) — so the lever is RTL.
    rd_lineB is the NEXT (straddle) line; the spine's ic_byte slices it only at LOW
    byte positions: ub[i]=byte(flin+i), vb[i]=byte(flin+u_d.len+i), i<=5, and the
    decoder NEVER emits len>6 (verified: only 1/2/3/5/6) — so the worst-case straddle
    byte is flin[4:0]=31 + len 6 + i 5 - 32 = position 10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
2026-06-08 fpga: measure +VEN_IC_NARROWB placed impact — synth 64.1 MHz, placed wall holds at 47.6
    Narrowing rd_lineB lifted SYNTH 59.5->64.1 MHz (LUTRAM 4096->3072, MUXF -12%) and
    moved the icache OFF the synth critical path (now the FP deferred-commit cone). But
    the PLACED Fmax is UNCHANGED at 47.6 MHz with congestion still level-5 / 99% u_icache
    MUXF: narrowing cut the read-port WIDTH, not the 256:1 read-mux DEPTH, and the binding
    cone is the irreducible rd_lineA 256:1 read (all byte positions reachable).
    - Read-narrowing is exhausted at the placed level; documented the two remaining levers
    (full-SoC context = no fidelity risk, recommended; or BRAM + registered fetch = +1
    cycle, needs cycle-o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
2026-06-08 l1/axi step 1: ven_l1d — L1 data array + line-fill FSM (unit-verified)
    First independently-verifiable piece of the ventium_l1_axi memory subsystem (task #23,
    the user's chosen full-SoC path to 66 MHz). The DATA half dcache_timing never had.
    rtl/mem/ven_l1d.sv: 8KB/2-way/32B unified L1 sitting between the core's same-cycle-ack
    mem_* and a backing mem_* (BFM now, AXI4->PS-DDR later). Packed 256-bit lines in
    distributed RAM (icache pattern, async read => same-cycle hit), tag/val/lru == the
    dcache_timing 2-way LRU. READ HIT: addressed word combinationally + c_ack=1 same clock.
    READ MISS: c_ack=0 (stall), fill FSM bursts the 32B line (8 words) into the not-MRU
    victim, retry hits. WRITE: write-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
2026-06-08 fpga: Vivado strategy sweep (P0-9) — no directive breaks the congestion wall + regenerate device view
    A 6-agent workflow enumerated ~10 untried Vivado synth/place/route strategies; the top
    candidates were tested EMPIRICALLY at a meetable clock with a full route. Verdict: NO
    synth/place/route directive reaches 66 MHz, and the MUXF-reducers actively regress.
    Key empirical results (TIMING_PROBLEMS.md P0-9):
    - The README's old '47.6 MHz placed' was a 15ns placer ESTIMATE that does NOT route.
    - 18ns: default + AltSpreadLogic both FAIL to route (15,971 / 4,524 congestion overlaps).
    - opt_design -muxf_remap (the panel's rank-1 lever): the ONLY flow that routed at 18ns,
    but at 35 MHz — it dem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
2026-06-08 dec-pipe step 1: fp_len length-only sub-decoder + exhaustive equivalence gate
    First step of the +VEN_DEC_PIPE decode-stage pipeline (the RTL lever P0-8/P0-9 named to
    break the 12x32:1 byte-window MUXF congestion = the OOC ~45 MHz routing wall). Design
    from the 6-agent workflow wf_84e2ef64, captured in fpga/DEC_PIPE_DESIGN.md (decoupled
    PF->D1->D2 + byte-aligned circular queue; de-risked spike with an early route-probe
    kill criterion).
    This step adds ventium_decode_pkg::fp_len(b0,b1,cyc) — a length-only projection of
    decode.sv's fp_decode .len, sound because NO fp_decode arm's length depends on b2..b5
    or flags (every .len is a constant from opcode b0 + ModRM b1 + cycle_mode). The D1 stage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
2026-06-08 fpga: u_icache-rebalance floorplan result + device plots in README
    The user's spatial idea, measured: a Pblock that forces the byte-window decode logic
    (u_icache, the flatten artifact) to spread across the upper die cuts peak MUXF
    congestion 63-65% -> 52-57% and PLACES MET at 22ns (46.5 MHz, 0 failing). But the
    route stays congestion-limited (the router thrashes, overlaps oscillating 10<->35K) so
    it was killed before a clean route -- floorplanning alone can't break the wall (the
    added wirelength from spreading defeats the router). Confirms the real lever is the RTL
    decode pipeline.
    README: rebalanced device view (colored by module) + the baseline-vs-rebalanced
    u_icache spread comparison plo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
2026-06-08 dec-pipe step 2: prefetch byte queue (shadow) — mirror-verified, zero cycle change
    The +VEN_DEC_PIPE prefetch unit: a free-running 16-byte sliding-window byte queue between
    the icache line buffers and decode. iq[i] holds the present byte at iq_base+i; the read
    offset iq_head=flin-iq_base is derived COMBINATIONALLY so the extracted 12-byte window is
    always aligned to the CURRENT flin (no one-cycle lag, no invasive next-eip weaving). The
    registered side slides the base toward flin, refills ahead from the icache, and flushes on
    a redirect (flin out of window). Decode STILL reads the old single-cycle ub/vb path this
    step (zero cycle change) — the queue is a parallel shadow.
    A sim-only MIRRO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
2026-06-08 dec-pipe step 4b: the CUT — decode reads the byte queue (functional 75/75; cycle bands WIP)
    THE cut: under +VEN_DEC_PIPE, ub/vb are re-sourced from the byte-aligned queue
    (iq[iq_head+i], a 4:1/16:1 extract over flops) instead of ic_byte (32:1-over-256). The
    byte-window MUXF + the icache line read leave the combinational eip cone — they now live
    in the REGISTERED prefetch (8:1 word-select fill). The eip self-loop no longer threads the
    256:1 byte mux.
    Correctness fixes found in bring-up:
    - 32-byte queue (16 deadlocked: the word-granular slide lags this clock's consume by an
    edge, so off=(prev&3)+consume reaches ~15; a 12-byte window needs 27 bytes).
    - iq_covers gates ISSUE on U's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
2026-06-08 Revert +VEN_DEC_PIPE (decode-stage pipeline) — MUXF conserved, doesn't break the wall
    The decode pipeline was functionally bit-exact (make verify 75/75 + Quake, queue == icache)
    but the OOC synth probe was a clear negative: MUXF went UP (F7 14457->17342, F8 6202->7066),
    LUTs 76.9%->87.9%, synth ~40 MHz (worse than narrowB 64.1), worst path eip->iq (the prefetch
    fill, 95 levels). The byte-alignment mux is CONSERVED (re-sourcing ub/vb adds the queue
    slide+extract+prefetch MUXF >= what it removes); pipelining relocates the MUXF off the
    critical path but not off the congestion (the density). Reverted to the verified narrowB
    ~46.5 MHz config. Verdict documented in TIMING_PROBLEMS.md P0-10. Defa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
2026-06-08 docs: refresh reference-library to match ventium-refs
    §7 P5 emulation harness: name the benchmark suite (CoreMark/Dhrystone/
    Whetstone/STREAM/LINPACK + kernels/microbench) and add the two endurance
    workloads now in the harness — the TyrQuake P5 build (quake/) and the
    Windows 95 boot environment + C:\SW software library (win95/), plus the
    isa_verify/trace_compare tooling.
    §2 pipeline-internals: add the RTL Engineering P5/Pentium microarchitecture
    video transcripts (rtl-engineering-transcripts/) as a secondary source.
    Docs only; no RTL or submodule changes.
2026-06-08 fpga: FP-area shrink (−9,635 LUT, bit-exact) + predecode-on-fill µop-cache + full APR
    FP datapath area (P0-13, all bit-exact — make verify 75/75 + cycle bands):
    * fx_to_int_ex 128→64-bit: the FP→int conversion (FIST M16/M32/M64 + erratum +
    FBSTP/ven_bcd) carried a 128-bit barrel shifter whose high 64 bits are always
    zero (a 64-bit mantissa shifted ≤63). Narrowing it bit-exactly halves all five
    shared instances → −8,636 LUT.
    * shared-round f_eval split: the +VEN_FP_PIPE deferred commit now uses the verified
    f_eval_s2(f_eval_s1(...)) split (one shared fx_round_pack instead of fx_add's +
    fx_mul's two), guarded on +VEN_SRT_ITER → −999 LUT.
    * (the mantissa multiply wa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
2026-06-08 docs: link RTL Engineering videos; bump ventium-refs to latest
    - reference-library §2: add a table of the RTL Engineering P5/Pentium/x86
    front-end videos (title -> YouTube link) whose transcripts are archived in
    ventium-refs/rtl-engineering-transcripts/.
    - bump the ventium-refs submodule pointer 83a9d2c -> bfac13b (latest main:
    pulls in the transcripts plus the win95 software library, test386, and the
    resync trace comparator), so the docs references resolve on a clean clone.
2026-06-08 cycle-fidelity GAP1: model the P5 FDIV/integer overlap (+VEN_FP_OVERLAP)
    The _GAPS_vs_ventium.md survey (RTL-engineering P5 transcripts) flagged the single
    most Quake-relevant cycle-model gap: the P5's FDIV early-exception logic lets the
    INTEGER pipe keep executing during the ~39c FDIV shadow — only a FOLLOWING FP op
    stalls — which is why Quake's perspective-divide texture mapper overlapped the FP
    divide with fixed-point integer texel addressing. Both the RTL cycle model and the
    p5trace.c oracle shared the gap (one in-order pipe_free_at=issue+occ serialized the
    integer work behind the 39c FDIV occupancy). Fixed in BOTH, behind a define; default
    OFF is byte/cycle-identical.
    Oracle (verif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
2026-06-08 cycle-fidelity GAP2: model the P5 free-FXCH stack rename (+VEN_FXCH_FREE)
    Second gap from _GAPS_vs_ventium.md: the P5 executes FXCH as a stack-pointer/tag
    RENAME in parallel with an adjacent FP op (~0 cycles), giving x87 flat-register
    flexibility Quake leans on. Modeled in BOTH the p5trace.c oracle and the RTL,
    behind a define; default OFF is byte/cycle-identical (mb_faddchain golden 9201
    unchanged, full make m5 all pre-existing bands identical).
    Finding first: in LATENCY-bound FP (a dependent fadd chain) FXCH is ALREADY ~free
    (it hides in the 3-cycle fadd latency gap) — measured 0.1%. The gap matters only
    for THROUGHPUT-bound FP (back-to-back independent ops): consecutive fld producers
    w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
2026-06-08 L1+AXI4: full-core bus_mode=2 boot (+VEN_L1_AXI), 76/77 mode-2 equiv
    P1-1 step 3 — boot the WHOLE Ventium core through ventium_l1_axi (ven_l1d +
    ven_axi_master -> AXI4 -> PS DDR). All behind +VEN_L1_AXI (+ a real_bus core input
    tied 0 in modes 0/1) so the DEFAULT build is BYTE-IDENTICAL — make verify stays
    GREEN (75/75 func + all M4/M5 cycle bands), the mode-0 canary.
    RTL:
    - ventium_top: mode-2 leg (l1axi_en) instantiates ventium_l1_axi between core_mem_*
    and new m_axi_* top ports; 3-way bus mux (modes 0/1 'else' is the exact original);
    direct mem_* held inert in mode 2 (all memory via m_axi).
    - core (ifdef VEN_L1_AXI): D-side fast-path MISS-STALL gate (real_bus && pipe_load_req
    &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
2026-06-08 L1+AXI4: mode-2 functional gate vs QEMU golden -> L1AXI-VERIFY-OK 77/77
    The full-core bus_mode=2 boot is bit-exact vs QEMU across the WHOLE corpus, not 76/77:
    the lone ad-hoc-sweep 'tx_fsave stall' was a --quiesce artifact (a 27-beat FNSAVE in
    mode 2 goes ~108 clocks with no retire; default --quiesce 64 reads that as an idle
    core). The AXI handshake completes cleanly every beat (verified by tracing the master
    W FSM AW->W->B per beat).
    - verif/l1/run-l1axi-verify.sh (NEW): the proper mode-2 FUNCTIONAL gate. Reuses
    verify_worker.sh + the mode-0 QEMU golden cache, with TB_BIN=obj_dir_l1axi and
    TB_EXTRA_FLAGS='--l1-axi --quiesce 200000', parallel across cores -> L1AXI-VERIFY-OK
    (77/77 RTL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
2026-06-08 L1+AXI4: adversarial-review hardening + system-mode gate (77/77 + 10/10)
    A 23-agent adversarial review of the bus_mode=2 integration confirmed 6 real bugs,
    ALL latent (none can trigger in the verified path: the behavioral slave never errors/
    mis-asserts RLAST/stalls, the corpus is syscall-light, the shipped remap is identity).
    They are real-HARDWARE robustness gaps. Fixed the behavior-preserving ones; the rest
    need a CPU-arch decision (deferred, documented in L1_AXI_DESIGN.md §6).
    Hardening (ven_axi_master, identical timing for a compliant slave -> gates + 77/77 +
    10/10 unchanged):
    - READ-BEAT COUNTER: R_DATA exits on the accepted-beat count vs ARLEN, not a
    (possibly mis-asserted) RLAST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
2026-06-09 L1/AXI #34: AXI watchdog + bus_err -> core S_HALT (deadlock-proof)
    Group-A robustness: a stuck DDR/bridge no longer hangs the chip forever. ven_axi_master
    gets a per-FSM STALL WATCHDOG (WATCHDOG cycles with no progress) that raises a sticky
    bus_err (= timeout | rresp_err | bresp_err) WITHOUT retracting the AXI handshake (a
    master cannot un-assert VALID -- AXI has no cancel; the FSM holds, ar_stable SVA stays
    clean). bus_err routes ven_axi_master -> ventium_l1_axi(_top) -> ventium_top -> a new
    core 'bus_err' input -> a last-write-wins S_HALT + cpu_hung override (the core abandons
    the stuck access + halts; the PS observes cpu_hung/bus_err and resets). Also exposed as
    a ventium_top + BD-wrapper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
2026-06-09 L1/AXI #36: dual-clock CDC + reset sync (+VEN_AXI_CDC, P1-3)
    Lets the core run at a slow Fmax-limited core_clk while the AXI link to the PS
    DDR runs at a faster MMCM axi_clk (hiding DDR latency at full S_AXI_HPC0 BW).
    All behind +VEN_AXI_CDC; the default single-clock CDC_BYPASS build is a pure
    net-alias passthrough — byte/cycle-identical (make verify 77/77 + all bands,
    L1AXI-VERIFY 77/77 user + 10/10 system, 3 L1 unit gates all unchanged).
    ven_l1d + ven_axi_master are UNTOUCHED: ven_axi_master only ever used its
    core_clk port (axi_clk was a lint-sink), so the CDC build hands it axi_clk and
    inserts a bridge between the two backing ports. Three new modules:
    - ven_cdc_afifo: 2-FF Gray-pointe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
2026-06-09 F2-A2/A3/A4: KV260 full-system BD synthesizes — the whole core on the PS
    Completes the PL side of the PS-assisted KV260 SoC (the PS A53 emulates all slow
    peripherals in software; the PL holds only core + L1 + AXI-master + the two thin
    PS bridges).
    - ventium_top.sv: a gated [VEN_KV260_SOC] `retire_count` output (taps the existing
    retire_n counter) so the PS can observe forward progress. Default + L1AXI builds
    (no VEN_KV260_SOC) are byte-identical — confirmed L1AXI-VERIFY-OK (77/77 + 10/10).
    - rtl/soc/ventium_kv260_core.sv (+ ventium_kv260_top.v BD wrapper): the PL top =
    ventium_top + ven_soc_axil. cosim_en=1 routes ALL IN/OUT to the io bridge
    (core_fetch_decode.svh:226), l1axi_en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
2026-06-09 F4-C1: gated int-0x80 stall (S_SYSCALL_WAIT, +VEN_PS_PROXY) for the PS bridge
    The last gated core change for the PS-assisted SoC. The design workflow adversarially
    verified that the int-0x80 proxy commits gpr[0]<=syscall_eax UNCONDITIONALLY on the
    single S_DECODE edge (core_fetch_decode.svh) — a zero-latency assumption that latches
    GARBAGE when the PS A53 answers microseconds later. (The port-I/O seam needed no such
    change: the core already stalls cleanly in S_IO.)
    Fix, all behind +VEN_PS_PROXY (default + KV260 F2/F3 builds define neither, so they are
    - core.sv: a new S_SYSCALL_WAIT state, a syscall_resp_valid input, and a q_proxy_len
    holding reg.
    - core_fetch_decode.sv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
2026-06-09 #11: x87 transcendental implementation spec (recon-grounded)
    The x87-transcendental-recon workflow pinned the decisive facts against qemu-i386
    8.2.2: F2XM1/FYL2X/FYL2XP1/FPATAN are deterministic softfloat (bit-exact reproducible,
    and hardware-faithful), while FSIN/FCOS/FSINCOS/FPTAN route through HOST glibc
    sin/cos/tan (un-gradeable bit-exact against this oracle). Quake's only transcendental is
    FPATAN (2 sites in glibc atan/atan2), so Group B alone unblocks F4.
    Per the owner's 'hardware-faithful for all' directive: Group B reproduces QEMU's exact
    softfloat (bit-exact gate, no compromise); Group A implements the real P5 CORDIC/poly
    verified via RTL-bit-exact-vs-a-validated-C-model + a docume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
2026-06-09 #11: silicon-faithful spec + dual-mode (QEMU bit-exact gate / silicon ship)
    The pentium-fpu-silicon-recon workflow (Ken Shirriff's die-level constant-ROM extraction
    + Intel docs) settled the target. Owner decisions: (1) accuracy-faithful to the real P5
    silicon (bit-exact-to-silicon is impossible from public data — microcode + Remez coeffs
    undumped, flag-bit unknown, and no silicon oracle exists); (2) keep a QEMU-bit-exact mode
    as a build option so make verify stays a real gate.
    Design: ONE parameterized engine, +VEN_TRSC_SILICON selects the mode. QEMU mode (default)
    reproduces QEMU's softfloat -> bit-exact vs the pinned oracle for F2XM1/FYL2X/FYL2XP1/
    FPATAN (the make-verify gate, covers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
2026-06-09 #11: p5xtrans C reference model + F2XM1 (first verified increment)
    The executable silicon spec (docs/m11-transcendental-spec.md §3.4a) — the oracle the
    silicon-mode RTL must match bit-exact. floatx80<->__float128 conversion (quad holds the
    67-bit silicon constants without extra rounding) + F2XM1 via the documented P5 reduction
    (nearest 1/32 breakpoint -> tiny residual -> 2^x-1 = 2^t*(2^y-1)+(2^t-1)).
    Verified: make validate -> P5XTRANS-F2XM1-OK, worst error 0.500 ulp over an 8193-sample
    sweep of [-1,1], 0 over 1 ulp (well inside the P5's ~1 ulp envelope). Spot checks exact:
    f2xm1(0.5)=0x3ffd_d413cccfe7799211 (sqrt(2)-1), f2xm1(1.0)=1.0, f2xm1(-1.0)=-0.5.
    Next: FPATAN (Quake's only trans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
2026-06-09 #11: p5xtrans FPATAN (Quake's only transcendental) — accuracy-faithful
    atan2(ST1=y, ST0=x) via the silicon c-table arctan reduction: atan(w)=atan(c)+atan(u),
    c=nearest k/32, residual u=(w-c)/(1+wc) in [-1/64,1/64]; full atan2 quadrant handling
    (octant complement for |y|>|x|, sign-based quadrant select). No catastrophic reduction
    error (unlike FSIN near pi), so quad-precision evaluation is within the P5 ~1 ulp envelope.
    Verified: make validate -> P5XTRANS-OK; FPATAN worst error 0.500 ulp over a 263168-sample
    (y,x) grid across all 4 quadrants + the |y|<>|x| boundary, 0 over 1 ulp. Spot checks exact:
    atan2(1,1)=pi/4=0x3ffe_c90fdaa22168c235, atan2(1,0)=pi/2, atan2(-1,-1)=-3pi/4. Since Quake
    u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
2026-06-09 #11: F2XM1 QEMU-mode bit-exact C reference (qref.c) — 187/187 vs qemu-i386
    Port qemu-8.2.2 helper_f2xm1 to a standalone C reference (tools/p5xtrans/qref.c):
    the verbatim 65-entry table + 8 coeffs + ln2 tiny-path, host long double for the
    floatx80 Horner ops (== softfloat floatx80_* precision_x RNE), unsigned __int128
    for the 192-bit reconstruction + normalizeRoundAndPackFloatx80. This is the
    executable definition of the engine's DEFAULT (QEMU) mode — the bit-exact target
    for the make-verify x87 gate (docs/m11 §3.4).
    qref_validate.py closes the loop to the actual oracle: traces an f2xm1 sweep
    through the pinned qemu-i386 (gen_trace --x87) and diffs st0. 187 inputs
    (table breakpoints, mi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
2026-06-09 #11: wire F2XM1 into the core (+VEN_TRANSCENDENTAL) + in-core gate
    Decode D9 F0 -> FX_F2XM1 (gated; default build keeps it d_unknown -> HALT, so
    the 77/77 corpus stays byte-identical). New S_TRSC_BUSY busy-wait state +
    fpu_f2xm1 instance (started in S_FEXEC on FX_F2XM1, x=ST0, rc=fctrl[11:10]),
    result + fstat PE/IE committed via the fp_we_* driver on the engine-done clock
    (mirrors FSQRT's S_FP_BUSY hand-off). Engine gains inexact/invalid outputs so
    the core sets fstat exactly. fxop enum appends FX_F2XM1 (existing encodings
    unchanged); ventium.f adds the engine + +incdir+fpu for its ROM include.
    Gates:
    - verif/trsc/run-f2xm1-core-gate.sh: builds the cosim TB with +VEN_TRANSCENDENTAL
    and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
2026-06-09 #11: FPATAN QEMU-mode bit-exact C reference (qfpatan) — 296/296 x4 RC
    Port qemu-8.2.2 helper_fpatan into qref.c: the 9-entry atan c-table (high+low
    parts), deg-6 odd Horner (fpatan_coeff_0..6), the estimateDiv128To64-based
    x=num/den and z=y/(1+tx) divisions, 256-bit muls (mul128To256), sub192/add192,
    pi/pi2/pi4/3pi4 corners. long double for the floatx80 Horner ops, __int128 for
    the wide-int datapath. The c-table identity atan(x)=atan(t)+atan(z), t=nearest
    n/8, matches the silicon ROM-reduction approach (Quake's ONLY transcendental).
    qref_validate.py gains a 2-operand fpatan probe (fldt y; fldt x; fpatan; fldcw
    per RC) -> traced through the pinned qemu-i386: 296 (y,x) cases across all four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
2026-06-09 #11: qfpatan div-shortcut honors user RC (far-apart-exponent path)
    The arg0_exp-arg1_exp>=80 fast path divides ST1/ST0 under the USER rounding mode
    (it is outside helper_fpatan's force-RNE block); the host long-double division
    now sets fesetround per rc instead of always RNE. Still 296/296 x4 RC bit-exact
    vs qemu-i386 (the prior pass was luck on the single far-apart sweep case).
2026-06-09 #11: wire FPATAN into the core (+VEN_TRANSCENDENTAL) + in-core gate
    Decode D9 F3 -> FX_FPATAN (gated; default build keeps it d_unknown -> HALT).
    FPATAN reads ST1=y/ST0=x and writes ST1 then POPS (result ends in the new ST0),
    exactly like FDIVP ST1,ST0 -> commit = we_sti(idx=1)+we_pop (distinguished from
    F2XM1's in-place we_top in the S_TRSC_BUSY driver). Both transcendental engines
    (fpu_f2xm1, fpu_fpatan) instantiated under +VEN_TRANSCENDENTAL; S_TRSC_BUSY waits
    on / commits whichever q_fxop selected. fxop enum appends FX_FPATAN.
    - verif/trsc/run-fpatan-core-gate.sh: cosim TB +VEN_TRANSCENDENTAL, tx_fpatan
    (16 cases: 4 quadrants + pi/2, -pi/2, pi, +0 passthrough + |y|<>|x| bounda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
2026-06-09 #11: FYL2X/FYL2XP1 QEMU-mode bit-exact C reference — 316/324 x4 RC
    Port qemu helper_fyl2x + helper_fyl2xp1 + the shared helper_fyl2x_common into
    qref.c: arg/(2+arg) division (estimateDiv128To64), deg-9 odd Horner (fyl2x_coeff
    0..9), the int_exp 2^k split + integer-log2 add (fyl2x), the log2_e extra-precision
    tiny path + zero/inf corners (fyl2xp1), exact-power-of-2 fast path. long double
    Horner, __int128 wide datapath. qref_validate.py generalized to validate_rc_2op
    (fpatan/fyl2x/fyl2xp1 share the 2-operand probe). Both ops bit-exact vs qemu-i386
    across all 4 RC -> QREF-FYL2X-QEMU-OK + QREF-FYL2XP1-QEMU-OK. All four Group-B
    transcendentals now have a validated qemu-bit-exact reference.
2026-06-09 #11: FYL2X/FYL2XP1 RTL engine (fpu_fyl2x.sv) — bit-exact, all 4 RC modes
    One iterative engine handles both ops via a mode input (0=FYL2X D9 F1,
    1=FYL2XP1 D9 F9), a verbatim transcription of qemu helper_fyl2x/fyl2xp1 +
    fyl2x_common (the qfyl2x/qfyl2xp1 reference). FSM: classify (int_exp 2^k split +
    exact-power fast path for FYL2X; zero/inf + log2e tiny path for FYL2XP1) -> common
    [t=arg/(2+arg) via estimateDiv128To64 -> t2 -> deg-9 odd Horner -> (C0+accum)*t]
    -> post (int_exp integer-log2 add + multiply by ST1) -> pack. Both write ST1 then
    POP (we_sti(1)+we_pop). The softfloat wide-int kit is factored into the shared
    fpu_trsc_wideint.svh.
    Gate verif/trsc/run-fyl2x-gate.sh: both ops x all 4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
2026-06-09 #11: wire FYL2X/FYL2XP1 into the core (+VEN_TRANSCENDENTAL) + in-core gate
    Decode D9 F1 (FYL2X) + D9 F9 (FYL2XP1) -> gated. Both write ST1 then POP
    (we_sti(1)+we_pop, same as FPATAN; the S_TRSC_BUSY driver now uses that path for
    everything except F2XM1's in-place we_top). fpu_fyl2x instantiated with
    mode=(q_fxop==FX_FYL2XP1); eng_trsc_* muxes F2XM1/FPATAN/FYL2X by q_fxop. fxop
    enum appends FX_FYL2X, FX_FYL2XP1.
    Also added the FYL2XP1 out-of-range invalid check (|ST0| >= 1-sqrt2/2 -> #IA /
    default NaN + IE) to BOTH qref and the engine — qemu raises it before the zero/
    tiny paths; the in-core tx_fyl2xp1 now exercises it (x=0.5 -> NaN, IE matches).
    Gates: verif/trsc/run-fyl2x-core-gate.sh -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
2026-06-09 #11: wire FSIN/FCOS into the core (+VEN_TRANSCENDENTAL) + in-core gate
    Decode D9 FE (FSIN) + D9 FF (FCOS) -> gated. In-place ST0 (we_top, like F2XM1)
    with the x87 C2 flag: |x|>=2^63 -> C2<-1, ST0 unchanged; else result + C2<-0,
    PE<-1. fpu_fsincos instantiated (one engine, sin_o for FSIN / cos_o for FCOS);
    eng_trsc_* mux gains the is_trig branch + eng_trsc_c2.
    VERIFICATION POSTURE (key): qemu computes FSIN/FCOS at DOUBLE precision
    (floatx80->double->sin->floatx80), so it is NOT the silicon oracle and can't
    func-gate these. The shared-poly model (qref, ~1.8 ulp vs quad) is the oracle:
    run-fsincos-core-gate.sh runs tx_fsin/tx_fcos through the core and asserts
    core st0 == the model BIT-EXACT (2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
2026-06-09 #11: wire FSINCOS + FPTAN into the core -> ALL transcendentals complete
    Decode D9 FB (FSINCOS) + D9 F2 (FPTAN) -> gated. Both push: the commit fires
    we_top + we_push (which write the OLD top = new ST1 and the new ST0, composing
    exactly per fpu_top). FSINCOS: ST0<-sin, push cos -> {ST0=cos, ST1=sin}. FPTAN:
    ST0<-tan (=fx_div(sin,cos), matching the model's sin/cos division), push +1.0 ->
    {ST0=1.0, ST1=tan}. C2 out-of-range -> no push, ST0 unchanged. The one
    fpu_fsincos engine serves all four trig ops (sin_o/cos_o reused).
    qref gains qftan (sin/cos via floatx80 div). The in-core gate now covers all 4:
    fsin/fcos 207/207 == model (core-vs-qemu ~1000 ulp: qemu is double-precision),
    fsincos/fptan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
2026-06-09 #6: FP scoreboard stays on fixed P5 latencies (closed as by-design)
    Owner-confirmed (2026-06-09): the fp_ready_cyc / fp_occ scoreboard is driven by
    the FIXED P5 latencies (u_d.fp_lat/fp_occ, the p5trace.c oracle constants), NOT
    the iterative engines' real done. The fast/cycle arm (M4/M5, graded vs the
    p5model golden / mb_* bands) and the slow functional arm (S_FP_BUSY/S_BCD_BUSY/
    S_TRSC_BUSY, where the SRT/BCD/transcendental engines run) are runtime-exclusive;
    the engines' done-latency is an implementation artifact (SRT step count, ~20-clk
    microcode) tuned for bit-exactness/area, not real-P5 timing, so feeding it back
    would diverge from the cycle oracle. Documented the rationale at the score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
2026-06-09 fpga: ZU15EG OOC run — production config routes cleanly (40.6 MHz, 0 overlaps)
    New out-of-context synth->place->route of the VERIFIED narrowb production RTL on
    a Zynq UltraScale+ ZU15EG (xczu15eg-ffvb1156-2LV-e, same -2LV speed grade as the
    KV260 but ~3x the fabric — 341,280 LUTs). apr_run.tcl now takes PART + OUTTAG from
    env so a non-default part writes to its own build dir.
    Result: the same byte-window production config that CANNOT route on the KV260
    (42,392 congestion overlaps, router gives up) ROUTES CLEANLY on the ZU15EG —
    router converges to 0 overlaps / 0 unrouted nets at the same 15 ns target. Same
    93,961 LUTs now at 27.5% util (vs 80.2%). Routed Fmax 40.6 MHz (WNS -9.60 ns),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
2026-06-10 fpga: fix device-view coordinates — uniform tile grid, not per-site X/Y
    The device-view CSV parsed the SITE name's X/Y (SLICE_X#Y# / DSP48E2_X#Y# /
    RAMB36_X#Y#) and plotted those indices directly. But each site TYPE has its own
    independent index grid and the X:Y pitch is non-physical, so the scatter is in a
    distorted space — mild on the small KV260, egregious on the ZU15EG (rendered as a
    tall thin smear, aspect ~1:3.6 vs the true ~1:1.25).
    Switch extraction to the TILE grid (COLUMN, ROW) — one uniform device-wide grid
    across all site types — in apr_run.tcl (future runs) + a standalone
    dump_cells_loc.tcl to re-dump from an existing .dcp. Regenerated the ZU15EG and
    KV260 half-cache de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
2026-06-10 Revert "fpga: fix device-view coordinates — uniform tile grid, not per-site X/Y"
    This reverts commit 828a0972be85ba1b1abcd9974341751dc65691b5.
2026-06-10 fpga: 2-level shared-color square-pixel device views
    Revert left the per-site LOC coordinates (preferred). Rework the renderer:
    - SHARED color scheme: a fixed module->hue map, so the same RTL module is the
    same color across every device view.
    - 2-level coloring: top module = hue; 2nd-level sub-blocks = luminance steps.
    Sub-blocks are prefix-merged (xxxx_* / xxxx_yyyy_*) coarsening until <=6 groups
    per module, ranked BIGGEST-FIRST by cell count (the catch-all 'other' last).
    - Render as a square-pixel raster (imshow, per-tile dominance) instead of an
    overlapping scatter — far more readable.
    - Structured legend: bold module header + cell count, indented sub-block swatches.
    apr_run.tc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
2026-06-10 docs: add L1 cache-size vs performance Sphinx page
    New microarch deep-dive (microarch/l1-cache-performance) characterizing how
    L1 size affects performance in the cycle-accurate model (dual-issue + L1 miss
    timing), measured on the mb_dmiss cache-stress kernel:
    - cache-size sweep 2-128 KB: CPI 2.50 (100% miss) -> 0.53 once the 32 KB
    working set fits (4.7x), knee at the production-relevant point;
    - knee resolved by a fine working-set sweep at fixed 16/32 KB caches, showing
    the 2-way-associativity fingerprint: a linear ramp from 1.0x to 1.5x of
    capacity (not a step), scaling exactly with cache size;
    - honest caveats: cache timing is cycle_mode-only; Dhrystone can't run in
    cycle mode (TL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
2026-06-10 rtl: parameterize L1 size + associativity (default 2-way bit/cycle-exact)
    The L1 I$/D$ geometry is now compile-time configurable — set count AND
    associativity, per-cache or unified — for FPGA area/Fmax and cache design-space
    exploration. Knobs (default-preserving): VEN_L1_SETS / VEN_L1_WAYS (both L1s),
    VEN_IC_SETS/VEN_IC_WAYS + VEN_DC_SETS/VEN_DC_WAYS (per-cache), VEN_CACHE_HALF
    (legacy 64-set). Size = sets x ways x 32 B, powers of two.
    Implementation:
    - icache.sv / dcache_timing.sv: arrays [SETS][WAYS]; way signals widened to
    $clog2(WAYS) bits; the hardwired 1-bit 2-way LRU (victim=~lru) replaced by a
    per-way age-counter true-LRU (age[set][way], 0=MRU..WAYS-1=LRU, victim=max-age)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
2026-06-10 soc: config-selectable PS/RTL peripheral split + C model framework
    The KV260 PL is routing/congestion-bound, so not every peripheral fits. This adds
    a per-peripheral RTL(PL)-vs-PS(A53-software) placement, selected by a config file,
    without weakening any per-record verification guarantee.
    Framework:
    * fpga/periph_split.config + gen_periph_split.py -> +VEN_<DEV>_PS RTL flags +
    a C dispatch table. Default (nothing 'ps') = the all-RTL SoC, byte-identical.
    * ventium_soc PS-bridge seam: a PS-placed device's port range is decoded into
    io_ps_sel and forwarded on the new io_ps_* ports (to ven_soc_axil -> the A53
    on the board; to a C dispatch in tb_soc for verification) instead of a l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
2026-06-10 soc: every slow peripheral configurable RTL/PS + C models + Sphinx docs
    Completes the config-selectable peripheral split: all 6 slow devices now have a
    verified PS C model and are gated out of RTL when PS-placed, so the placement
    actually frees PL fabric. Picks up the 5 C models authored from the RTL modules
    (1:1 behavioural ports, dual-compiled gcc/g++):
    ven_rtc.c (MC146818) ven_i8042.c (8042) ven_acpipm.c (ACPI PM)
    ven_i8272.c (82077 FDC) ven_vgaregs.c (VGA regs) [+ ven_uart16550.c]
    ventium_soc: gate each slow device with `ifndef VEN_<DEV>_PS` (tie its outputs in
    the else arm) so a PS-placed device is not synthesized. tb_soc registers all six
    models in ps_devs. fpga/periph_split.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
2026-06-10 docs: Sphinx theory-of-operation page for the bus/peripheral system
    A deeper companion to the architecture overview + the RTL/PS split page: the
    operational mechanics of the SoC bus-peripheral system —
    * the two buses out of the core (mem_* memory, io_* PMIO) and their protocols
    * a port-I/O transaction step-by-step (S_IO stall -> PMIO decode -> cs ->
    combinational rdata + same-cycle io_ack -> retire)
    * the uniform device interface contract (combinational read value, clocked
    read side-effect) that keeps every ven_* model same-cycle AND bit-exact
    * memory-mapped devices (the VGA framebuffer mem-splice) + the A20 gate
    * interrupt delivery (IRQ aggregation -> 8259A cascade -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
2026-06-11 fpga: +VEN_FP_PIPE2 2-stage FADD commit — half-cache routes 63 MHz on K26 (>60)
    The half-cache KV260 (XCK26/K26) build was Fmax-bound ~52 MHz by the latency-1
    ~80-level FADD deferred-commit cone (fpp -> fx_round_pack -> fpr). A full
    timing-driven P&R sweep (one synth, many directives, over-constrained @15ns) lifts
    the routed Fmax 50.1 -> 52.6 (ExtraNetDelay_high) but no directive / Pblock /
    retiming clears it: the binder is LOGIC DEPTH, not routing, and a latency-1 path
    has one register layer so there is nothing to retime. Synth itself caps 59.4 MHz.
    +VEN_FP_PIPE2 registers the fx_pipe_t carrier at the f_eval_s1/f_eval_s2 boundary,
    so the fast-arm commit is 2 clocks (s1 @ N+1, round-pack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
2026-06-11 fpga: BCD step ÷100 (not two chained ÷10) — half-cache K26 63.0 -> 65.3 MHz
    After +VEN_FP_PIPE2 the FBSTP BCD engine (u_bcd) was the worst path: the per-clock step ran two CHAINED divide-by-10. Compute ONE divide-by-100 and take the two low digits from q%100 (a 7-bit extract): bit-exact + cycle-neutral (make verify-bcd 40k PASS; make verify default 77/77 GREEN; change is inside ven_bcd, only used under +VEN_BCD_ITER -> default untouched).
    Result (half-cache+FP_PIPE2, xck26, 15ns): synth 78.4->80.6 MHz, routed 63.0->65.3 MHz (ExtraNetDelay_high). New worst path = route-bound uopcache fill->front-end cluster (store_bmap->eip/ic_age, placement-variable 45-65; the P0-12 floorplan case). Add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
2026-06-11 core: drop redundant dcache_timing under VEN_L1_AXI + full-SoC impl/viz flow
    RTL (verified): under +VEN_L1_AXI the D-cache TIMING model (dcache_timing, ~4.4k
    cells) is redundant. Its only output dc_lu_hit feeds the modeled D-miss PENALTY
    (`if(!dc_lu_hit) pen += P5_DMISS`) and NEVER the load data -> removing it is
    FUNCTIONALLY INERT. Under the real AXI/DDR bus the penalty is already suppressed
    (core_fastpath.svh `pending_mem_pen <= real_bus ? 0 : pen`) and the slow-path
    penalty is cycle_mode-gated (dead at the board's cycle_mode=0); "mode-2 timing is
    functional-only". The model survived synth only because cfg_cycle_mode is a runtime
    input. Gated `ifndef VEN_L1_AXI` (default build keeps it ->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
2026-06-11 docs: front-end (fetch/translate) pipeline design spec (+VEN_FE_PIPE)
    The structural fix for the ~41 MHz full-SoC wall (the route-bound 55-level eip fetch
    cone: cur_lin -> itlb/dtlb hit_of carry-chain -> xlate_miss -> issue/eip-advance).
    Precise cut: a page-keyed registered micro-TLB (fe_itlb_q/fe_dtlb_q keyed on
    cur_lin[31:12]) so xlate_miss/mem_xlate read the registered translate; intra-page
    fetch reuses it (no stall), only page crossings cost a 1-cycle bubble. Gated
    +VEN_FE_PIPE (default OFF/untouched). Contract: Fmax-only demonstrator (like
    +VEN_UOPCACHE) -- functionally arch-bit-exact vs QEMU + Quake/sys lockstep, cycle
    bands NOT claimed (the +1 mispredict/fill latency is not cycle-neut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
2026-06-11 core: +VEN_FE_PIPE front-end fetch/translate pipeline (page-keyed micro-TLB)
    Breaks the full-SoC ~41 MHz eip-cone binder (cur_lin -> {i,d}tlb hit_of carry-chain
    -> xlate_miss -> issue/eip-advance). Translation is per-4KiB-page, so register the
    {i,d}tlb lookup keyed on cur_lin[31:12] (fe_itlb_q/fe_dtlb_q); xlate_miss + mem_xlate
    read the REGISTERED translate, lifting the combinational hit_of off the issue path.
    A page crossing raises fe_xlate_pend for 1 clock (the only added latency): the FSM
    holds at the existing `if(xlate_miss) else <case>` chokepoint + the bus driver squash,
    while the separate always_ff samples the new page. Coherence: CR3 flush + page-walk
    fill both invalidate fe_*_q. fe_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
2026-06-11 fpu: gate the BCD ÷100 step behind +VEN_BCD_DIV100 (default OFF)
    The ÷100-per-step BCD form (416d403) only helps when u_bcd is the worst path — the
    OOC half-cache+FP_PIPE2 65.3 MHz config. In the full SoC the binder is the eip/TLB
    fetch cone, so the ÷100 gives ~no gain there and just adds a special case. Restore
    the original two-chained-÷10 as the DEFAULT and make ÷100 opt-in (+VEN_BCD_DIV100).
    Both bit-exact (make verify-bcd 40k vectors PASS each); default build + the full-SoC
    impl config now use ÷10×2. README row marked opt-in.
2026-06-11 docs: full-SoC +VEN_FE_PIPE device views + congestion maps + writeup (~50 MHz routed)
    Regenerate all full-SoC device views and congestion maps from the routed
    +VEN_FE_PIPE checkpoint (the build that breaks the eip/TLB cone and routes
    legally at WNS -3.195 ns -> ~50.4 MHz, vs the dcache-only build which fails
    to route at all -- 8766 node overlaps).
    - soc_views.tcl: one-shot extractor (opens the routed dcp once -> cells CSV +
    router congestion report). Fix soc_axil/axi_master attribution -- the real
    instances are u_axil / u_axi, so the old soc_axil/axi_master keywords missed
    them and folded both into core_spine; now the outside-core view shows the PS
    bridge + AXI master correctly. Sam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
2026-06-11 core: ungate CPUID for the SoC (soc_en) + verified qemu-system leaf table (M9.5)
    First F3 boot-ISA gap: real boot firmware (SeaBIOS / DOS) probes CPUID on entry,
    but CPUID was gated off outside the Win95 co-sim and HALTed loudly in the SoC.
    - decode: K_CPUID now fires under (cosim_en || soc_en), not just cosim_en. The
    user-mode corpus has both off, so it stays the loud HALT there -> make verify
    77/77 byte-identical.
    - exec (core_exec.svh): the K_CPUID leaf table branches on soc_en, because
    qemu-system-i386 8.2.2 -cpu pentium returns a DIFFERENT CPUID than the Win95
    co-sim's qemu (leaf-0 max=4 not 1; leaf-1 sig=0x663 not 0x543 -- 0x663 matches
    the SoC reset EDX). The soc_en arm is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
2026-06-11 core: real-mode LES/LDS/LSS/LFS/LGS far-pointer loads — M9.5 boot-ISA gap
    Third F3 boot-ISA gap: the segment-load family loads a GPR + a segment register
    from a m16:16 far pointer and is pervasive in real-mode boot/DOS code (far pointers
    everywhere); all five previously HALTed (d_unknown).
    The 16-bit real-mode case is elegant: a single 4-byte read of the far pointer
    returns {sel, off}, so it's a normal MOV r16,[mem] (GPR <- offset) PLUS one extra
    segment-register write from the SAME read's high half -- no multi-beat needed.
    - decl: +d_seg_load/d_lseg decode signals + q_seg_load/q_lseg latched copies.
    - decode (core.sv): 0xC4/0xC5 (LES/LDS) + 0F B2/B4/B5 (LSS/LFS/LGS) as MOV r16,[mem]
    +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
2026-06-11 core: SGDT / SIDT (0F 01 /0,/1) store GDTR/IDTR — M9.5 boot-ISA gap (final)
    Fourth + final F3 boot-ISA gap: SGDT/SIDT store the 6-byte GDTR/IDTR pseudo-
    descriptor to memory (the reverse of LGDT/LIDT), used by OS/driver/memory-manager
    init; both previously HALTed (only /2 LGDT /3 LIDT were decoded).
    - enum: +SYS_SGDT/SYS_SIDT sysops, +S_SGDT state.
    - decode (core.sv): the 0F 01 arm now also handles /0 SGDT, /1 SIDT (mem form,
    d_mem_write), gated on !paging_on -> else HALT (the 2-beat store doesn't integrate
    page translation; the SoC boot path is real-mode no-paging).
    - routing (core_fetch_decode.svh): SYS_SGDT/SYS_SIDT -> S_SGDT.
    - bus driver: S_SGDT = 2-beat store mirroring S_LGDT's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
2026-06-11 fpga: drop the 60 MHz full-SoC target — 50 MHz is the XCK26 deployable result
    A 60 MHz full-SoC close is not feasible on the small XCK26 (ZU5EV): the OOC core
    ceiling is 65.3 MHz, but the full SoC's L1/AXI + BD interconnect spends the margin
    and the residual wall is diffuse fill->eip routing congestion (~68-71% LUT), not a
    cone P&R or floorplanning can shorten. So pl_clk0 -> 50 MHz (impl_kv260_soc.tcl),
    which the +VEN_FE_PIPE build routes with positive WNS = a clean timing-met board
    image. README + docs/fpga-synthesis.md record the decision. A larger part (ZU15EG)
    would clear 60+; on the K26, 50 MHz is the result we keep.
2026-06-11 core: real-mode IVT INT n / IRET delivery — the F3 BIOS firmware foundation
    INT 10h/13h/16h/21h (the entire BIOS/DOS service mechanism) are real-mode software
    interrupts, but INT n in sys_mode routed ONLY to the protected-mode 8-byte IDT-gate
    path. This adds the real-mode IVT delivery (4-byte {offset,selector} entries).
    - routing (core_fetch_decode.svh) branches on real_mode (sys_mode && !CR0.PE):
    d_int/d_ud2 -> S_RMINT_RD (else S_INT_GATE); d_iret -> S_RMIRET (else S_IRET).
    V86 (PE=1) + protected mode keep the existing 8-byte-gate path UNCHANGED.
    - S_RMINT_RD: read the 4-byte IVT entry {CS,IP} @ idt_base + vec*4.
    - S_RMINT_PUSH: descending 16-bit push FLAGS/CS/IP (SP-=6), load CS (ba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
2026-06-11 soc: fw_cfg framework + INS string-input ungate (SeaBIOS gaps #4-#5)
    Continuing the SeaBIOS POST gap-walk (per-record diff vs qemu-system).
    GAP #4 -- QEMU fw_cfg (ports 0x510 selector / 0x511 data). SeaBIOS detects it via the
    "QEMU" signature then reads small config items. Added a minimal fw_cfg model to
    ventium_soc.sv: a 16-bit selector latch + a data port with a per-item auto-incrementing
    offset (one-shot on the io_req rising edge), and a fwcfg_byte() table. The bare
    `-machine pc -m 32` map (captured via qemu `-trace fw_cfg_*`) is mostly zeros except
    FW_CFG_SIGNATURE="QEMU" (item 0) and FW_CFG_ID=0x03 (item 1); other items (file_dir
    count, numa, max_cpus, acpi/smbios) read back 0 -> the d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
2026-06-12 soc: F3 SeaBIOS POST — RDTSC + PUSH/POP sreg + MOV Sreg,[mem] (338K->1.3M insns)
    Free-run SeaBIOS (qemu bios.bin) on ventium_soc, gap-walking the POST. Three
    real-mode ISA gaps, each mode-gated so the default build stays byte-identical:
    - RDTSC (0F 31): new K_RDTSC + a free-running 64-bit tsc reg (resets 0, +1/clk,
    inert for the corpus). SeaBIOS calibrates the TSC vs PIT ch2 (CPUID leaf-1 EDX
    bit4 advertises it). Free-run-only (TSC value differs vs qemu; SeaBIOS uses the
    delta). Took the POST 338K -> 1.3M instructions.
    - PUSH/POP segment reg (06/0E/16/1E push es/cs/ss/ds; 07/17/1F pop): the 16<->32
    call32 return trampoline pushes CS to build an iret far-return frame. d_push_sreg/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
2026-06-12 core: real-mode HW-IRQ/exception delivery via the IVT + MOV [mem],Sreg
    Real-mode (PE=0) firmware that runs with interrupts enabled (every BIOS/DOS) needs
    hardware IRQs and exceptions delivered through the 4-byte IVT, not the protected-mode
    8-byte gate. start_fault() + arm_db() — through which ALL exception/IRQ/NMI delivery
    funnels (incl. the PIC IRQ at core_fetch_decode.svh:122) — set state<=S_INT_GATE
    unconditionally. In real mode that walked a garbage 'IDT' at idt_base+vec*8, raised
    #NP, and hung. Fix: state <= real_mode ? S_RMINT_RD : S_INT_GATE. S_RMINT_PUSH already
    pushes int_ret_eip (set correctly by every caller) and drops the error code = exact
    real-mode IVT semantics; the S_RMIN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
2026-06-12 core: fix PUSH/POP [mem] operand segment (SS->DS) + WBINVD/INVD NOP — SeaBIOS POST completes
    PUSH/POP [mem] segment bug (pre-existing, root-caused via SeaBIOS's __farcall16):
    the dbase comb forces dseg=SS for every push/pop, which is right for the STACK
    access but WRONG for the memory OPERAND of PUSH r/m (FF /6) and POP r/m (8F) — those
    use the operand's own segment (DS default / override). With DS!=SS (real-mode
    firmware), SeaBIOS's 'push dword [eax+0x20]' read SS:off (=0) instead of DS:off and
    built an iret frame to 0:0. Invisible to the flat user corpus (DS==SS, base 0), so
    make verify stays byte-identical. Fix: opbase uses seg_base[q_seg] for a push memory
    SOURCE read; new stbase use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
2026-06-12 core: 16-bit ModRM EA + FF/3 CALLF + FF/5 JMPF + interruptible HLT; ven_ide multi-MB
    FreeDOS boots its kernel on the RTL. All changes are mode-gated; default
    build stays byte/cycle-identical (make verify 77/77, 23 SoC gates, test386
    EQUIVALENT).
    core.sv
    - 16-bit ModRM effective-address generation for real mode without an a32
    prefix (eff_addr path). Per-rm base select, disp8 sign-extend / disp16,
    BP-relative rm defaults to SS. Replaces the prior disp16-only stub that
    wedged hand-written 16-bit code (SeaBIOS reset, FreeDOS MBR).
    - FF group: /3 far indirect CALL and /5 far indirect JMP through memory
    in real mode, decoded as a 4-byte far-pointer load. Reg form stays
    d_unknown.
    - inte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
2026-06-12 core: 32-bit EBP/ESP SS-segment default + FF/2 width/target/segment — F3 root-cause fix
    FreeDOS now boots past the 6.844M-insn ff-e9 stall (verified +13.2M insns and
    counting). All fixes are invisible in flat gates (segment bases equal), so the
    default build is byte-identical: make verify 77/77 GREEN, ALL-SOC-GATES-OK
    (24 gates incl. the new psoccallfmem), test386 EQUIVALENT.
    THE ROOT CAUSE (found by a five-stage forensic chain, each link witnessed):
    the 32-bit ModRM EA decode set d_seg=DS for every form — the SDM SS-defaults
    (SIB base=ESP any mod; SIB base=EBP mod!=00; non-SIB [EBP+disp] mod 01/10)
    were missing. SeaBIOS's hardware-IRQ extra-stack trampoline (f000:d3e0) runs
    "mov ds,[es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
2026-06-12 core: a16 string semantics (SI/DI/CX low-16) + tb_soc i8042 keystroke injection
    FreeDOS now boots THROUGH the shell: by 60M retires loaded programs issue DOS
    INT 21h syscalls (COMMAND.COM up); make verify 77/77 GREEN and ALL-SOC-GATES-OK
    (24 gates) + test386 EQUIVALENT throughout.
    Root cause of the post-SS-fix stall at n=7.046M: with 16-bit addressing
    (q_cnt16 == latched eff_addr) string instructions must use SI/DI (low 16 bits,
    mod-64K wrap, ESI/EDI[31:16] preserved) and count in CX (low 16). The RTL used
    full 32-bit ESI/EDI/ECX everywhere: FreeDOS SYSINIT's backward relocate-high
    REP MOVSB crossed zero, went 32-bit negative, and every later string EA landed
    64 KiB low — the relocated im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
2026-06-12 soc: PS->core IRQ-injection seam + Linux PS firmware (HID keyboard + VNC) + KV260 REMAP_BASE
    Implements the PLAN.md §6 "PetaLinux as the I/O processor" track per the user
    directive (SSH/VNC/USB HID). The PS side ships as a Kria Ubuntu image (built
    out-of-repo in ventium-refs/kria-ubuntu/, not committed); this commit holds the
    RTL seam, the userspace daemons, and the lock-step register map.
    ven_soc_axil: new R_INTR (0x38) — PS stages {vector, assert-level}; the core's
    1-clock inta strobe auto-clears the level and latches a sticky INTA_SEEN bit
    (W1C), mirroring the 8259's INTA boundary so the PS-side PIC C model can drive
    it; MODE bit 6 now drives soc_en (the core ignores intr without it);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
2026-06-12 docs: regenerate device views from the linux_40 checkpoint + thorough README update
    Device views (same filenames, rendered from the routed 40 MHz linux_40
    checkpoint, 155,015 placed cells): full-SoC hierarchy-colored; the CPU-core+FPU-
    only view (memory/BD grayed; per-block legend: core spine 40,852 cells, I-cache
    22,062, BTB 19,564, FP datapath 16,546, uop-cache 14,757, ...); the outside
    (memory/PS/BD) view; placement-density and router-congestion maps (18 L5-L6
    windows, icache-dominated — the half-cache/IC-BRAM config moved the pressure).
    README (195 -> 301 lines): the 24-gate differential battery; the interactive-
    FreeDOS milestone with the verbatim ver/dir screen (195M retired insns /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
2026-06-12 docs: compact two-panel device view — 'Ventium Full SoC on K26 @ 40MHz'
    render_device_view_split.py renders ONE compact figure from the cells CSV:
    suptitle + two subfigures side by side, each with its own subtitle and legend
    (left: CPU core + FPU colored, memory/BD gray; right: L1/AXI + PS bridge + BD
    colored, core gray). Same hues/sub-block shading/legend conventions as
    render_device_view.py, laid out without the montage dead space.
    README FPGA section now carries only this combined figure (the OOC
    fpga-device-view.png and the separate full-SoC image references removed).
2026-06-12 docs: compact the split device view — content-sized canvas + inset right legend
    Figure width sized to content (two ~4:1 dies + one legend column); the right
    panel's legend sits inside its axes over the grayed-core region, removing the
    fourth column entirely. 2240x1430 (montage) -> 976x925 with no dead bands.
2026-06-12 docs: relax the split device view — slim side legends, no inset overlap
    The inset legend clipped the right die's BD/interconnect cells; both legends
    return to their own (slim) columns. 1050x925 — the compact middle ground.
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2026-06-13 verif+sw: M-A live-board interrupt-injection smoke (mairq + ven_irqtest)
    First hardware exercise of the F3 PS->core interrupt seam on the live KV260.
    PROVEN on silicon: cosim_en IO bridge, soc_en R_INTR injection + INTA handshake,
    and real-mode IVT vectoring (when the IVT is coherent in DDR).
    FOUND (blocker for SeaBIOS/FreeDOS on HW): the core's interrupt-delivery reads
    IVT[vec] uncached from DDR while guest writes sit in the write-back L1D (mode-2
    L1AXI) -> a guest-written IVT entry mis-vectors. Proven by: PS-staged IVT in DDR
    + guest -DNO_IVT_WRITE delivers correctly (handler prints 'T'); guest-written IVT
    mis-jumps. Needs an RTL coherence fix + new bitstream. Full writeup in the
    mairq RE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
2026-06-13 verif: mabench heavy overclock benchmark + live-KV260 sweep result
    Deterministic FP+BCD+integer djb2-checksum kernel that stresses the Fmax-critical
    x87 FADD/FMUL/FSQRT cone + FBSTP BCD engine + integer mul/div. Sweep on the live
    XCK26: correct CK 40->71.4 MHz, corrupts at 76.9 MHz (~1.79x the 40 MHz routed
    sign-off; silicon runs well past worst-case STA). The trivial psocfw smoke is
    insensitive (passes to 83+ MHz).
    ISA gaps found on HW at 40 MHz (NOT overclock-induced; psocfw passes as control):
    FWAIT 0x9B hangs (use FNINIT), MOV-moffs A0-A3 undecoded (use ModRM), CALL/RET
    suspect. Bare x87 arith + iterative DIV + 32-bit ops all verified working.
    probe.S/finittest.S are the instruction-sup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
2026-06-13 docs: README — live-silicon first light + overclock numbers (71.4 MHz)
    The 40 MHz KV260 image now runs on real XCK26: first light (psocfw banner,
    IDENT=VTMC) + an overclock characterization (mabench/mabench2): correct to
    71.4 MHz, marginal/flaky at 76.9 MHz (~1.79x the 40 MHz routed sign-off; dual-issue
    U/V is the most sensitive stressor). Plus the live-board ISA/coherence findings
    (FWAIT 0x9B hangs, MOV-moffs undecoded, IVT/L1 coherence blocks SeaBIOS/FreeDOS on
    HW) stated honestly.
2026-06-13 verif: calltest — CALL/RET diagnostic (the FreeDOS-on-HW blocker)
    Near CALL/RET probe (call sub -> 'A' -> ret, expect SAAAZ(A)Y). Loops forever on
    'A' on the deployed KV260 bitstream (RET mis-returns) but completes correctly in
    flat-mem sim with the same fetch/cache defines, and is clock-independent (fails at
    10 MHz). Bounds the blocker to CALL/RET control-flow under the deployed
    VEN_L1_AXI+VEN_KV260_SOC integration (REMAP=0x40000000) — a config no sim covers
    with real-mode code. Full analysis in the hw-irq-ivt-coherence memo.
2026-06-13 verif+fpga+sw: P1/P2 infra — deployed-config sim repro, respin bisect knobs, PIT model
    - tb_main: --cosim flag (plain -bios port-I/O co-sim, prints COM1) + AXI REMAP
    offset (VEN_KV260_SOC) + AXI_RLAT/WLAT latency knobs; new make targets
    l1axi_kv / l1axi_kv_full (the EXACT deployed define set). FINDING: calltest
    PASSES in sim in the full deployed config (single+dual issue, +AXI latency) —
    the CALL/RET failure is a synthesis-vs-sim divergence, hardware-only.
    - impl_kv260_soc.tcl: BTB_PIPE/UOPCACHE fetch-feature defines now env-controllable
    (default on = linux_40) to bisect the synth bug via respins.
    - ven_pit.c: 8254 PIT C model (port of ven_pit.sv; wall-clock elapsed-tick d,
    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
2026-06-13 fix(l1axi): byte-lane-align ven_axi_master sub-word writes — the FreeDOS/CALL-RET blocker
    ROOT CAUSE of the on-silicon CALL/RET, IVT, and stack-coherence failures: the core's
    mem port is byte-addressed (byte at m_addr in LANE 0 of m_wdata/m_wstrb, symmetric
    with the read window), but ven_axi_master forwarded the RAW byte address with data/
    strobes VERBATIM. A 32-bit AXI write places byte lane b at the word-aligned addr+b,
    so a sub-word write to a non-word-aligned byte address (e.g. a 16-bit stack push to
    0x..FE) wrote the WRONG DDR bytes on real silicon — clobbering an adjacent half-word.
    CALL's return-addr push then read back wrong on RET; ditto IVT writes vs INT delivery.
    FIX: word-al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
2026-06-13 fpga: L1/AXI cross-word store split (2-beat) — fixes SeaBIOS POST hang on KV260
    Root-cause of the FreeDOS-never-boots hang on the deployed bitstream: a store
    whose bytes straddle a 32-bit word (an UNALIGNED 16/32-bit store) was issued to
    DDR as a single AXI beat by ven_axi_master, dropping the bytes that spilled past
    lane 3 -> silent DDR corruption. SeaBIOS POST does such stores; the corruption
    cascaded into the memset(0xc0000) option-ROM-clear infinite loop (core spun at
    ~5M+ retired, never reaching the boot sector). The byte-addressed sim BFM masked
    it; only the deployed config (L1AXI + KV260 4G-alias REMAP, faithful word-aligned
    DDR BFM) reproduces it — the no_xword_wr SVA fires at re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
2026-06-13 verif: faithful L1AXI FreeDOS repro (tb_main --dos) + ven_soc_app I/O log
    After the cross-word store fix, SeaBIOS POST on the KV260 advances 6x further but
    hits a SECOND, distinct freeze at retire ~1.21M. The board exposes no PC, so add a
    faithful in-sim repro to pinpoint it:
    make l1axi_kv_dos -> tb_ventium --dos --l1-axi --image bios.bin --disk fd_hdd.img
    * links the SAME PS peripheral C models ven_soc_app drives (PIT/RTC/IDE/PIC/
    i8042/VGA) into tb_main's io_* bridge (dos_model_of routing, COM1 LSR/RBR),
    * a cycle-paced IRQ0 pump drives the core's intr/inta_vector seam + intacks the
    PIC on inta (VEN_IRQ0_PERIOD tunable; cycle-paced so a STI;HLT wait wakes).
    VEN_DOS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
2026-06-13 core: VEN_DBG_CORE — on-die debug/trace/perf + single-step/breakpoint
    A comprehensive, opt-in (VEN_DBG_CORE) core-debug infrastructure, built because
    the FreeDOS bring-up proved the board exposed no PC and a silent stall was
    indistinguishable from a clean halt — a faithful sim had to be built just to see
    the FSM state + the derail PC. This makes that a one-line readout.
    OFF by default: every tap is ifdef-VEN_DBG_CORE-gated, and the one unconditional
    FSM injection uses a wire dbg_block_issue tied 0 (dead arm). make verify stays
    77/77 byte/cycle-identical; the FPGA timing close is unchanged.
    Features (ven_soc_axil 0x80+ window; C mirror in ven_soc_regs.h):
    * Committed-state taps: last-r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
2026-06-13 l1d: cross-cache-line store fix — the FreeDOS interrupt-delivery derail
    ROOT CAUSE of the FreeDOS-on-KV260 boot derail (the long-standing F3/P6
    blocker). A 4-byte store whose bytes straddle the 32-byte L1 line end spills
    its HIGH bytes into the NEXT line. ven_l1d forwards the full store to the
    backing (ven_axi_master splits it into per-word AXI beats) and INVALIDATES the
    cached line(s) so a re-read refills correct data. But the invalidate fired only
    when the ADDRESSED line was resident (hit). When the addressed line MISSED but
    the NEXT line was RESIDENT (hit==0, hit_n==1), that next line's STALE copy was
    never invalidated, and a later cross-line read served the stale HIGH bytes.
    On the de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
2026-06-14 core: fix IC_BRAM ic_byte way-stale read (F4 board Quake __init_libc freeze)
    ic_byte's VEN_IC_BRAM line-buffer select matched on SET only, while ic_fetch_ready
    gates issue on (set AND way). After an AXI fill re-allocates the fetched line into
    the other 2-way victim, rdA_set_q still matches addr's set for ~1 cycle while
    rdA_way_q / ic_rd_lineA still hold the OLD way's bytes — so ic_byte returned a
    stale wrong-way opcode byte, the fast path decoded a len-1 op, next-EIP advanced by
    1 instead of 2, and the core derailed (PC lands mid-instruction -> jmp into garbage
    -> S_HALT). Only manifests over L1AXI + IC_BRAM: the multi-cycle AXI fill opens the
    way-stale window the immediate-response (direc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
2026-06-14 l1d: write-allocate fix — the F4 board free-run __init_libc derail (posted-write incoherency)
    Root-caused + sim-validated the userspace-Quake free-run wedge on KV260 silicon.
    ven_l1d had NO write-allocate: a within-line write MISS went write-through only.
    On silicon the PL->smartconnect->DDR write is POSTED (BVALID precedes global
    visibility), so a later read MISS of the same line filled from not-yet-committed
    DRAM -> stale data. __init_libc's rep stos zeroes an uncached buffer then reads it
    back -> garbage -> wrong branch -> 0-syscall derail -> memcpy ret -> S_HALT at 37.9M.
    Single-step drained the post between insns; the coherent TB hid it.
    - rtl/mem/ven_l1d.sv: within-line write MISS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
2026-06-14 emu: VEN_QUAKE_DATA pak-path redirect + board-retest findings (L1C_BUG §10)
    - syscall_emu.cpp open(): redirect guest /opt/quake/id1/.. -> $VEN_QUAKE_DATA/id1/..
    (the image was produced with -basedir /opt/quake, absent on host/board). With it the
    sim loads pak0.pak (339 files), passes palette.lmp, reaches 'Initializing palettes...'
    cleanly (63 syscalls) — userspace Quake is now FULLY CORRECT IN SIM.
    - L1C_BUG §10: write-allocate respin (proxywa) deployed but did NOT fix the board
    (identical 0-syscall derail). The AXI_WPOST repro was same-symptom-different-mechanism.
    Board bug localized: free-run-only read-path bug in the auxv region (n~105..1454),
    correct through rep stos + en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
2026-06-14 L1C_BUG §10: board bug = free-run L1 read-staleness at argv[0] strrchr; flush workaround failed
    - bp bisection: free-run reaches the argv[0]-basename scan @0x08098630-b (executes the
    slash-store), diverges scanning argv[0] / in __init_tls -> 0 syscalls. == the summary's
    'strrchr staleness' (single-step+flush reads it right; free-run reads stale).
    - periodic CTRL.FLUSH_REQ workaround (VEN_QUAKE_FLUSH_N) FAILED: retire=0 for all N — the
    wr(CTRL,CORE_RUN|FLUSH_REQ) write breaks the running core on silicon (untested path; 0
    syscalls means the syscall-flush @577 never ran either). Knob reverted.
    - cheap PS tests exhausted; next = on-die retire-count breakpoint + GPR tap respin (the PC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
2026-06-14 verif(l1axi): directed xline-READ test (cold next-line fill + both-resident hit)
    Adds the argv[0]-strrchr access pattern (4-byte read crossing the 32B line end, next
    line cold) to the L1AXI gate — previously only cross-line STORES were covered. PASSES:
    the cross-line read assembles {L+1,L} correctly (cold-fill and hit paths). This RULES
    OUT a functional xline-read bug -> the board's free-run argv[0] read-staleness is a
    SILICON-TIMING effect (the 512->32 async-LUTRAM read mux), invisible to cycle-accurate
    Verilator. Confirms the next step must observe silicon (on-die tap) or relax the L1
    read-path timing (pipeline/register the wide async read).
2026-06-14 L1C_BUG §11: ROOT CAUSE CONFIRMED — silicon-timing on ven_l1d high-fanout async read
    Two no-respin proofs: (1) directed xline-READ gate PASSES -> read logic is correct (not
    a functional bug); (2) proxywa WNS path = eip_reg -> u_l1d/dc_line async-read -> gpr_reg,
    49 logic levels, dc_line read-data nets fanout 1152-1460 (unreplicable RAMD64E LUTRAM
    outputs). The wide ASYNC distributed-RAM read + 512->32 mux is silicon-marginal at 40MHz
    ('met' in STA but trips free-run on the deep argv[0] byte-scan; single-step/Verilator hide
    it). FIX = register/pipeline the L1 read (1-cycle sync) or cut fanout (smaller/direct-mapped
    L1), then respin. It's a timing-closure fix, not a logic fix.
2026-06-14 L1C_BUG §12: fix attempts — pipelined read had a data regression; lower-clock breaks AXI
    (a) lower PL clock (30/25/20MHz) -> retire=0 (breaks the 40MHz-tuned PL<->PS-DDR AXI CDC);
    not a usable workaround. (b) registered 1-cycle ven_l1d read passes all l1d/l1axi gates +
    make verify 77/77 but regressed sim Quake to gs=0x0003 (stale user_desc read) — a corner
    case in the hand-rolled rd_armed FSM the gates miss; reverted (write-allocate kept). NEXT:
    re-implement with a directed gate reproducing the gs=0x0003 sequence, or a clean sync-RAM
    inference; the read-pipeline DIRECTION (break the 49-level high-fanout path) is correct.
2026-06-14 fpga: fix ven_l1d pipelined-read stale-data — address-matched 1-cycle ack
    The board's userspace-Quake derail root cause: ven_l1d's combinational async
    read of dc_line (256-bit distributed RAM, fanout >1100, ~49 logic levels) does
    not close 40 MHz (proxywa build WNS clawed from -2.828 to +0.047 via physopt)
    and GLITCHES on silicon. Pipeline the read (register rd_window -> rd_window_q)
    to break that path.
    The decoupled 1-cycle ack (rd_armed) raced the core's address turnaround: the
    core presents a NEW c_addr while a prior read's ack is still asserted, and the
    two can be in different cache SETS, so the core consumed a stale window. A
    per-cycle [L1] trace caught c1's data (set 0x5E) being ack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
2026-06-14 docs+tools: auto-generated x86 opcode map (CI drift-guarded) + qemu snapshot + FWAIT decode
    Systematic ISA-coverage infrastructure (replaces whack-a-mole opcode debugging):
    * tools/opcode_map/gen_opcode_map.py + coverage_data.json: renders the two 16x16
    x86 opcode grids (primary + 0F, each cell = mnemonic + Ventium functional-decoder
    status) into docs/sphinx/isa/opcode-map.rst. --verify-rtl guards against drift via
    a decode-structure fingerprint (every 8'hXX: case label + d_fxop/d_kind/d_unknown
    token) + the FX_* enum; --check fails on a stale RST. Wired into docs.yml so the
    map regenerates + re-verifies on every Sphinx build, and the workflow now also
    triggers on rtl/core/core.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
2026-06-14 soc: fix KV260 carveout REMAP-fold aliasing + zero anon memory (board Quake)
    Two PS-side correctness fixes uncovered once the L1 pipelined-read fix let
    userspace Quake run 33.66M instructions on silicon (prior bitstreams died at
    0 syscalls, never reaching this):
    * syscall_emu mmap arena 0x50000000 -> 0x01000000. The KV260 L1AXI REMAP folds
    guest addresses into a 256MB DDR carveout by (addr & 0x0FFFFFFF). 0x50000000
    folds to 0x00000000, ALIASING the folded stack (0x40c34840 -> 0x00c34840) and
    the low carveout — so any anon mmap (e.g. a malloc->mmap Hunk) and the stack
    overwrite each other. 0x01000000 folds to itself, in the large free carveout
    gap (folded stack-top ~0x00c35000 ..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
2026-06-15 docs: add Debug Instrumentation page + simplify page titles
    New docs/sphinx/debug-instrumentation.rst catalogs every debug/bring-up
    feature: the on-die VEN_DBG_CORE unit (full 0x80-0xE8 AXI-Lite register map:
    committed-state taps, PC ring, freeze detector, perf counters, single-step,
    HW breakpoint, AXI read-beat trace), the diagnostic modes (golden/L1-useless,
    cycle, flush, clock-lower via venclk.sh), the ven_soc_app daemon flags
    (--bp/--steps/--peek/--poke/--flush-each-step/--cycle/--golden), the vpeek
    carveout reader, ven_systrace, the Verilator tb features (--dbg-step/--dbg-bp/
    --dump-fb/AXI_RGAP/+verilator+rand+reset), and a fault-classification playbook.
    Added to the index toctree. Also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
2026-06-15 docs: redraw opcode map as an interactive color-coded matrix
    Replace the two ASCII code-block grids in the opcode-map reference with
    HTML 16x16 matrices emitted via Sphinx '.. raw:: html'. Each cell is
    color-coded by decode status and shows a hover/focus/click-to-pin tooltip
    with the full mnemonic, status, decode detail, and RTL evidence.
    All inline CSS/JS — no new Sphinx extension or theme, so the dependency-free
    alabaster build stays reproducible. Legend, coverage summary, and detail
    appendix are kept for searchability and as a no-JS fallback.
2026-06-16 core: fix Vivado icache BRAM decloning (board fetch corruption) + new ISA opcodes
    icache (VEN_IC_BRAM): the two replicated line stores ic_line_a/ic_line_b were
    byte-identical, so Vivado proved them equal, eliminated one array's write, and
    decloned the survivor into a single 64-bit RAMB fanned across all four lanes of
    rd_lineA -> the upper 32-bit word of a fetch granule read back the lower word's
    bytes (board-only; invisible to 2-state Verilator). Root-caused via gate-level
    sim of the synthesized netlist. Fix (Method B): store ic_line_b with reversed
    word order and un-reverse combinationally after the registered read, so the two
    arrays are no longer provably equal -> Vivado infers a correct 8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
2026-06-16 mem: add standalone UltraRAM L2 cache controller (ven_l2) + gates
    Write-back, write-allocate, 8-way L2 sized to fill all 64 URAM blocks on
    xck26 (2 MiB = 256-bit line x 65536 lines = 4 URAM-wide x 16-deep). Drop-in
    for the ven_l1d <-> ven_axi_master backing-port seam (u_* slave / d_* master);
    single-outstanding, no MSHR. Hides DDR latency via capacity, fast on-chip
    hits, forward-during-fill, and write-back absorption of the L1 write-through
    store stream. NOT yet wired to the core (standalone, per request).
    Verification (Verilator, all green with --assert):
    - run-l2-gate.sh: hit=0 DDR reads, write-back=0 DDR writes, byte-correct
    dirty eviction, cross-line straddle, single-outstanding, dirt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
2026-06-16 icache: fix board-only Quake fetch corruption — BRAM cross-port read-during-write collision
    The F4 board Quake freeze (retire=16,930,793, wild jump to near-NULL 0x453bf) was an
    icache RAMB36 cross-port read-during-write collision: the fetch reads the exact
    {set,way} a fill is writing in the same cycle (~494K times over 17M insns, 99.9% on
    resident/consumed lines). Real UltraScale SDP BRAM returns INVALID data on a same-
    address cross-port collision; 2-state Verilator models a clean READ_FIRST (NBA), so the
    bug is invisible to sim — silicon-only, clock-independent, with DDR .text proven pristine
    (fetch-READ corruption, not a store).
    Fix: the icache registers a per-buffer collide flag (re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
2026-06-16 fpu: implement FPREM (D9 F8) + enable FPATAN/uop-cache for the Quake render path
    Quake's render path needs two x87 ops the deployed build lacked (board-confirmed: it
    ran 2.4B insns past the icache-fix then loud-HALTed on the first FPATAN at 0x809aaf5):
    1. FPATAN (VEN_TRANSCENDENTAL): the engine (fpu_fpatan) already existed but the whole
    transcendental unit was OFF in the build. Add the VEN_TRANSCENDENTAL gate to the impl
    tcl (default ON). FPATAN is Quake's ONLY transcendental.
    2. FPREM (D9 F8, VEN_FPREM): was DEFERRED (decoded -> d_unknown loud-HALT). New
    rtl/fpu/fpu_fprem.sv — a bit-serial EXACT partial-remainder engine (restoring division
    of the aligned 64-bit mantissas) pr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
2026-06-17 fpu/fpga: make the transcendental unit Vivado-synthesizable (was Verilator-only)
    VEN_TRANSCENDENTAL was never put through Vivado synth (always off in bitstreams), so
    enabling it for the Quake respin surfaced build issues that Verilator silently accepts:
    1. Part-select on a function-call result (Synth 8-12513, illegal IEEE-1800) in every
    transcendental engine + the core FPTAN commit: fx_mul(...)[79:0] etc. Add a fx80()
    helper (return v[79:0]) and rewrite as the nested call fx80(fx_mul(...)). Pure wiring,
    bit-identical.
    2. The engine files (fpu_fpatan/fyl2x/fsincos/f2xm1/fprem) were not in the impl tcl
    svfiles list, and rtl/fpu was not an include dir (fpu_f2xm1_rom.svh). Add both.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
2026-06-17 soc/ps: FPATAN PS-trap register window + A53 atan2 handler (0xEC-0xFC)
    Completes the F4 PS-trap FPATAN seam (core side landed in 6028ab3): the board
    path from the core's S_FPTRAP_WAIT stall to the A53 that computes atan2.
    RTL (ven_soc_axil): a 5-word indexed FPTRAP window in the only free reg space
    left with the DBG window (0xEC-0xFC). FPT_STAT[0]=pending/[3:1]=op; FPT_IDX/DATA
    read the 6 floatx80 operand words (0-2=ST0, 3-5=ST1); FPT_IDX/RES write the 3
    result words; FPT_CTRL[0] W1P commits -> fptrap_resp_valid (mirrors the int-0x80
    proxy commit discipline). ventium_kv260_core wires the seam internally between
    u_axil and u_core (ft_* nets) — no top.v/BD change (stays inside the core).
    P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
2026-06-17 sim: full-model save/restore + FreeDOS-boot tooling
    FreeDOS now boots to a working command environment on the real KV260
    silicon (and in the faithful l1axi_kv_dos sim): SeaBIOS -> FreeDOS
    (DF_FIXED-patched kernel) -> COMMAND.COM -> AUTOEXEC -> runs a .COM.
    The long-suspected "wedge #2" was a misdiagnosis: COMMAND.COM idling at
    the C:\> prompt (INT 16h keyboard poll + timer ticks), not a CPU bug.
    Adds, on the --savable l1axi_kv_dos build:
    - Full-model checkpoint: --save-state <prefix> --save-at-cycle N
    [--save-exit] / --restore-state <prefix>. Captures the entire RTL
    model (VerilatedSave .vlt) + MemModel + all 6 PS peripheral models +
    tb scalars (.aux). Bit-identical resume verified (r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
2026-06-18 f4a: root-cause high-cluster EXEC fail = real-mode stack no 16-bit wrap
    Diagnosed the FreeDOS 'unknown command given to driver' (kernel E_CMD from
    Genblkdev) that blocks DOS Quake. Proven via instrumented ven_ide that the
    board IDE trace == Verilator sim trace exactly (no real aborts, no high-LBA
    read) -> not IDE/go32, not silicon: a deterministic CPU bug. Traced (new
    LBA-armed per-commit trace) to the DOS reentrant stack trampoline switching to
    SP=0; confirmed in RTL that core stack addr/ESP use full 32-bit ESP with no
    16-bit wrap, so a push at SP=0 lands at ss_base-2 instead of ss_base+0xFFFE,
    corrupting kernel data -> bad block request -> E_CMD.
    Tooling (default-off, byte-identical):
    - v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
2026-06-18 R3: extract BCD/ASCII-adjust datapath to core/uv_common.sv
    Behaviour-preserving (make verify fingerprint byte-identical: 84 PASS / 1 FAIL
    tx_fprem-WIP, identical RTL cycle counts; lint clean). First block of the
    shared U/V exec building-blocks module; first step of the core.sv
    true-module modularization (docs/rtl-refactor-plan.md R3).
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2026-06-18 R3: move U->V EFLAGS forwarding into core/uv_common.sv
    Behaviour-preserving (verify fingerprint byte-identical; lint clean). uv_common
    now holds both shared exec building blocks: the BCD/ASCII-adjust datapath and
    the U->V flag-forwarding that resolves a paired V branch (v_br_taken_eff).
2026-06-18 R3: extract slow-path instruction decoder to core/decode_stages.sv
    Behaviour-preserving (verify fingerprint byte-identical: 84 PASS / 1 WIP-FAIL
    tx_fprem / identical RTL cycle counts; lint clean). Moves the prefix machine,
    eff_opsize/eff_addr, sreg_idx, and the ~1400-line combinational decoder VERBATIM
    into a true module decode_stages (115 ports: ibuf/gpr/eflags/mode-state in,
    d_*/leaked-intermediate out). The sysop_e typedef is promoted to $unit scope
    (top of core.sv, before the module) so the d_sysop output port type is visible
    to the new module. core.sv 6409 -> 5110 lines.
2026-06-18 R3: extract x87 FP write-driver to core/fpu_writeback.sv + document R3
    Behaviour-preserving (verify fingerprint byte-identical; lint clean incl. the
    full +VEN_FP_* superset). Relocates the ~674-line combinational fp_we_* driver
    (the fpu_top R2 pattern glue) VERBATIM into a true module fpu_writeback (130
    ports). state_e is promoted to $unit scope (next to sysop_e) so the module's
    state input + case(state) resolve. core.sv 5110 -> 4606.
    docs/rtl-refactor-plan.md: records the R3 split (uv_common/u_pipe/v_pipe/
    decode_stages/fpu_writeback), and why microcode/SMM/regfile stay spine-resident
    (single-writer FSM owns all architectural state).
2026-06-18 R3: extract GPR file to core/regfile.sv (registered module, clean)
    Behaviour-preserving (verify fingerprint byte-identical; lint clean). regfile is
    a plain REGISTERED register file: storage + synchronous dual-boot reset +
    per-register gpr_we[i]/gpr_wd[i] write lines + gpr_o[] readout, NO instruction
    logic. A single combinational writeback driver (core_gpr_wb.svh, included once)
    holds ONLY the gpr-write decisions moved out of the FSM (non-gpr logic stripped);
    all gpr reads -> gpr_o. No per-arm duplication (727-line gpr-only driver vs the
    earlier reverted 3575-line full-FSM clone). core.sv 4606 -> 4645.
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2026-06-18 core: mask the real-mode stack pointer to 16 bits (SP wrap fix)
    Root cause of the F4A 'unknown command given to driver' blocker: in real mode
    the stack pointer is 16 bits, but the core computed every stack address and ESP
    writeback from the full 32-bit ESP with no 16-bit wrap. At SP=0 a push computed
    ss_base+0xFFFFFFFE = ss_base-2 instead of ss_base+0xFFFE (top of the 64K SS
    segment), so the DOS reentrant interrupt-stack trampoline (which switches to
    SP=0) scribbled below its stack -> corrupted a kernel block-request field ->
    Genblkdev returned E_CMD. RTL-confirmed in core_bus_driver.svh + the centralized
    gpr writeback.
    Fix: stk16() masks a stack address offset to 16 bits when real_mode; on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
2026-06-18 f4a: re-diagnose the high-cluster EXEC blocker + sim debug tooling
    The committed real-mode SP-wrap fix (f826e2c) is a real bug + verified working
    (trampoline now wraps SP to 0xfffe) + make-verify byte-identical, BUT it is NOT
    the F4A blocker (red herring). With it in, a HIGH-cluster .COM still fails to
    EXEC while a low-cluster one works. Re-traced (sentinel-armed) to the kernel's
    LBA_Transfer_/LBA_to_CHS_ disk-transfer code (runtime cs=10ef:0x108c): for a
    large sector (~36000) it spins ~1871x scanning bx, never issues INT 13h AH=02,
    then reset/retries forever. Cluster/sector-magnitude-dependent, sim-reproducible.
    Sim debug tooling (tb_main, default-off / guarded => make verify byte-identica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
2026-06-18 core: fix XCHG of two byte-halves of one register (F4A high-cluster EXEC)
    XCHG r/m8,r8 where dst and src are byte-halves of the SAME 16-bit register
    (xchg ch,cl / ah,al / ...) only swapped one half. The K_XCHG writeback did two
    independent reg_merge(gpr_o,...) writes; with dst==src reg the second started
    from the ORIGINAL value, discarding the first byte-write. `xchg ch,cl` on
    cx=0x0025 gave 0x2525 (ch<-cl only) instead of 0x2500.
    This was the F4A high-cluster-EXEC blocker. FreeDOS's INT 13h cylinder-pack uses
    `xchg ch,cl; ror cl; ror cl`, so every cylinder>=1 disk read got a corrupted
    cylinder (37->293) -> off-disk LBA -> SeaBIOS rejects -> infinite reset/retry.
    Cylinder 0 (low byte 0x00)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
2026-06-19 verif/cov: Verilator code-coverage + ISA-execution suite
    Add a coverage suite that drives the full ISA assembly corpus through a
    --coverage build of the core, measures RTL line/toggle coverage and
    correctness, and reports unimplemented instructions from the RETIRED
    instruction stream (retired == actually executed). Four complementary
    lanes (Verilator only instruments instantiated modules):
    ISA (run-cov.sh) user-mode corpus -> core coverage + ISA report +
    per-test func-diff vs the QEMU golden
    SYS (run-sys-cov.sh) bare-metal --system images -> privileged paths
    (int/IRET/seg/TSS/SMM/paging/TLB)
    MEM (run-mem-cov.sh) ven_l1d / ven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
2026-06-19 verif/cov: assembly-test coverage loop -> CORE line 80.6% -> 85.3%
    Drive core ISA coverage up by writing targeted assembly tests, iterating
    against the uncovered-line report (new verif/cov/uncovered.py) until the
    reachable ceiling. Three rounds:
    New PASSing tests (verif/tests, also strengthen `make verify`):
    t_mulw 8/16-bit MUL/IMUL (q_w==1/2 width arms)
    t_divw 8/16-bit DIV/IDIV
    t_sgdt SGDT/SIDT to memory
    t_farjmp near JMP rel32 / Jcc rel32 (long forms)
    t_testnn TEST AL,imm8 + TEST/NOT/NEG byte+word
    t_alu8 8-bit ALU r8,r/m8 (d=1 direction)
    t_pushseg PUSH ES/CS/SS/DS
    tx_regform x87 register-form ops + FLD constants + FRNDINT/FSCALE/FCOM
    tx_regform2 FCOMP/FU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
2026-06-19 F4A: env-replay differential vindicates the CPU + unblocks the VGA
    The qemu-system environment-replay differential (--dos --lockstep, tb_main.cpp)
    feeds the core qemu's exact fw_cfg/peripheral inputs and proves the CPU is
    byte-correct through 2.28M POST instructions vs qemu-system-i386. The DOS-Quake
    abort (edx=0x7cf overflow) is therefore an ENVIRONMENT effect, not a CPU bug:
    every divergence found was a tb-model gap (fw_cfg DMA, CPUID model, VGA chipset
    register), never an RTL bug.
    - 7 PM-segmentation fixes: 16-bit ENTER, SMSW, PM far CALL routing, LDT support
    (ldt_base/limit + LLDT + TI-bit), task-switch LDTR (S_TSW_LDT), S_SEGLD
    LDT-limit, PM memory-source MOV Sreg.
    - ven_vgaregs: S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
2026-06-20 verif/icache_gls: OOC-synth + GLS funcsim harness for the residual fetch corruption
    OOC-synth icache (VEN_IC_BRAM+VEN_CACHE_HALF, RAMB36) via a scalar-port wrapper (the raw 2D/3D array outputs flatten/optimize in funcsim), write_verilog -mode funcsim, then a fill-all/read-all + concurrent cross-port TB. Models the real SDP-BRAM read/write/collision the board hits but Verilator can't, to localize the residual READ corruption (board jae-operand corruption, set 0x56) beyond the fixed declone/collision.
2026-06-20 verif/icache_gls: GLS funcsim VALIDATED — icache-alone is clean for the residual
    The synthesized RAMB36 icache passes fill-all/read-all + concurrent read-way0/fill-way1 (only a set-0 startup-fill TB artifact). So the residual board fetch corruption is NOT icache-internal -> per the documented analysis it's the L1/AXI FILL data path (ven_l1d/ven_axi_master) delivering wrong fill_data, OR needs the board's exact {set,way,timing} trigger. 2-clk registered-read settle.
2026-06-20 verif/icache_gls: collide-guard edge test (PHASE C) — icache module DEFINITIVELY clean
    PHASE C: same-{set,way} read+fill same cycle -> 0 guard-misses (rd_collA correctly flags every collision). With PHASE A/B clean (modulo set-0 startup artifact), the synthesized icache module's read + collide-guard are correct. => the residual board fetch corruption is unambiguously in the SPINE (core.sv ic_byte / buffer-select / registered-address path), which the icache-only GLS cannot reach. Next: GLS the spine fetch path, or on-die spine-fetch-state capture via a DBG bitstream (buildable from the pre-FP-bloat state which fits).
2026-06-20 fpu: prune the dead combinational fx_sqrt under VEN_SRT_ITER (LUT reclaim)
    Under VEN_SRT_ITER the iterative engine handles every real sqrt (incl. denormals
    via fp_sqrt_elig), so fx_sqrt is only ever reached for +0/-0/+Inf, where
    sqrt(x)==x exactly. Return the input directly there so the 256-bit combinational
    restoring fx_sqrt -- and its inlined (post-6cf8119, denormal/gradual-under-over-
    flow) fx_round_pack_f cone -- become uncalled and dead-code-eliminated. The
    !VEN_SRT_ITER path keeps the real fx_sqrt.
    Bit-exact: fpu87 sqrt thorough under VEN_SRT_ITER 5/5 (specials exact-by-
    identity); make verify 97/0 (!VEN_SRT_ITER unchanged). First step of the spine
    fx_* dedup to reclaim the FP-correct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
2026-06-20 docs: FPU status snapshot (Jun 20)
    Summarizes the unified FDIV engine (div+sqrt+rem on one carry-save datapath),
    the transcendental DSP-mapping + shared mul128, the fx_sqrt prune, the board-fit
    situation (FP-correctness bloat in the inlined fx_round_pack_f, not
    transcendentals), and the in-progress spine fx_* dedup. Flags the local
    fx_div_exact STUB as a temporary board hack, not a real fix.
2026-06-20 verif/cov: update the coverage flow for the FPU overhaul
    The FPU was reworked (unified FDIV/FSQRT/FPREM carry-save datapath in
    fpu_srt_div.sv; transcendentals on DSP48 + shared mul128 via fpu_trsc_wideint.svh;
    VEN_FPREM now default-on in the build). Coverage-flow updates:
    * tx_fprem PASSES now (FPREM no longer deferred) -> dropped from KNOWN_FAIL in
    run-cov.sh; it is now a plain make-verify test (make verify is fully green).
    * tx_unifdiv (new, passes): exercises the unified datapath -- exact/inexact
    FDIV, perfect/non-perfect FSQRT, FPREM/FPREM1 + FABS/FCHS -- over varied
    operands. Drives fpu_srt_div.sv to 84% line / 88% toggle in the FLAGS lane
    (vs 65% from the divide-on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
2026-06-21 dbg: freeze-on-Nth-match comparator -> freeze the PC ring
    The DOS-Quake #DE triple-faults -> CPU reset, which re-runs BIOS over the PC
    ring and wipes the faulting trajectory before any post-hoc instrument reads it.
    Add a freeze trigger: the retire comparator gains cfg[19]=freeze-mode and
    cfg[31:24]=skip-count; on the Nth match it latches, stops, and pulses
    dbg_cmp_freeze. ven_soc_dbg gets an ext_freeze input that sets the sticky frozen
    flag, and BOTH rings now gate writes on !frozen -> once frozen, a subsequent
    reset cannot overwrite the trail. Wired dbg_cmp_freeze -> u_dbg.ext_freeze in
    ventium_kv260_core. run.sh default freezes at the reset vector (eip=0xfff0) so
    the frozen ring holds the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
2026-06-21 dbg: freeze-on-#DE — freeze the PC ring the instant a divide #DE fires
    The DOS-Quake #DE jumps to the reset vector and the PC ring clears there, so
    every post-hoc instrument (freeze-at-reset, breakpoints) only saw post-reset
    BIOS. Catch it AT the fault instead: core_exec.svh sets a sticky dbg_div_fault_q
    at both #DE-delivery points (DIV/IDIV start_fault(vec 0)); core.sv drives a new
    dbg_div_fault output (reset-cleared); ventium_top ORs it into the PC-ring freeze
    under cfg[20] (freeze-on-#DE). The frozen ring then holds the trajectory INTO the
    DIV before any reboot. run.sh defaults CMP_CFG=0x00110000 (en+freeze-#DE), drops
    the dead --bp probe; regs.h adds VEN_CMP_FREEZE_DE; ven_soc_app dump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
2026-06-21 dbg: comparator HW-freezes the core clock -> clock-step the fast-path drift
    Wire the debug-ring frozen flag (set by a retire-comparator match) into the
    gated-core-clock enable (core_clk_en &&= !d_frozen) so a HARDWARE comparator
    match freezes the core clock with zero PS latency. Revert the HALT-at-#DE (the
    core must free-run to the drift; the comparator freeze replaces it). run.sh arms
    the comparator to freeze at cs=0x70:0x245 (just before the 0x248 fast-path drift),
    then clock-steps forward one core clk at a time, watching the committed eip
    advance 0x248->0x24d (correct) vs 0x248->0x24e (drift). make verify byte-identical
    (halt removed -> original deliver path).
    Claude-Session: https://cla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
2026-06-21 docs: catalog the full debug-instrumentation suite + conclude RTL debug work
    Document every debug feature built for the F4A silicon bug-hunt in the Sphinx
    debug-instrumentation page: the opcode-capture hook, the PS-programmable retire
    comparator + three freeze triggers (freeze-on-Nth-match, freeze-on-#DE,
    fault-freeze on the Nth exception delivery), the strict clock-step (BUFGCE-gated
    core clock, RUNCTL[4]/[5]), the clock-freeze coupling that defeats the #DE
    triple-fault rst_n, and a new 'gate-level simulation' section on why Verilator
    structurally can't see synthesis-declone / collision / X-init bugs and how xsim
    on the synthesized netlist does. Also commits the GLS tooling (in-context decl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
2026-06-23 core: DOS-Quake CPU/DPMI ISA fix chain — resolve the "Division by Zero"
    A chain of qemu-`-cpu pentium`-confirmed real-mode/PM ISA fixes that gets
    DOS-Quake (FreeDOS + go32/CWSDPMI) past the long-standing "Division by Zero
    at eip=0x24e" early-exit. The boot now runs correctly through CWSDPMI's INT
    0x31 / DPMI dispatch. make verify GREEN (98/98); make verify-sys all gates
    SYS-GOLDEN-OK.
    Fixes:
    1. 16-bit ENTER + SMSW (real-mode operand-size forms).
    2. PM pop-sreg base (core_exec.svh): `pop ds/es/ss` used the real-mode
    `sel<<4` base in protected mode -> now diverts to S_SEGLD descriptor walk.
    Directed test verif/sys/tests/pseg.
    3. PM far RETF (core_fetch_decode.svh + core_seg_ljmp.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
2026-06-24 fpu: x87 PRECISION CONTROL fix — board-F5 DOS-Quake root cause
    Board-F5 (DOS-Quake on KV260) diverged because the x87 FP path ignored
    precision control: it computed 64-bit extended where Quake runs PC=24-bit
    single precision, so every FADD/FSUB/FMUL/FDIV kept ~40 extra mantissa bits
    vs a real PC=24 machine. The error accumulated across the per-frame math into
    a wrong FIST loop bound -> null-deref in the game loop.
    Fixed on BOTH FP paths:
    * PS (the BOARD's actual FP — FP_PS_ALL puts all x87 on the A53 because it
    is too large for the PL): ven_fp_ps.c now sets extF80_roundingPrecision
    from fctrl[9:8] at the trap dispatch. (This is the board fix — needs no
    bitstream respin,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
2026-06-24 fpu: restore real x87 denormal divide as default (gate the board-fit stub)
    The board-fit stub `q = num >> 7` (the ~43.5K-LUT 192-bit denormal divide
    crudely replaced by a shift, labeled "NOT for commit") leaked into the committed
    tree in 8c03858 — it was meant to stay local for over-utilizing full-FP PL
    builds only. Gate it behind +define+VEN_FPDIV_BOARDFIT so the committed DEFAULT
    is the REAL divide (q = num / mb; rem = num % mb), keeping committed code correct.
    The FP_PS_ALL board (FP runs in the PS) never uses fx_div, and the main FDIV is
    fpu_srt_div.sv (separately OOC-gated bit-exact), so the stub only corrupted
    sim/verification denormal-divides, not the board's Quake. Compile-verifie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
2026-06-25 fpu: complete x87 precision-control for fx_div + add fx_div OOC gate
    fx_div's normal-operand path called the behavioral fx_srt_div FUNCTION without pc,
    so normal divides via the behavioral reference rounded to 64-bit and skipped the
    PC=24/53 reduction. The session's PC fix covered the module fpu_srt_div (the core's
    FDIV) and fx_div_exact but missed this function. Thread pc through fx_srt_div and
    parameterize its round position by PCBITS — a SINGLE round to PC (not 64-then-PC
    double-round); the SRT residual (over-estimate) logic is unchanged. Both callers
    pass pc.
    Add an OOC gate for the behavioral fx_div: run-fxdiv-gate.sh + fxdiv_dut.sv +
    tb_fxdiv.cpp, plus a DENORM_ONLY mode in gen_div_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
2026-06-25 kv260/soc: serialize deploy.sh + clear stale VGA carveout (false-#DE fix)
    deploy.sh: add a flock so a --bitstream reload can never overlap a live --run.
    The overlap strands an in-flight AXI burst during xmutil overlay removal and hangs
    the PS host hard (ssh "No route to host"; recovery = power-cycle). One board op at
    a time — a second invocation waits, then refuses.
    ven_soc_app.c (--dos): wipe the VGA carveout (0xA0000..0xC0000) at startup so a
    stale "Division by Zero" banner left by a PRIOR run can't false-trigger the
    run-kill fault scan (the carveout DDR persists across runs). This was the root
    cause of the deterministic board "#DE": DBG observability showed the core was in
    SeaBIOS earl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
2026-06-26 core: fix V86 task switch segment load (DOS-Quake #DE root cause)
    S_TSW_SEG loaded all six segments as protected-mode GDT descriptors
    unconditionally, ignoring the incoming task's V86 flag (tsw_eflags[17],
    already latched at the TSS read). For a V86 incoming task this fed the
    task's real-mode segment paragraphs into a GDT descriptor walk, producing
    a corrupted CS/base/CPL/D-bit -- the task resumed as PM CPL3 (cs=0x2b)
    executing real-mode code (mov es,0x2593), which faults in PM. That is the
    CWSDPMI 0x60/0x70 co-routine's spurious "Division by Zero" that blocked
    DOS-Quake on silicon. The bug is deterministic (not a timer-cadence race)
    and was invisible to the prior non-V86 task-switch gates,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
2026-06-26 soc: integrate the System Bridge (L1+cachemap+L2/NB) into pure-RTL ventium_soc (opt-in)
    Pure-RTL Core + System Bridge + Peripherals, per the FreeDOS/Quake goal. Behind
    +define+VEN_SOC_L2 (default OFF = byte-identical; the differential SoC is unchanged by
    this — the soc gate's current failure is pre-existing, from parallel in-flight core/
    peripheral edits, and reproduces identically with these changes reverted).
    ON: ven_l1d (L1) + ven_cachemap (KEN#) + ven_northbridge (L2 + uncacheable bypass + MMIO
    split) sit on the muxed CPU+DMA stream, so CPU and DMA share one L1 (coherence automatic:
    write-through L1, later reads hit the updated line). NB d_*/mmio_* merge onto the single TB
    mem bus (on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
2026-06-27 tb: VEN_GPTRACE VMTRACE — refine DOS-Quake #GP to a real<->PM mode-switch fault
    Adds a cs/EFLAGS.VM transition log (VEN_GPTRACE, n>8.8M). CORRECTS the earlier "V86"
    framing: VM=0 throughout — the DOS-Quake fault is a RAW real-mode<->protected-mode switch
    (DPMI host), NOT V86. The program runs at real-mode segment cs=0x26ac (ss=2c70, low
    eflags) and PM mirror cs=0x2b (base 0x26ac0 == 0x26ac<<4), rapidly switching with
    0xd9/0x5f7/0x70/f000; NT=1 (nested task) appears (eflags=0x7083). The #GP is a real-mode
    segment load (0x26ac) executed while still in PM -> the PE-clear/far-jump real-mode
    transition (or the NT/task-switch IRET) isn't switching the core's segment interpretation.
    Deep core m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
2026-06-27 tb: VMTRACE adds CR0.PE — DOS-Quake #GP is a data-dependent 3rd-iteration divergence
    VMTRACE now logs CR0/PE. KEY FINDING: the DPMI raw real<->PM mode switch WORKS — 2 full
    iterations are clean (real cs=0x26ac PE=0 cr0=0x10 -> PE=1 cs=0x18/0x87 cr0=0x11->0x80000019
    -> cs=0x2b -> back to real). On the 3rd iteration the cs=0x2b code takes a DIFFERENT path
    (eflags diverge: iter2=0x3246 ZF=1 vs iter3=0x3212 ZF=0 -> a conditional branch flips),
    runs to 0x79d `mov bx,0x26ac` and loads 0x26ac (a real-mode SEGMENT value) while PE=1 (PM)
    -> #GP, delivered to the handler at cs=0x18:0x7a0. So it is NOT a broken mode switch; it's a
    data-dependent divergence on iter 3 that yields a real-mode segment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
2026-06-27 tb: VEN_GPTRACE go32/coroutine traces (GO32W/GAP/WRK) for DOS-Quake #GP diff
    Adds gated (VEN_GPTRACE) traces used in the QEMU golden-diff of the DOS-Quake go32 coroutine
    #GP: GO32W (cs=0x18 0x2b04..0x2b73 window), GAP (all-retire across iters), WRK (worker cs=0x87
    resume points), VMTRACE+CR0/PE. golden-diff finding: QEMU renders DOS Quake (disk good, RTL
    core has the bug). The go32 scheduler is a 3-task green-threads COROUTINE (TSS 0x68/0x60/0x70);
    the HW task switch is CORRECT (loads what the guest wrote). Root = the coroutine WORKER runs at
    the WRONG CS on iter2+ — RTL uses cs=0x2b (GDT[5]) where QEMU uses cs=0x87 (LDT[16], TI=1) —
    derailing -> guest computes wrong resume eip 0x512e (v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
2026-06-27 tb: VEN_GPTRACE GAP register diff — DOS-Quake #GP root = 16/32b EBX/EDX high-bits loss
    The GAP trace now logs cs:eip + eax/ebx/ecx/edx/flags for the worker span, enabling a
    register-level golden-diff vs QEMU (gdb single-step). RESULT: at the coroutine worker's first
    instruction (cs=0x87:0x233) the RTL already has ebx=0x3772/edx=0x7cf where QEMU has
    ebx=0xe3772/edx=0x8007cf — LOW 16 bits match, HIGH 16 zeroed in RTL (eax fully correct, so
    not blanket truncation). A 32-bit (0x66-pfx) op in 16-bit code drops the upper 16 of EBX/EDX.
    Causal chain CONFIRMED: wrong high bits -> 32-bit op at cs=0x87:0x247 sets wrong flags
    (RTL fl=0x44 vs QEMU 0) -> jcc at cs=0x26ac:0x15cd flips (RTL taken->0x15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
2026-06-27 tb: VEN_GPTRACE BOOT probe (real-mode boot-sector retire trace) for opsz unit tests
    Adds a gated [BOOT] retire trace (linear 0x7c00..0x7f00, real-mode cs<0x1000, pc<0x10000) so a
    boot-sector unit test's instruction flow + esp can be followed. Used to prove the 32-bit
    POP-to-memory (66 8F /0) works correctly (esp+=4, value stored full-32) and is NOT the DOS-Quake
    truncation root. Inert unless VEN_GPTRACE.
2026-06-27 core: 16-bit LEA must preserve dest[31:16] (DOS-Quake EBX/EDX high-bit-loss root)
    core_gpr_wb.svh: the LEA register writeback wrote the FULL 32-bit effective address
    (gpr_wd[q_dst_reg]=q_ea) regardless of operand size. A 16-bit LEA (lea r16,[m]) must write
    ONLY the low 16 bits and preserve dest[31:16]; only a 32-bit LEA overwrites the whole register.
    The RTL zeroed dest[31:16] on every 16-bit LEA.
    This is the DOS-Quake #GP root: go32's exec() loader holds the client entry EBX (0x000e0006) and
    issues `lea bx,[bp-0x18]` (cs=05f7:0x7815, 8d 5e e8) around a memcpy-helper call, relying on
    EBX[31:16] being preserved. The RTL zeroed it -> EBX=0x6 -> copied into the client TSS frame ->
    the coroutin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
2026-06-27 core: same-priv PM int pushed handler CS, not interrupted CS (DOS-Quake #GP fix)
    The PM IDT same-privilege delivery (core_int_deliver.svh S_INT_CS -> S_INT_PUSH)
    loaded seg_sel[SG_CS] <= int_gate_sel (the HANDLER CS) before S_INT_PUSH pushed
    the exception frame, and the same-priv frame-CS push in core_bus_driver.svh read
    the (now-overwritten) seg_sel[SG_CS] -> the frame captured the HANDLER CS instead
    of the INTERRUPTED CS. The cross-priv arm already captures int_old_cs before the
    overwrite and pushes that; the same-priv arm did not.
    Masked by the CPL0 corpus (handler CS == interrupted CS, both 0x08, so old==new).
    Exposed by DOS Quake's go32/DPMI: int 0x31 from the client (cs=0x87 LDT, DPL3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
2026-06-27 core: implement PROTECTED-mode LSS/LFS/LGS (was real-mode-only -> HALT)
    LSS/LFS/LGS (0F B2/B4/B5) far-pointer loads were decoded only when seg_real;
    in protected mode the mem form fell through to d_unknown -> S_HALT. DOS Quake's
    go32/DPMI host uses `lss esp,cs:[0x409d]` (32-bit m16:32, loads SS=0x8f LDT)
    to restore its PM stack after an int-0x31 'simulate real-mode interrupt' call,
    so the pure-RTL core HALTED there (right after the #GP fix let the client get
    that far).
    Fix: decode the mem form in PM too; in the seg-load exec hook add a PM far-ptr
    arm that latches the selector (high half of the 4-byte read for a 16-bit ptr,
    or the 2-byte 2nd read for a 32-bit ptr) and walks the GDT/LDT in S_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
2026-06-28 core: fix S_LOAD2 paging cur_lin for far-ptr seg-load (DOS-Quake null-SS #GP)
    The dTLB-lookup linear (cur_lin) for state S_LOAD2 only covered the CMPS
    [EDI] 2nd-operand case (dbase_edi+str_edi). The bus driver's S_LOAD2,
    however, computes four different linear addresses (BOUND/CMPXCHG8B, far-ptr
    seg-load LSS/LFS/LGS, far JMP/CALL indirect m16:32, and CMPS). For the
    far-ptr seg-load's 2nd read the bus driver produced the correct linear
    (dbase+q_ea+q_w) but cur_lin produced the stale CMPS address, so under
    paging the dTLB was looked up at the wrong linear and mem_xlate returned
    the wrong physical -> the selector read returned 0 -> null SS -> #GP.
    DOS-Quake's go32/CWSDPMI AX=0x300 return 'lss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
2026-06-28 verif/cov/opgen: script-generated per-opcode P54C regression suite (foundation)
    Build the per-opcode regression suite from the machine-readable opcode reference
    (ref.x86asm.net x86reference.xml) instead of writing tests by hand, so no opcode
    is missed. Pipeline:
    gen_opspec.py -> filters the reference to Pentium P54C (proc_start<=5; MMX/
    SSE/PPro + 64-bit-only excluded) = 555 opcode encodings
    (372 ModRM, 283 group /digit, 141 x87). Emits opspec.json +
    opspec.txt (THE authoritative per-opcode checklist).
    gen_easweep.py -> exhaustive ModRM/SIB effective-address sweep via LEA (697
    forms; zero-fault, QEMU-checke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
2026-06-28 core: implement nested ENTER (0xC8, level>0)
    ENTER imm16,level with level>0 (nested display copies) was d_unknown ->
    S_HALT; only level-0 was implemented. DOS-Quake hits ENTER level 2 in real
    mode (a function prologue reached via the go32 DPMI->real switch).
    Add an isolated S_ENTER micro-sequence (no change to the shared dseg comb,
    so other ops are byte-identical): on level>0 the S_EXEC SM_ENTER arm routes
    to S_ENTER instead of S_STORE. Beats: push EBP @ SS:[ESP-w]; for j=1..level-1
    read SS:[EBP-j*w] then push it; push FrameTemp(=ESP-w); finally EBP<-FrameTemp,
    ESP<-ESP-(level+1)*w-alloc. All accesses use the explicit SS base + stk16 wrap
    (ENTER is a stack op; the generic dbase resolves to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
2026-06-28 verif/cov/opgen: real-mode/CPL0 MODE lane vs qemu-system
    Add the mode dimension: gen_modes.py emits bare-metal -bios opcode streams for
    the modes the PM32/user lane cannot reach (real-mode CPL0 to start), and
    run-modes.sh diffs each per-record against the qemu-system-i386 golden (the same
    oracle the sys gate uses).
    realmode_flags: CLI/STI/CLC/STC/CMC/CLD/STD + LAHF/SAHF + PUSHF/POPF/PUSHFL/POPFL
    + 16-bit ALU + privileged SMSW/MOV CR0/MOV DR7 -> EQUIVALENT to qemu-system at
    CPL0/real-mode. This CONFIRMS the PM32/user MODE-CPL0 findings (CLI/STI/POPF) are
    CPL3-user-mode semantics, not core bugs, and covers the privileged register
    paths that #GP in user mode. Framework supports adding PM32-CPL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
2026-06-28 core: add S_ENTER to the paging translatable set (nested ENTER under paging)
    The nested-ENTER micro-sequence (S_ENTER) was missing from the xlate_miss
    'translatable' state list, so under paging its stack reads/writes used the
    untranslated linear address -> wrong physical -> the FSM stalled (the access
    never completed). Caught by verif/cov/opgen: a hand-added ENTER level-3 test
    (op_c8ent) DIVERGED (RTL retired only the setup, ENTER never retired); with
    S_ENTER translatable it is EQUIVALENT to qemu (PM32). Real-mode nested ENTER
    (paging off) was already fine.
    verify 98/98 GREEN; verify-sys 949/949 EQUIVALENT; opgen op_c8ent PASS.
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2026-06-28 verif/cov/opgen: IN/OUT covered by --cosim lane, not plain --system mode
    realmode_io diverges only because plain tb --system does not service the I/O bus
    (no device/cosim model), so the core stalls on IN/OUT -- a TB limitation, not a
    core finding. IN/OUT/INS decode + S_IO are covered by the --cosim covio lane.
    Mode lane stays clean (realmode_flags + realmode_seg PASS vs qemu-system).
2026-06-28 verif/cov/opgen: MUL/DIV/CMPXCHG/AAM-AAD/ENTER-LEAVE handlers + coverage report
    Add handlers closing real gaps: 1-operand MUL/IMUL/DIV/IDIV (F6/F7 /4-7, implicit
    AX/EDX:EAX, divide-safe setup); CMPXCHG (0F B0/B1); AAM/AAD (reference mnem
    AMX/ADX); ENTER/LEAVE (stack-frame). 436 GEN, 396 PASS + 29 KNOWN + 0 NEW-FAIL
    (clean). MOV moffs (A0-A3) cataloged as a known core gap (not decoded).
    coverage_report.py: precise 555-opcode accounting (TESTED/FINDING/lane-covered/
    SKIP-justified vs UNCOVERED) -- makes the 100%-ISA goal measurable.
2026-06-28 verif/cov/opgen: self-improve -- cycle-mode coverage pass + make opgen target
    Self-improvement: run-opgen.sh now adds a parallel --cycle coverage pass over the
    built flats (coverage-only) after the differential -- the dual-issue fast path
    single-issue functional runs miss. Lifts decode.sv 69%->100% line, core_fastpath
    to 92.6%, opgen core line coverage 56.4%->59.6%. Disable with CYCLE=0.
    Wire 'make opgen' (regenerate + run + 555-opcode accounting) and 'make
    opgen-modes' (real-mode/CPL0 lane vs qemu-system) into the build.
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2026-06-28 verif/cov/opgen: self-improve -- carry-in diversity for ADC/SBB/RCL/RCR
    ADC/SBB (carry-in adder) and RCL/RCR (rotate-through-carry) results depend on CF;
    each now runs with CF=0 (CLC) and CF=1 (STC) so the carry-in path is exercised
    both ways -- a flag-logic dimension the single-state sweep missed. All pass (no
    new findings: the core's carry-in is correct). Suite stays clean.
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2026-06-28 verif/cov/opgen: self-improve -- REP/REPE/REPNE termination test (op_rep)
    Add a dedicated string-loop test exercising the rep-control decode the minimal
    op_prefixes test doesn't reach: full-count REP MOVSB, REPE CMPSB that terminates
    EARLY when bytes differ (ZF->0), REPNE SCASB that stops on a match (ZF->1), and a
    REP with ECX=0 (the immediate-no-op ECX==0->S_EXEC arm in core_fetch_decode).
    PASSES vs QEMU. Covers the data-dependent rep terminate paths.
2026-06-28 verif/cov/opgen: self-improve -- completeness guard against silent partial runs
    The runner now counts produced .res files vs selected tests and reports 'ran N'.
    If any worker died (usually qemu gdbstub port/resource exhaustion at high -P), it
    prints an INCOMPLETE warning + suggests a lower JOBS, and the final verdict is
    'INCOMPLETE — not a clean verdict' instead of a false 'CLEAN'. Prevents a
    resource-contended partial run from masquerading as all-pass.
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2026-06-28 verif/cov/opgen: NEW finding -- transcendental engine HALTs on inf/NaN inputs
    The transcendental-sweep edge-input probe surfaced a real gap in the feature
    build: FSIN/FCOS/... of +inf/-inf/NaN HALT the core (confirmed across +inf/-inf/
    qNaN) instead of setting C2(invalid)+returning NaN per IEEE -- range reduction of
    a non-finite operand is unhandled. Cataloged + repro added (finit;fldl inf;fsin).
    This is why the edge inputs didn't lift coverage: the engine halts on them.
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2026-06-28 verif/bus: tb_biu_p5 pipelined+locked scenario -> biu_p5 toggle 63.3->68.0%
    Add run_pipelined_locked: a locked READ pipelined ahead of a locked WRITE (NA#
    pipelining + req_lock=1 on both), so the promotion of the 2nd locked cycle hits
    the previously-uncovered p_lock arm of the promote block (biu_p5.sv:569-570) and
    toggles the lock/pipeline datapath. biu_p5 standalone toggle 63.3%->68.0%; 78/78
    SVA+self-checks pass, 0 FAIL. Asserts LOCK# releases after the locked write.
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2026-06-28 verif/bus: tb_biu_p5 a_in snoop-address sweep -> biu_p5 toggle 91.8->93.0%
    run_ain_sweep walks a_in[26:0] using the correct snoop model (biu_p5:672: HIT#
    iff a_in!=0, MODIFIED iff a_in[0]==1): non-modified hits over a_in[26:1] + the
    a_in[0]=1 modified case and its HITM#-release writeback. Toggles the snoop-address
    input + snoop_hit/snoop_inv datapath. biu_p5 toggle 91.8->93.0%; 196/196 checks
    pass. Cumulative this session: biu_p5 toggle 63.3->93.0% (+29.7%), 6 scenarios.
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2026-06-28 verif/sys: ptask all-ones EAX/EBX -> tsw_gpr toggle 404->452
    Make TSS2's incoming EAX/EBX all-ones too (the differential compares the execution
    trace, not fixed marker values, so qemu reloads the same -> still EQUIVALENT). Now
    7 of 8 incoming GPRs toggle fully both directions across the two switches. tsw_gpr
    43->452 of 512 (88%); the residual 60 is the ESP datapath (stack-address-limited,
    0x70000 vs 0x60000). core.sv toggle 66.6->68.0%.
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2026-06-28 verif/sys: ptask diverse TSS EFLAGS -> tsw_eflags 1->13 (+ CR3 finding)
    Set TSS2 EFLAGS to diverse status flags (CF/PF/AF/ZF/SF/OF) so the task-switch
    EFLAGS-reload datapath (core.sv tsw_eflags[]) toggles. tsw_eflags 1->13, EQUIVALENT.
    FINDING (not applied): setting TSS.CR3 diverse DIVERGES vs qemu-system -- at the JMP
    task switch (pc 0xf024e) the core loads TSS.CR3 into CR3 (got 0xAAAAA000) while
    qemu keeps CR3=0. qemu appears to skip the task-switch CR3 reload when paging is OFF
    (CR0.PG=0); the core reloads it unconditionally. Left CR3=0 to keep EQUIVALENT;
    flagged for the core owner (possible task-switch CR3 semantics gap under PG=0).
2026-06-28 verif/cov/opgen: pm32_intsweep -> interrupt/IRET datapath +21 toggle
    16 trap gates at diverse handler offsets + INT 0x40..0x4F each preceded by POPF of
    diverse EFLAGS -> int_gate_off 45->35, iret_eflags 54->45, d_int_vec 4->2 untoggled.
    Same-priv delivery (no fault restart) stays EQUIVALENT vs qemu-system (unlike the
    #PF restart path that drifts). The remaining int_*/iret_* untoggled is structural
    (code-constant EIP/offset high bits, reserved EFLAGS bits). 14 mode streams.
2026-06-28 verif/cov: coverage-campaign report + 3 actionable core/qemu findings
    Consolidate the session's coverage campaign into a durable, reviewable report:
    per-area wins (combined-core toggle 70.58->77.46%, 12 modules 14-69%->60-100%, 2 new
    TBs), the reusable diversity-sweep methodology, the structurally-unreachable residual
    map, and -- most actionable -- the 3 core/qemu divergence findings (task-switch CR3
    reload under PG=0, repeated-#PF restart PC drift, BCD/FBLD/FPTRAP engine stalls) with
    reproduction steps for the core owner.
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2026-06-28 verif: re-sync testbenches to current RTL function signatures (TB-only, no RTL)
    Full core validation found 5 testbenches out of sync with RTL signature changes; each
    fixed in the TESTBENCH only (RTL untouched), every gate re-verified green:
    - tb_srt.sv : fx_srt_div gained pc -> pass (a,b,rc,pc=2'b11 extended,buggy). SRT-GATE-OK (609 vec)
    - tb_sqrt_iter.sv: fx_sqrt gained pc -> pass (a,rc,pc=2'b11). SQRT-ITER-GATE-OK (8000 rand)
    - tb_srt_iter.sv : connect new rem_c2/rem_ie ports. SRT-ITER-GATE-OK (609 vec)
    - tb_fppipe.sv : f_eval/f_eval_s1 gained pc+fdiv_err, f_eval_s2 gained pc; thread the
    SAME pc/err through all 3 calls (equivalence). FPPIPE-GATE-OK (1M rand)
    - p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
2026-06-29 memmodel: add env-gated VEN_RAM_TOP_MB RAM-top limit (reads above N MiB -> 0xFF, writes dropped, like qemu -m N). TESTED for Quake's #UD hypothesis (phantom-RAM probe over-sizing page tables): DISPRO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
2026-06-29 256KB BIOS BOOTS (e1000+VGA BARs+SMM stub); block +0x119 INVARIANT; RAM-bound INERT. Milestone: RTL now boots FreeDOS+FreeCom+go32 with 256KB BIOS, POST+e820 qemu-identical. But block stays +0x119 ac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
